mrwillson2u/propmesh/docs/console-show-sync.md

# Saving and playing sequences when boards come and go (2026-10-24)

Colin, trying to build the first sequences on the yard boards: "a lot
of things are broken" — boards in the picker reported as unavailable on
save though their pin editor works; Save and Play inconsistent; after
a partial save, Play dead and Save dead; boards marked yellow never
clearing when they came back. "Think through every possible scenario."

This is that audit: how a sequence moves between the console and the
boards, every state a board can be in while it does, what the console
did in each, and what it does now. One doc, so the logic has one place.

## 1. The moving parts

- A sequence is stored **on each board that has steps in it**, as that
  board's part. Save = one `set_sequence` per board (parallel), each
  stamped with the same `at` (UTC second from the console's clock).
- The console talks to boards **through the bridge** over WiFi. A
  request to a board that doesn't answer times out on the bridge after
  6 s (`REMOTE_TIMEOUT_MS`); the bridge holds at most 6 forwarded
  requests at once (`MAX_PENDING`, `pm_link.cpp`).
- The bridge **mirrors** every `set_sequence` / `delete_sequence` /
  `set_rules` it forwards (`pm_show_mirror`), whether or not the board
  answered, and bumps `show_at` on its time beacon. A board whose
  `show_synced` is behind pulls its own part (`pull_index`, `pull_seq`)
  when it next hears the beacon — a battery board on its check-in, or
  a mains board within seconds (generic-boards §6k).
- A board holding a **newer** `at` than a request's answers `ok` with
  `stale: true` and keeps its own copy.
- **Play** is one `cue` to the connected board, which broadcasts it;
  every board that holds a part and is not `off` plays. The connected
  board refuses the cue only when *it* is off.
- A battery board in the show tier listens in windows; a request to it
  is preceded by a wake burst (`pm_link.cpp` "waking"). Any
  non-background request holds it fully awake for 10 min; `hello`,
  `mesh`, `state`, `ota_status`, `ble` don't.
- The Sequences view **loads** from every board that has introduced
  itself this session: `get_config` (pins, for the pickers), `get_show`
  and one `get_sequence` per part. A board that doesn't answer is
  *unreachable*; through a bridge its part is shown from the bridge's
  copy (`fromBridge`) and its pins from the previous load.
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
