mrwillson2u/propmesh/hardware/pro/layout-placement.png

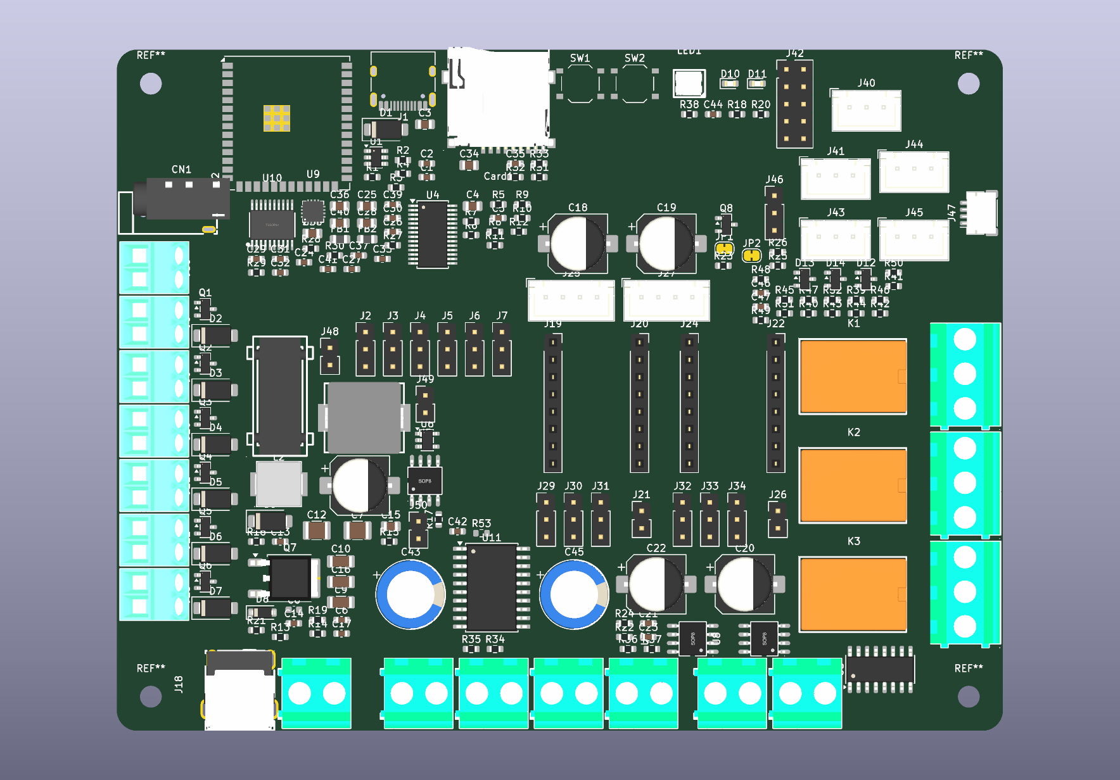
hardware/pro/layout-placement.png
