mrwillson2u/propmesh/hardware/pro/sheets/01-power.diagram.png

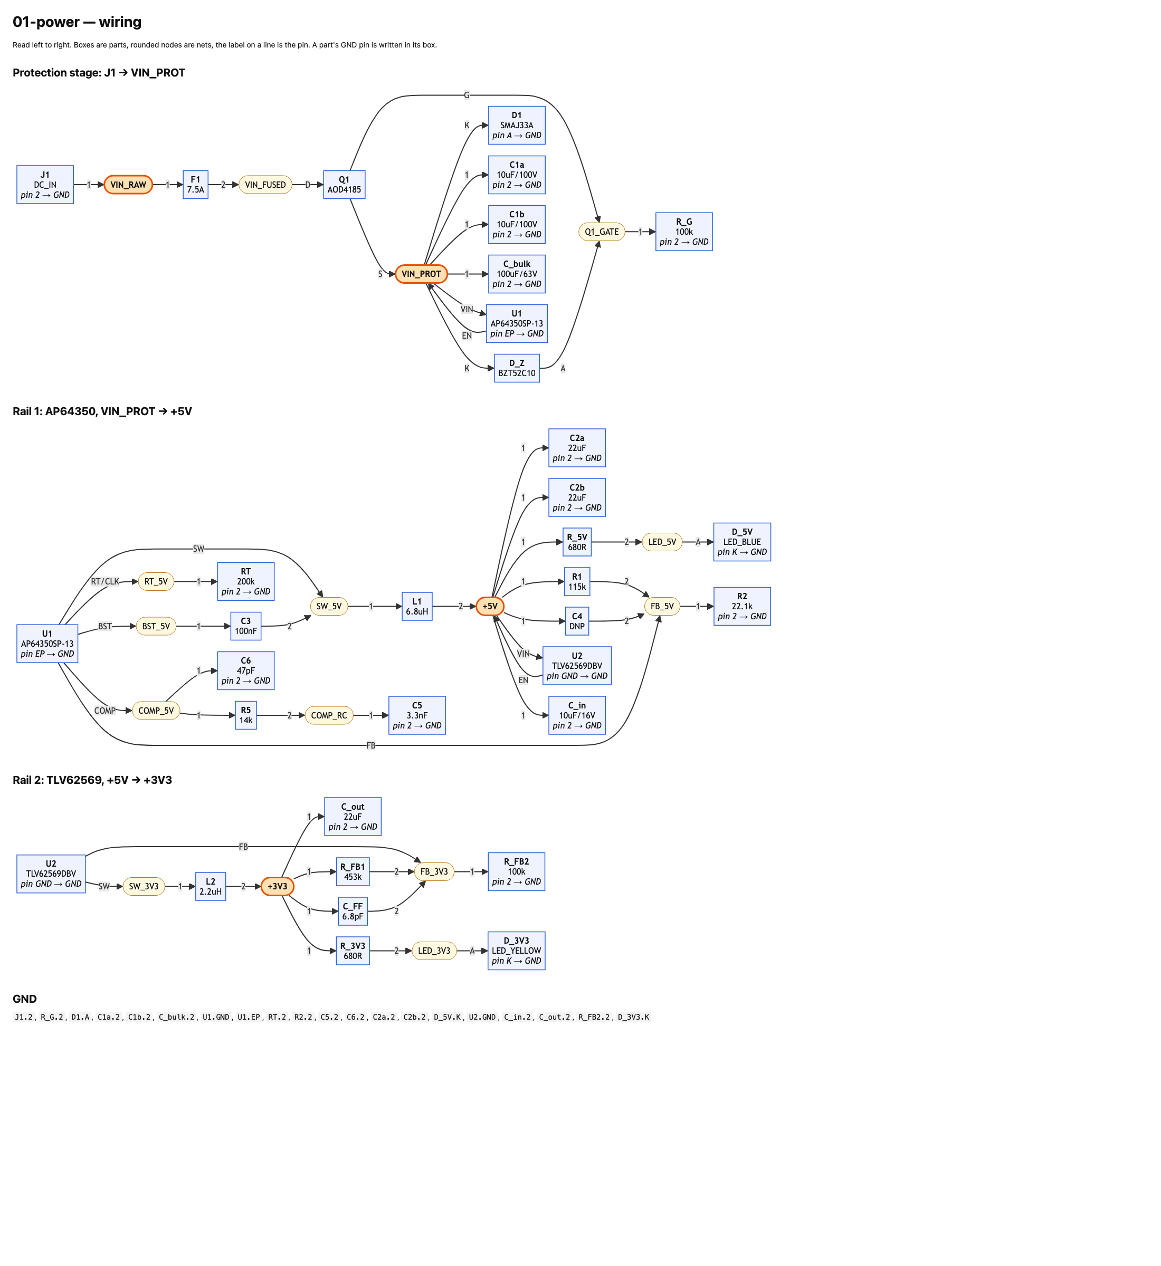
hardware/pro/sheets/01-power.diagram.png
