mrwillson2u/propmesh/reference/design_handoff_propmesh_console/screenshots/1a-survey-desktop.png

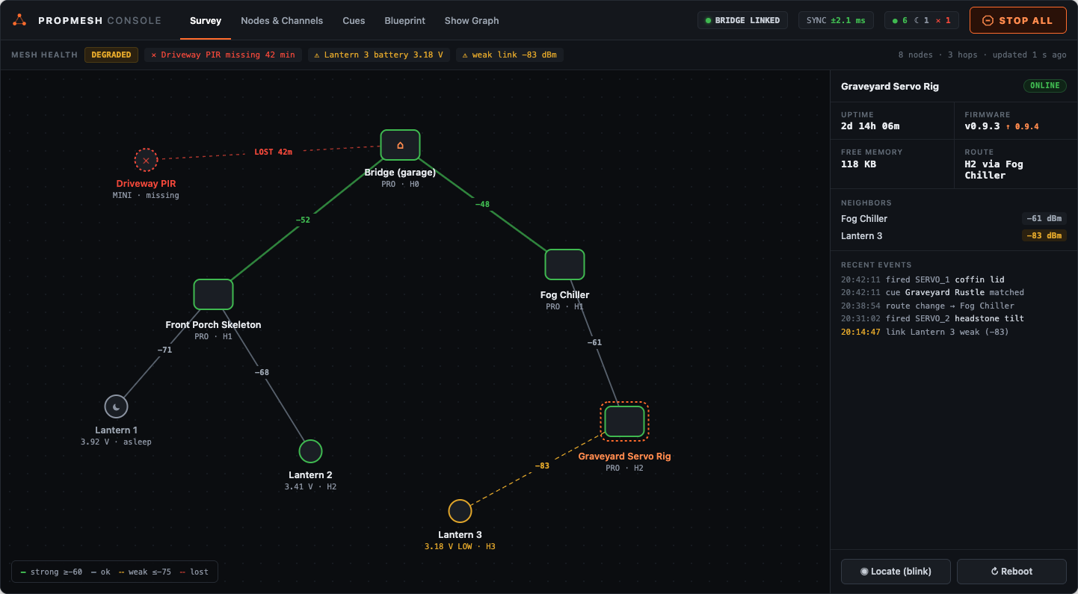
reference/design_handoff_propmesh_console/screenshots/1a-survey-desktop.png
