mrwillson2u/propmesh/reference/design_handoff_propmesh_console/screenshots/1d-cues.png

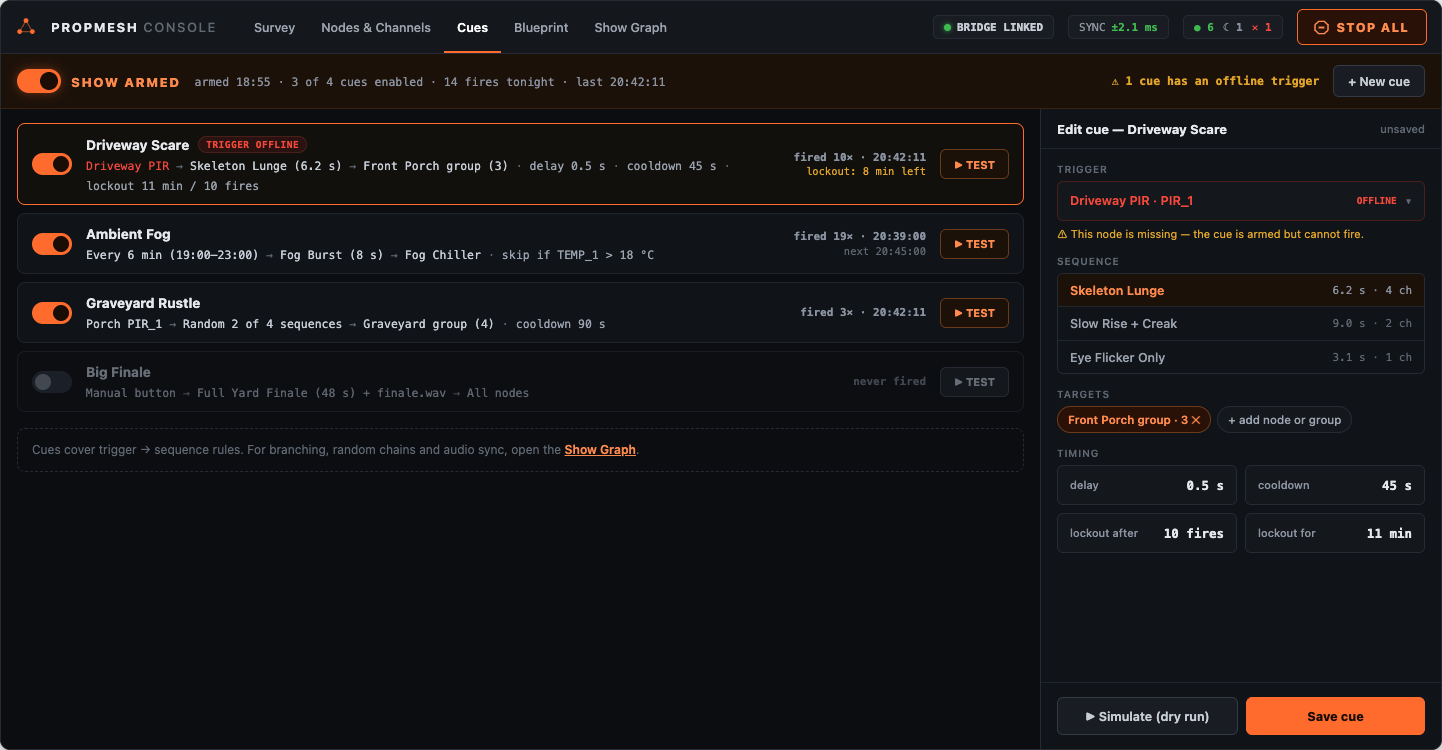
reference/design_handoff_propmesh_console/screenshots/1d-cues.png
