mrwillson2u/propmesh/reference/design_handoff_propmesh_console/screenshots/1f-blueprint-phone.png

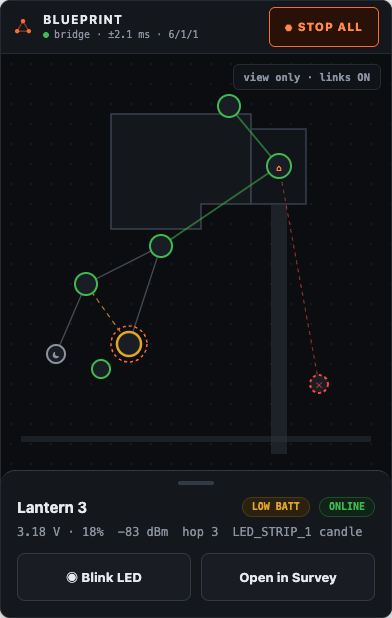
reference/design_handoff_propmesh_console/screenshots/1f-blueprint-phone.png
