mrwillson2u/propmesh/reference/design_handoff_propmesh_console/screenshots/1g-show-graph.png

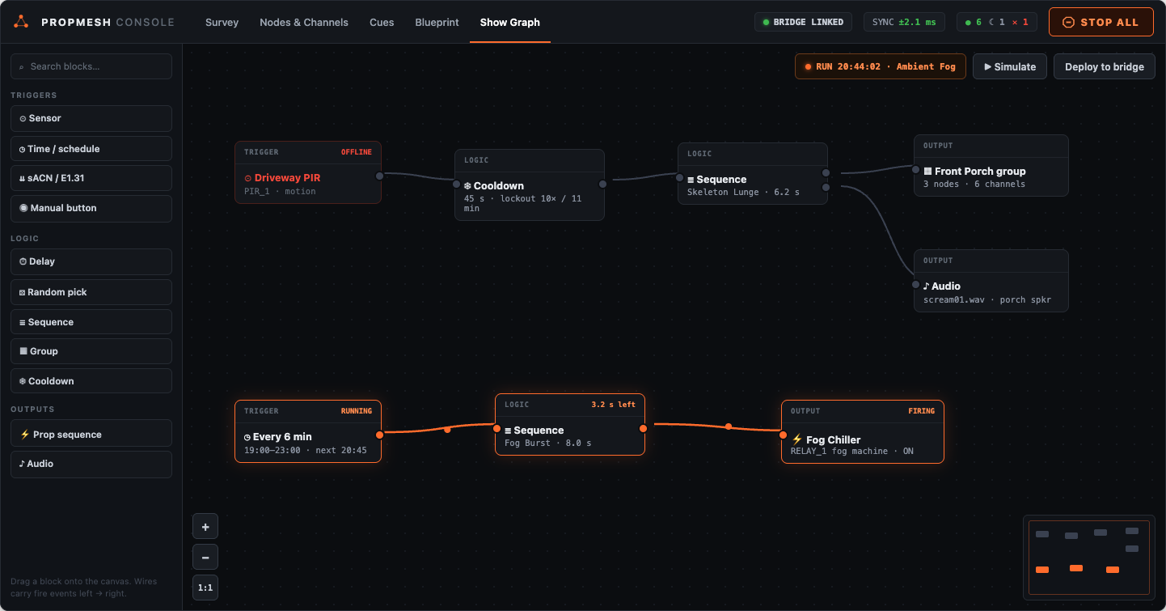
reference/design_handoff_propmesh_console/screenshots/1g-show-graph.png
