mrwillson2u/propmesh/website/src/assets/console/nodes-firmware.png

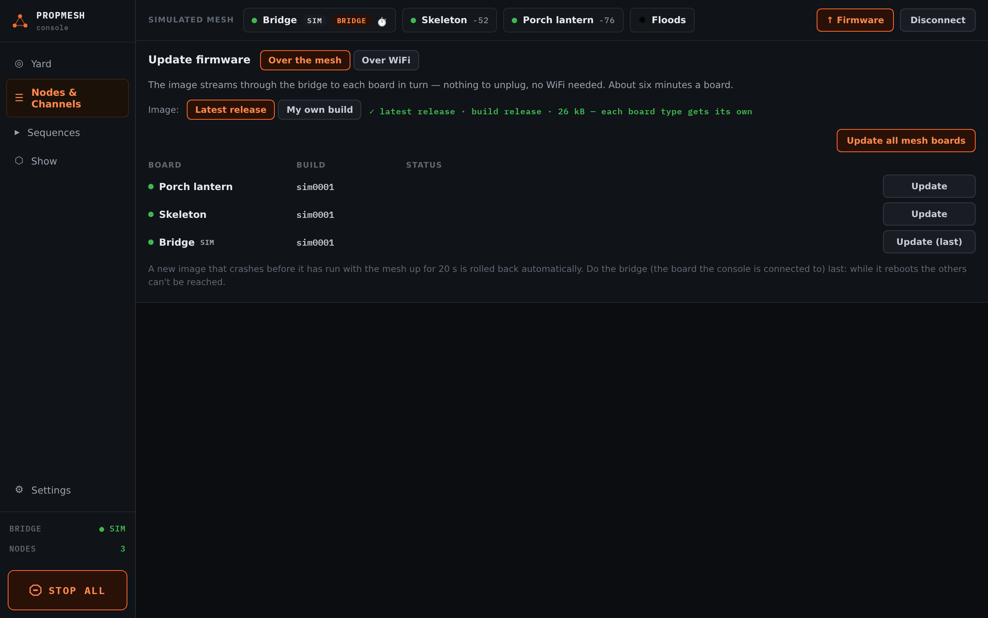
website/src/assets/console/nodes-firmware.png
