mrwillson2u/propmesh/website/src/assets/console/nodes-roster.png

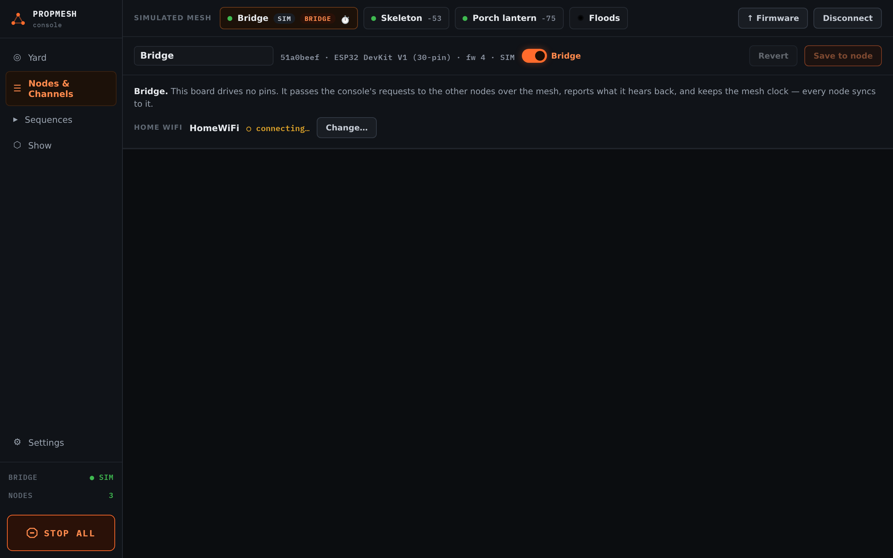
website/src/assets/console/nodes-roster.png
