mrwillson2u/propmesh/website/src/assets/console/yard-topology-detail.png

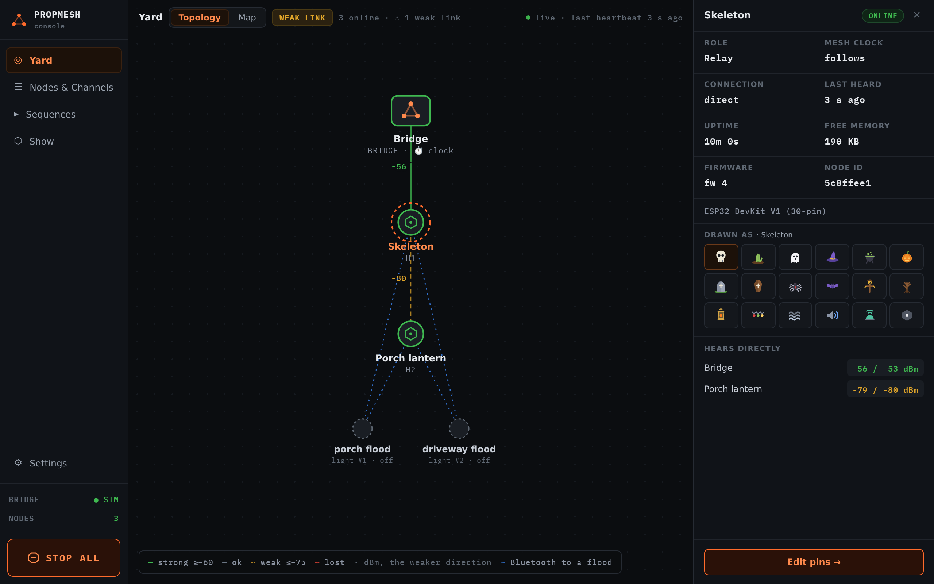
website/src/assets/console/yard-topology-detail.png
