mrwillson2u/propmesh/reference/design_handoff_propmesh_console/screenshots/1h-component-sheet.png

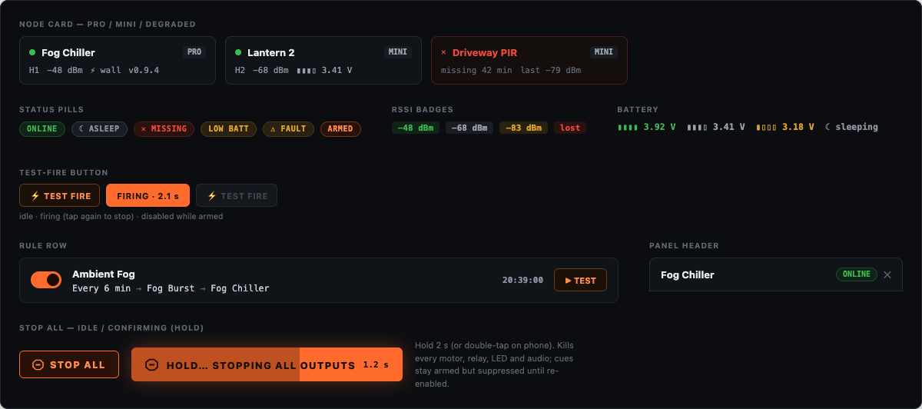
reference/design_handoff_propmesh_console/screenshots/1h-component-sheet.png
