mrwillson2u/propmesh/hardware/pro/propmesh/propmesh.kicad_pcb

## KiCad design hardware/pro/propmesh/propmesh.kicad_pcb (2026-10-11)

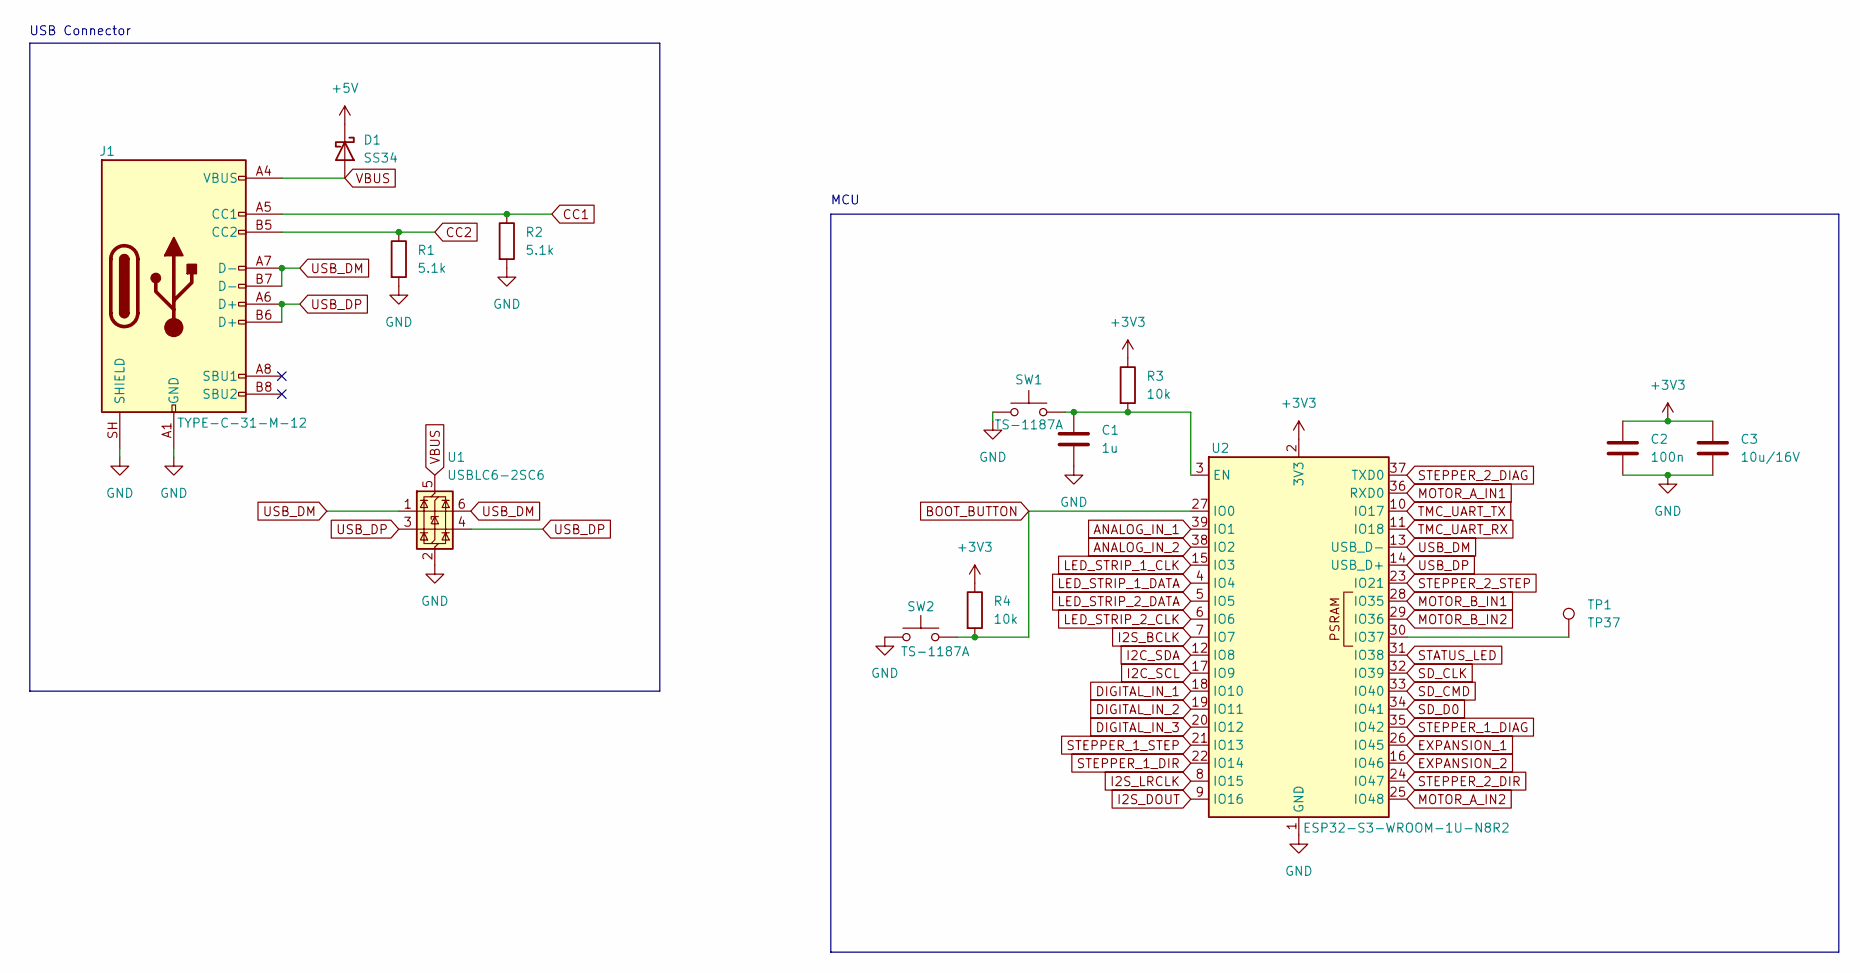
[picture p11: schematic mcu+usb.kicad_sch]

Parts:
C1: 1u; C_0603_1608Metric
C2: 100n; C_0603_1608Metric
C3: 10u/16V; C_0805_2012Metric
D1: SS34; D_SMA
J1: TYPE-C-31-M-12; USB_C_Receptacle_HRO_TYPE-C-31-M-12
R1, R2: 5.1k; R_0603_1608Metric
R3, R4: 10k; R_0603_1608Metric
SW1, SW2: TS-1187A; SW_Push_1P1T_XKB_TS-1187A
TP1: TP37; TestPoint_Pad_1.5x1.5mm
U1: USBLC6-2SC6; SOT-23-6
U2: ESP32-S3-WROOM-1U-N8R2; ESP32-S3-WROOM-1U

Connections:
+3V3: C2.1, C3.1, R3.1, R4.1, U2.2 (3V3); also elsewhere on the board
ANALOG_IN_1: U2.39 (IO1); also elsewhere on the board
ANALOG_IN_2: U2.38 (IO2); also elsewhere on the board
BOOT_BUTTON: R4.2, SW2.2, U2.27 (IO0); also elsewhere on the board
CC1: J1.A5 (CC1), R2.1
CC2: J1.B5 (CC2), R1.1
DIGITAL_IN_1: U2.18 (IO10); also elsewhere on the board
DIGITAL_IN_2: U2.19 (IO11); also elsewhere on the board
DIGITAL_IN_3: U2.20 (IO12); also elsewhere on the board
EXPANSION_1: U2.26 (IO45); also elsewhere on the board
EXPANSION_2: U2.16 (IO46); also elsewhere on the board
GND: C1.2, C2.2, C3.2, J1.A1 (GND), J1.A12 (GND), J1.B1 (GND), J1.B12 (GND), J1.SH (SHIELD), R1.2, R2.2, SW1.1, SW2.1, U1.2 (GND), U2.1 (GND), U2.40 (GND), U2.41 (GND); also elsewhere on the board
I2C_SCL: U2.17 (IO9); also elsewhere on the board
I2C_SDA: U2.12 (IO8); also elsewhere on the board
I2S_BCLK: U2.7 (IO7); also elsewhere on the board
I2S_DOUT: U2.9 (IO16); also elsewhere on the board
I2S_LRCLK: U2.8 (IO15); also elsewhere on the board
LED_STRIP_1_CLK: U2.15 (IO3); also elsewhere on the board
LED_STRIP_1_DATA: U2.4 (IO4); also elsewhere on the board
LED_STRIP_2_CLK: U2.6 (IO6); also elsewhere on the board
LED_STRIP_2_DATA: U2.5 (IO5); also elsewhere on the board
MOTOR_A_IN1: U2.36 (RXD0); also elsewhere on the board
MOTOR_A_IN2: U2.25 (IO48); also elsewhere on the board
MOTOR_B_IN1: U2.28 (IO35); also elsewhere on the board
MOTOR_B_IN2: U2.29 (IO36); also elsewhere on the board
unnamed 116: D1.1 (K); also elsewhere on the board
unnamed: C1.1, R3.2, SW1.2, U2.3 (EN)
SD_CLK: U2.32 (IO39); also elsewhere on the board
SD_CMD: U2.33 (IO40); also elsewhere on the board
SD_D0: U2.34 (IO41); also elsewhere on the board
STATUS_LED: U2.31 (IO38); also elsewhere on the board
STEPPER_1_DIAG: U2.35 (IO42); also elsewhere on the board
STEPPER_1_DIR: U2.22 (IO14); also elsewhere on the board
STEPPER_1_STEP: U2.21 (IO13); also elsewhere on the board
STEPPER_2_DIAG: U2.37 (TXD0); also elsewhere on the board
STEPPER_2_DIR: U2.24 (IO47); also elsewhere on the board
STEPPER_2_STEP: U2.23 (IO21); also elsewhere on the board
TMC_UART_RX: U2.11 (IO18); also elsewhere on the board
TMC_UART_TX: U2.10 (IO17); also elsewhere on the board
VBUS: D1.2 (A), J1.A4 (VBUS), J1.A9 (VBUS), J1.B4 (VBUS), J1.B9 (VBUS), U1.5 (VBUS); also elsewhere on the board

Notes on the sheet:
MCU
USB Connector

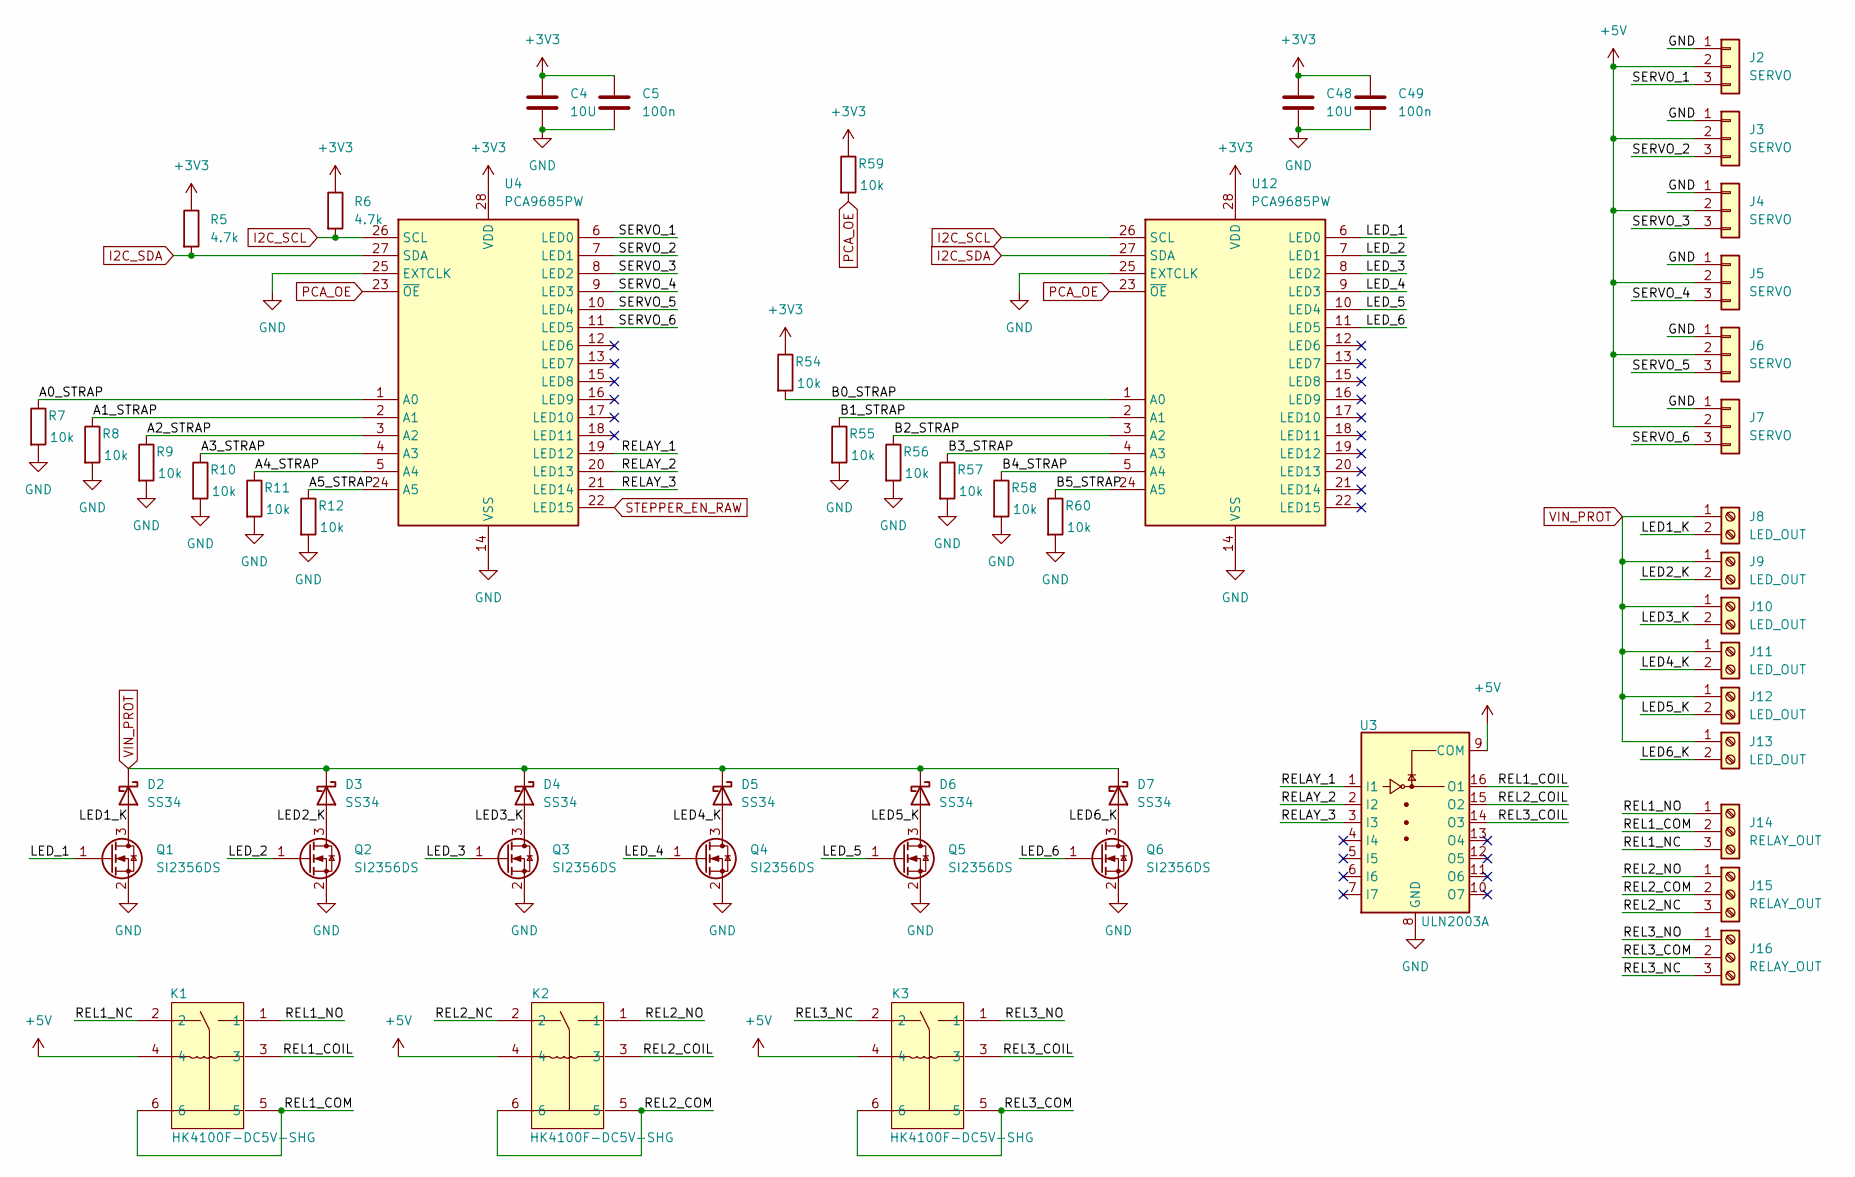
[picture p12: schematic outputs.kicad_sch]

Parts:
C4, C48: 10U; C_0805_2012Metric
C5, C49: 100n; C_0603_1608Metric
D2, D3, D4, D5, D6, D7: SS34; D_SMA
J2, J3, J4, J5, J6, J7: SERVO; PinHeader_1x03_P2.54mm_Vertical
J8, J9, J10, J11, J12, J13: LED_OUT; CONN-TH_DG381S-3.5-02P-14-00A-H
J14, J15, J16: RELAY_OUT; CONN-TH_DG128-5.0-03P-14-00A-H
K1, K2, K3: HK4100F-DC5V-SHG; RELAY-TH_HK4100F-DC5V-SHG; MPN HK4100F-DC5V-SHG; LCSC Part C12072
Q1, Q2, Q3, Q4, Q5, Q6: SI2356DS; SOT-23
R5, R6: 4.7k; R_0603_1608Metric
R7, R8, R9, R10, R11, R12, R54, R55, R56, R57, R58, R59, R60: 10k; R_0603_1608Metric
U3: ULN2003A; SOIC-16_3.9x9.9mm_P1.27mm
U4, U12: PCA9685PW; TSSOP-28_4.4x9.7mm_P0.65mm

Connections:
+3V3: C4.1, C5.1, C48.1, C49.1, R5.1, R6.1, R54.1, R59.1, U4.28 (VDD), U12.28 (VDD); also elsewhere on the board
+5V: J2.2, J3.2, J4.2, J5.2, J6.2, J7.2, K1.4, K2.4, K3.4, U3.9 (COM); also elsewhere on the board
/Outputs/A0_STRAP: R7.1, U4.1 (A0)
/Outputs/A1_STRAP: R8.1, U4.2 (A1)
/Outputs/A2_STRAP: R9.1, U4.3 (A2)
/Outputs/A3_STRAP: R10.1, U4.4 (A3)
/Outputs/A4_STRAP: R11.1, U4.5 (A4)
/Outputs/A5_STRAP: R12.1, U4.24 (A5)
/Outputs/B0_STRAP: R54.2, U12.1 (A0)
/Outputs/B1_STRAP: R55.1, U12.2 (A1)
/Outputs/B2_STRAP: R56.1, U12.3 (A2)
/Outputs/B3_STRAP: R57.1, U12.4 (A3)
/Outputs/B4_STRAP: R58.1, U12.5 (A4)
/Outputs/B5_STRAP: R60.1, U12.24 (A5)
/Outputs/LED1_K: D2.2 (A), J8.2, Q1.3 (D)
/Outputs/LED2_K: D3.2 (A), J9.2, Q2.3 (D)
/Outputs/LED3_K: D4.2 (A), J10.2, Q3.3 (D)
/Outputs/LED4_K: D5.2 (A), J11.2, Q4.3 (D)
/Outputs/LED5_K: D6.2 (A), J12.2, Q5.3 (D)
/Outputs/LED6_K: D7.2 (A), J13.2, Q6.3 (D)
/Outputs/LED_1: Q1.1 (G), U12.6 (LED0)
/Outputs/LED_2: Q2.1 (G), U12.7 (LED1)
/Outputs/LED_3: Q3.1 (G), U12.8 (LED2)
/Outputs/LED_4: Q4.1 (G), U12.9 (LED3)
/Outputs/LED_5: Q5.1 (G), U12.10 (LED4)
/Outputs/LED_6: Q6.1 (G), U12.11 (LED5)
/Outputs/REL1_COIL: K1.3, U3.16 (O1)
/Outputs/REL1_COM: J14.2, K1.5, K1.6
/Outputs/REL1_NC: J14.3, K1.2
/Outputs/REL1_NO: J14.1, K1.1
/Outputs/REL2_COIL: K2.3, U3.15 (O2)
/Outputs/REL2_COM: J15.2, K2.5, K2.6
/Outputs/REL2_NC: J15.3, K2.2
/Outputs/REL2_NO: J15.1, K2.1
/Outputs/REL3_COIL: K3.3, U3.14 (O3)
/Outputs/REL3_COM: J16.2, K3.5, K3.6
/Outputs/REL3_NC: J16.3, K3.2
/Outputs/REL3_NO: J16.1, K3.1
/Outputs/RELAY_1: U3.1 (I1), U4.19 (LED12)
/Outputs/RELAY_2: U3.2 (I2), U4.20 (LED13)
/Outputs/RELAY_3: U3.3 (I3), U4.21 (LED14)
/Outputs/SERVO_1: J2.3, U4.6 (LED0)
/Outputs/SERVO_2: J3.3, U4.7 (LED1)
/Outputs/SERVO_3: J4.3, U4.8 (LED2)
/Outputs/SERVO_4: J5.3, U4.9 (LED3)
/Outputs/SERVO_5: J6.3, U4.10 (LED4)
/Outputs/SERVO_6: J7.3, U4.11 (LED5)
GND: C4.2, C5.2, C48.2, C49.2, J2.1, J3.1, J4.1, J5.1, J6.1, J7.1, Q1.2 (S), Q2.2 (S), Q3.2 (S), Q4.2 (S), Q5.2 (S), Q6.2 (S), R7.2, R8.2, R9.2, R10.2, R11.2, R12.2, R55.2, R56.2, R57.2, R58.2, R60.2, U3.8 (GND), U4.14 (VSS), U4.25 (EXTCLK), U12.14 (VSS), U12.25 (EXTCLK); also elsewhere on the board
I2C_SCL: R6.2, U4.26 (SCL), U12.26 (SCL); also elsewhere on the board
I2C_SDA: R5.2, U4.27 (SDA), U12.27 (SDA); also elsewhere on the board
STEPPER_EN_RAW: U4.22 (LED15); also elsewhere on the board
VIN_PROT: D2.1 (K), D3.1 (K), D4.1 (K), D5.1 (K), D6.1 (K), D7.1 (K), J8.1, J9.1, J10.1, J11.1, J12.1, J13.1; also elsewhere on the board

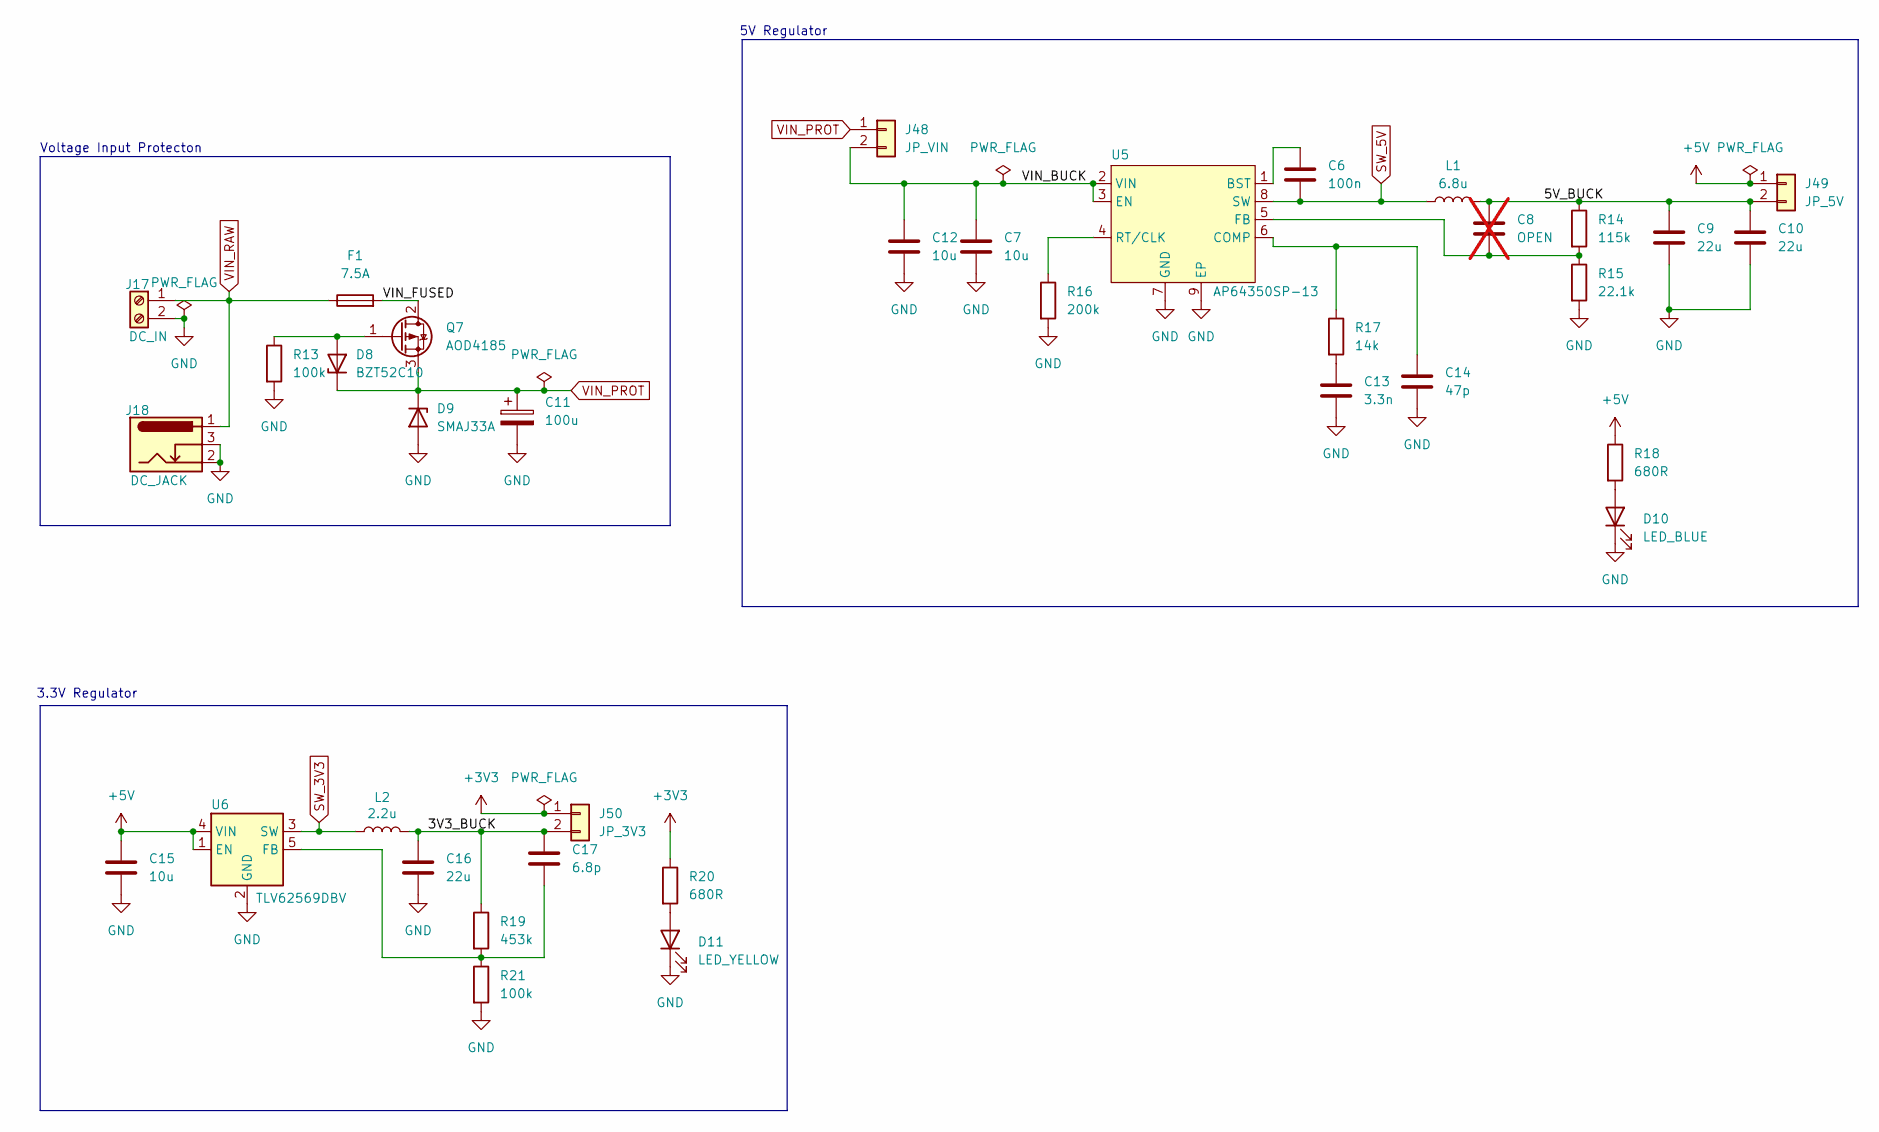
[picture p13: schematic power.kicad_sch]

Parts:
C6: 100n; C_0603_1608Metric
C7, C12: 10u; C_1210_3225Metric
C8: OPEN; C_0603_1608Metric; not fitted
C9, C10, C16: 22u; C_1206_3216Metric
C11: 100u; CP_Elec_8x10.5
C13: 3.3n; C_0603_1608Metric
C14: 47p; C_0603_1608Metric
C15: 10u; C_0805_2012Metric
C17: 6.8p; C_0603_1608Metric
D8: BZT52C10; D_SOD-123
D9: SMAJ33A; D_SMA
D10: LED_BLUE; LED_0603_1608Metric
D11: LED_YELLOW; LED_0603_1608Metric
F1: 7.5A; 01530008Z
J17: DC_IN; CONN-TH_DG128-5.0-02P-14-00A-H
J18: DC_JACK; DC-IN-TH_DC-044A-20A
J48: JP_VIN; PinHeader_1x02_P2.54mm_Vertical
J49: JP_5V; PinHeader_1x02_P2.54mm_Vertical
J50: JP_3V3; PinHeader_1x02_P2.54mm_Vertical
L1: 6.8u; IND-SMD_L11.5-W10.0
L2: 2.2u; IND-SMD_L7.1-W6.6
Q7: AOD4185; TO-252-2
R13, R21: 100k; R_0603_1608Metric
R14: 115k; R_0603_1608Metric
R15: 22.1k; R_0603_1608Metric
R16: 200k; R_0603_1608Metric
R17: 14k; R_0603_1608Metric
R18, R20: 680R; R_0603_1608Metric
R19: 453k; R_0603_1608Metric
U5: AP64350SP-13; SO-8_L4.9-W3.9-P1.27-LS6.0-BL-EP; MPN AP64350SP-13; LCSC Part C2071691
U6: TLV62569DBV; SOT-23-5

Connections:
+3V3: J50.1, R20.1; also elsewhere on the board
+5V: C15.1, J49.1, R18.1, U6.1 (EN), U6.4 (VIN); also elsewhere on the board
/Power/3V3_BUCK: C16.1, C17.1, J50.2, L2.2, R19.1
/Power/5V_BUCK: C8.1, C9.1, C10.1, J49.2, L1.2, R14.1
/Power/VIN_BUCK: C7.1, C12.1, J48.2, U5.2 (VIN), U5.3 (EN)
/Power/VIN_FUSED: F1.2, Q7.2 (D)
GND: C7.2, C9.2, C10.2, C11.2, C12.2, C13.2, C14.2, C15.2, C16.2, D9.2 (A), D10.1 (K), D11.1 (K), J17.2, J18.2, J18.3, R13.2, R15.2, R16.2, R21.2, U5.7 (GND), U5.9 (EP), U6.2 (GND); also elsewhere on the board
unnamed: C13.1, R17.2
unnamed: D8.2 (A), Q7.1 (G), R13.1
unnamed: D10.2 (A), R18.2
unnamed: D11.2 (A), R20.2
unnamed: C6.1, U5.1 (BST)
unnamed: C14.1, R17.1, U5.6 (COMP)
unnamed: C8.2, R14.2, R15.1, U5.5 (FB)
unnamed: R16.1, U5.4 (RT/CLK)
unnamed: C17.2, R19.2, R21.1, U6.5 (FB)
SW_3V3: L2.1, U6.3 (SW)
SW_5V: C6.2, L1.1, U5.8 (SW)
VIN_PROT: C11.1, D8.1 (K), D9.1 (K), J48.1, Q7.3 (S); also elsewhere on the board
VIN_RAW: F1.1, J17.1, J18.1; also elsewhere on the board

Notes on the sheet:
Voltage Input Protecton
3.3V Regulator
5V Regulator

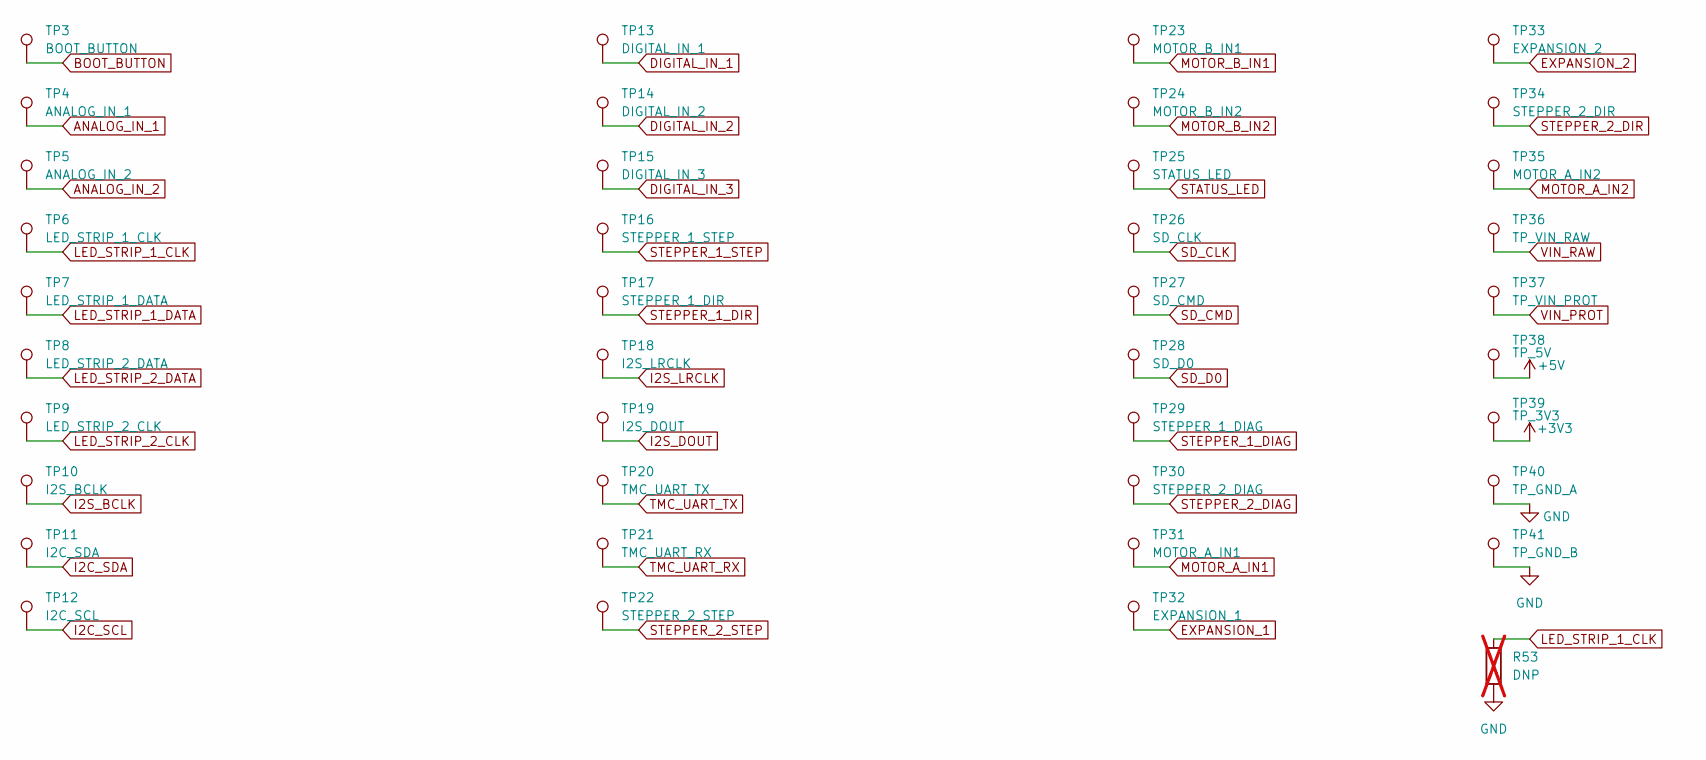
[picture p14: schematic testpoints.kicad_sch]

Parts:
R53: DNP; R_0603_1608Metric; not fitted
TP3: BOOT_BUTTON; TestPoint_Pad_1.5x1.5mm
TP4: ANALOG_IN_1; TestPoint_Pad_1.5x1.5mm
TP5: ANALOG_IN_2; TestPoint_Pad_1.5x1.5mm
TP6: LED_STRIP_1_CLK; TestPoint_Pad_1.5x1.5mm
TP7: LED_STRIP_1_DATA; TestPoint_Pad_1.5x1.5mm
TP8: LED_STRIP_2_DATA; TestPoint_Pad_1.5x1.5mm
TP9: LED_STRIP_2_CLK; TestPoint_Pad_1.5x1.5mm
TP10: I2S_BCLK; TestPoint_Pad_1.5x1.5mm
TP11: I2C_SDA; TestPoint_Pad_1.5x1.5mm
TP12: I2C_SCL; TestPoint_Pad_1.5x1.5mm
TP13: DIGITAL_IN_1; TestPoint_Pad_1.5x1.5mm
TP14: DIGITAL_IN_2; TestPoint_Pad_1.5x1.5mm
TP15: DIGITAL_IN_3; TestPoint_Pad_1.5x1.5mm
TP16: STEPPER_1_STEP; TestPoint_Pad_1.5x1.5mm
TP17: STEPPER_1_DIR; TestPoint_Pad_1.5x1.5mm
TP18: I2S_LRCLK; TestPoint_Pad_1.5x1.5mm
TP19: I2S_DOUT; TestPoint_Pad_1.5x1.5mm
TP20: TMC_UART_TX; TestPoint_Pad_1.5x1.5mm
TP21: TMC_UART_RX; TestPoint_Pad_1.5x1.5mm
TP22: STEPPER_2_STEP; TestPoint_Pad_1.5x1.5mm
TP23: MOTOR_B_IN1; TestPoint_Pad_1.5x1.5mm
TP24: MOTOR_B_IN2; TestPoint_Pad_1.5x1.5mm
TP25: STATUS_LED; TestPoint_Pad_1.5x1.5mm
TP26: SD_CLK; TestPoint_Pad_1.5x1.5mm
TP27: SD_CMD; TestPoint_Pad_1.5x1.5mm
TP28: SD_D0; TestPoint_Pad_1.5x1.5mm
TP29: STEPPER_1_DIAG; TestPoint_Pad_1.5x1.5mm
TP30: STEPPER_2_DIAG; TestPoint_Pad_1.5x1.5mm
TP31: MOTOR_A_IN1; TestPoint_Pad_1.5x1.5mm
TP32: EXPANSION_1; TestPoint_Pad_1.5x1.5mm
TP33: EXPANSION_2; TestPoint_Pad_1.5x1.5mm
TP34: STEPPER_2_DIR; TestPoint_Pad_1.5x1.5mm
TP35: MOTOR_A_IN2; TestPoint_Pad_1.5x1.5mm
TP36: TP_VIN_RAW; TestPoint_Pad_1.5x1.5mm
TP37: TP_VIN_PROT; TestPoint_Pad_1.5x1.5mm
TP38: TP_5V; TestPoint_Pad_1.5x1.5mm
TP39: TP_3V3; TestPoint_Pad_1.5x1.5mm
TP40: TP_GND_A; TestPoint_Pad_1.5x1.5mm
TP41: TP_GND_B; TestPoint_Pad_1.5x1.5mm

Connections:
+3V3: TP39.1 (1_1); also elsewhere on the board
+5V: TP38.1 (1_1); also elsewhere on the board
ANALOG_IN_1: TP4.1 (1_1); also elsewhere on the board
ANALOG_IN_2: TP5.1 (1_1); also elsewhere on the board
BOOT_BUTTON: TP3.1 (1_1); also elsewhere on the board
DIGITAL_IN_1: TP13.1 (1_1); also elsewhere on the board
DIGITAL_IN_2: TP14.1 (1_1); also elsewhere on the board
DIGITAL_IN_3: TP15.1 (1_1); also elsewhere on the board
EXPANSION_1: TP32.1 (1_1); also elsewhere on the board
EXPANSION_2: TP33.1 (1_1); also elsewhere on the board
GND: R53.2, TP40.1 (1_1), TP41.1 (1_1); also elsewhere on the board
I2C_SCL: TP12.1 (1_1); also elsewhere on the board
I2C_SDA: TP11.1 (1_1); also elsewhere on the board
I2S_BCLK: TP10.1 (1_1); also elsewhere on the board
I2S_DOUT: TP19.1 (1_1); also elsewhere on the board
I2S_LRCLK: TP18.1 (1_1); also elsewhere on the board
LED_STRIP_1_CLK: R53.1, TP6.1 (1_1); also elsewhere on the board
LED_STRIP_1_DATA: TP7.1 (1_1); also elsewhere on the board
LED_STRIP_2_CLK: TP9.1 (1_1); also elsewhere on the board
LED_STRIP_2_DATA: TP8.1 (1_1); also elsewhere on the board
MOTOR_A_IN1: TP31.1 (1_1); also elsewhere on the board
MOTOR_A_IN2: TP35.1 (1_1); also elsewhere on the board
MOTOR_B_IN1: TP23.1 (1_1); also elsewhere on the board
MOTOR_B_IN2: TP24.1 (1_1); also elsewhere on the board
SD_CLK: TP26.1 (1_1); also elsewhere on the board
SD_CMD: TP27.1 (1_1); also elsewhere on the board
SD_D0: TP28.1 (1_1); also elsewhere on the board
STATUS_LED: TP25.1 (1_1); also elsewhere on the board
STEPPER_1_DIAG: TP29.1 (1_1); also elsewhere on the board
STEPPER_1_DIR: TP17.1 (1_1); also elsewhere on the board
STEPPER_1_STEP: TP16.1 (1_1); also elsewhere on the board
STEPPER_2_DIAG: TP30.1 (1_1); also elsewhere on the board
STEPPER_2_DIR: TP34.1 (1_1); also elsewhere on the board
STEPPER_2_STEP: TP22.1 (1_1); also elsewhere on the board
TMC_UART_RX: TP21.1 (1_1); also elsewhere on the board
TMC_UART_TX: TP20.1 (1_1); also elsewhere on the board
VIN_PROT: TP37.1 (1_1); also elsewhere on the board
VIN_RAW: TP36.1 (1_1); also elsewhere on the board

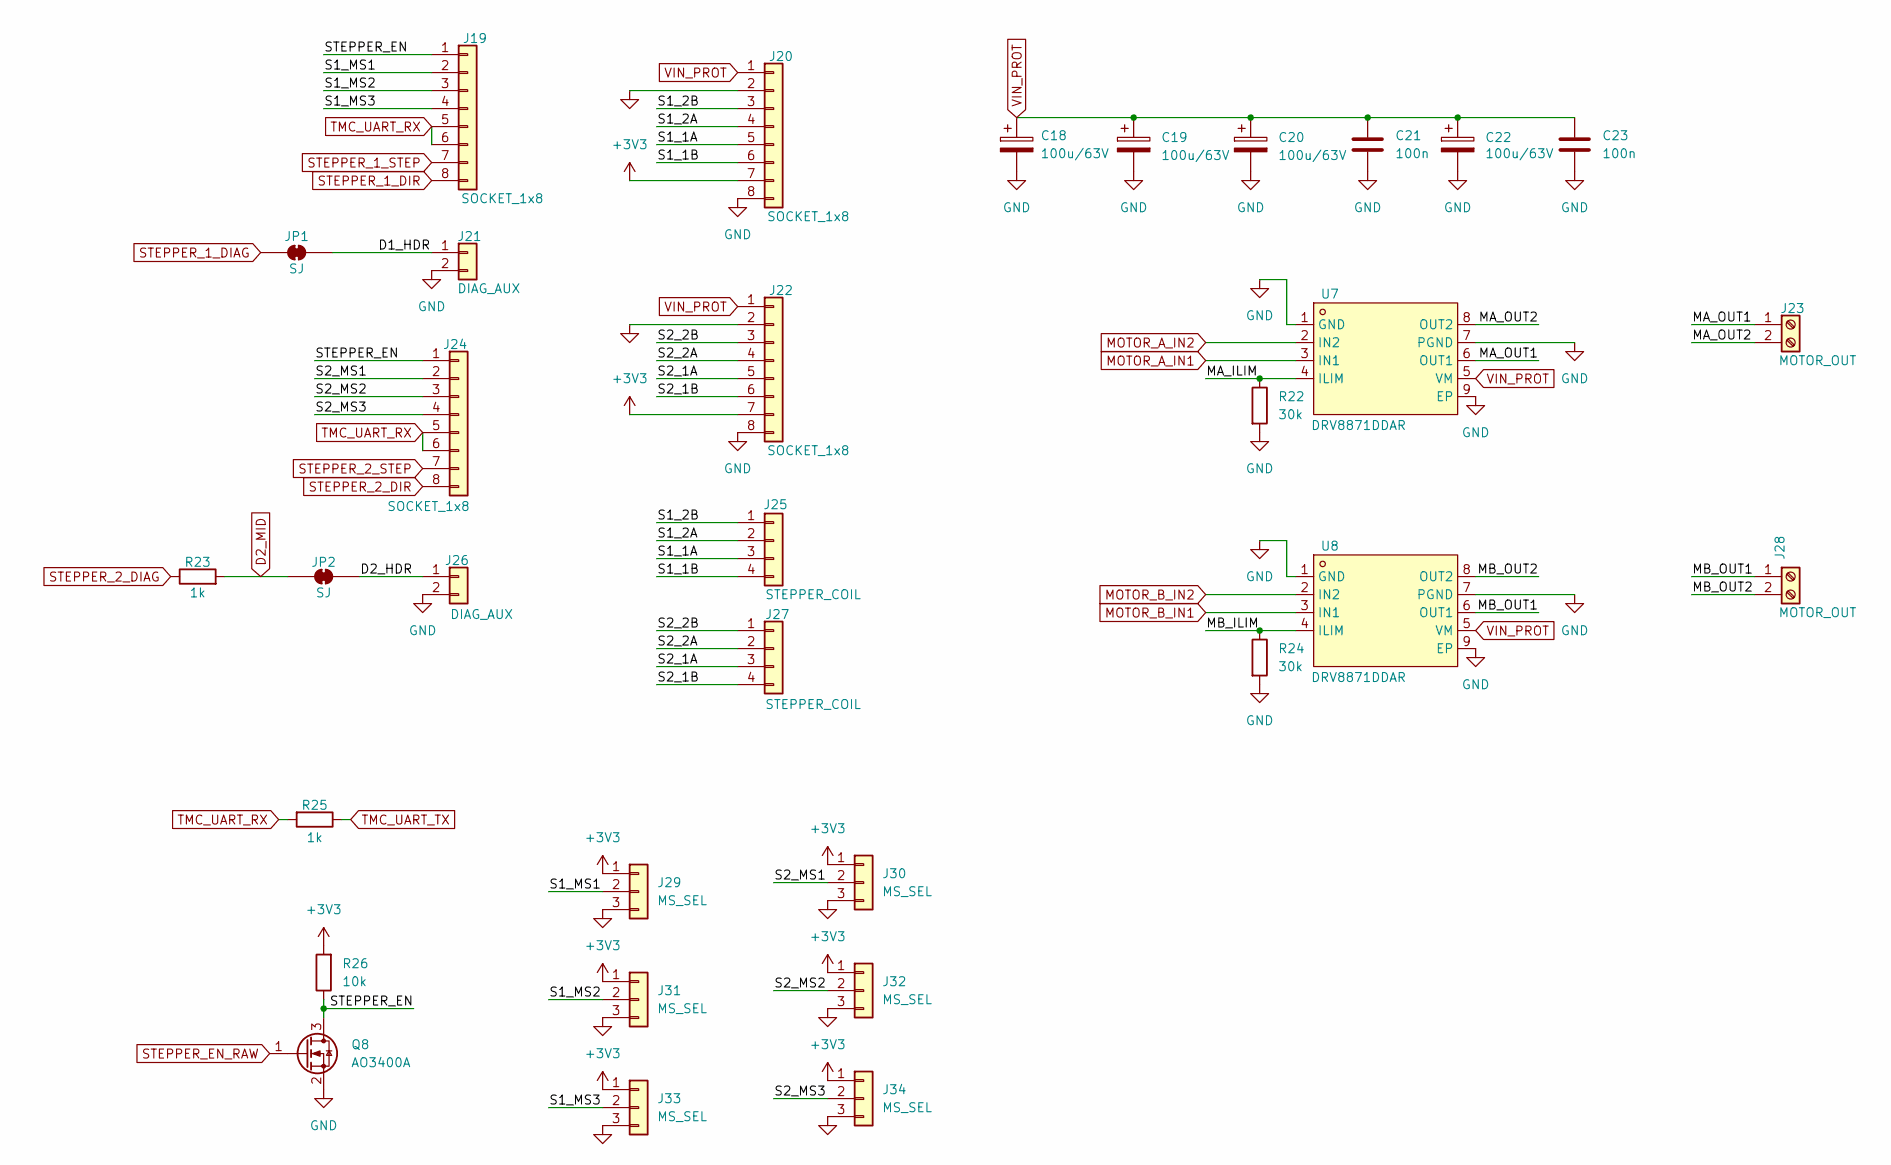
[picture p15: schematic motors.kicad_sch]

Parts:
C18, C19, C20, C22: 100u/63V; CP_Elec_8x10.5
C21, C23: 100n; C_0603_1608Metric
J19, J20, J22, J24: SOCKET_1x8; PinSocket_1x08_P2.54mm_Vertical
J21, J26: DIAG_AUX; PinHeader_1x02_P2.54mm_Vertical
J23, J28: MOTOR_OUT; CONN-TH_DG128-5.0-02P-14-00A-H
J25, J27: STEPPER_COIL; JST_XH_B4B-XH-A_1x04_P2.50mm_Vertical
J29, J30, J31, J32, J33, J34: MS_SEL; PinHeader_1x03_P2.54mm_Vertical
JP1, JP2: SJ; SolderJumper-2_P1.3mm_Bridged_RoundedPad1.0x1.5mm
Q8: AO3400A; SOT-23
R22, R24: 30k; R_0603_1608Metric
R23, R25: 1k; R_0603_1608Metric
R26: 10k; R_0603_1608Metric
U7, U8: DRV8871DDAR; SO-8EP_DRV8871DDAR; MPN DRV8871DDAR; LCSC Part C75864

Connections:
+3V3: J20.7, J22.7, J29.1, J30.1, J31.1, J32.1, J33.1, J34.1, R26.2; also elsewhere on the board
/Motors/D1_HDR: J21.1, JP1.2 (B)
/Motors/D2_HDR: J26.1, JP2.2 (B)
/Motors/MA_ILIM: R22.1, U7.4 (ILIM)
/Motors/MA_OUT1: J23.1, U7.6 (OUT1)
/Motors/MA_OUT2: J23.2, U7.8 (OUT2)
/Motors/MB_ILIM: R24.1, U8.4 (ILIM)
/Motors/MB_OUT1: J28.1, U8.6 (OUT1)
/Motors/MB_OUT2: J28.2, U8.8 (OUT2)
/Motors/S1_1A: J20.5, J25.3
/Motors/S1_1B: J20.6, J25.4
/Motors/S1_2A: J20.4, J25.2
/Motors/S1_2B: J20.3, J25.1
/Motors/S1_MS1: J19.2, J29.2
/Motors/S1_MS2: J19.3, J31.2
/Motors/S1_MS3: J19.4, J33.2
/Motors/S2_1A: J22.5, J27.3
/Motors/S2_1B: J22.6, J27.4
/Motors/S2_2A: J22.4, J27.2
/Motors/S2_2B: J22.3, J27.1
/Motors/S2_MS1: J24.2, J30.2
/Motors/S2_MS2: J24.3, J32.2
/Motors/S2_MS3: J24.4, J34.2
/Motors/STEPPER_EN: J19.1, J24.1, Q8.3 (D), R26.1
D2_MID: JP2.1 (A), R23.2; also elsewhere on the board
GND: C18.2, C19.2, C20.2, C21.2, C22.2, C23.2, J20.2, J20.8, J21.2, J22.2, J22.8, J26.2, J29.3, J30.3, J31.3, J32.3, J33.3, J34.3, Q8.2 (S), R22.2, R24.2, U7.1 (GND), U7.7 (PGND), U7.9 (EP), U8.1 (GND), U8.7 (PGND), U8.9 (EP); also elsewhere on the board
MOTOR_A_IN1: U7.3 (IN1); also elsewhere on the board
MOTOR_A_IN2: U7.2 (IN2); also elsewhere on the board
MOTOR_B_IN1: U8.3 (IN1); also elsewhere on the board
MOTOR_B_IN2: U8.2 (IN2); also elsewhere on the board
STEPPER_1_DIAG: JP1.1 (A); also elsewhere on the board
STEPPER_1_DIR: J19.8; also elsewhere on the board
STEPPER_1_STEP: J19.7; also elsewhere on the board
STEPPER_2_DIAG: R23.1; also elsewhere on the board
STEPPER_2_DIR: J24.8; also elsewhere on the board
STEPPER_2_STEP: J24.7; also elsewhere on the board
STEPPER_EN_RAW: Q8.1 (G); also elsewhere on the board
TMC_UART_RX: J19.5, J19.6, J24.5, J24.6, R25.2; also elsewhere on the board
TMC_UART_TX: R25.1; also elsewhere on the board
VIN_PROT: C18.1, C19.1, C20.1, C21.1, C22.1, C23.1, J20.1, J22.1, U7.5 (VM), U8.5 (VM); also elsewhere on the board

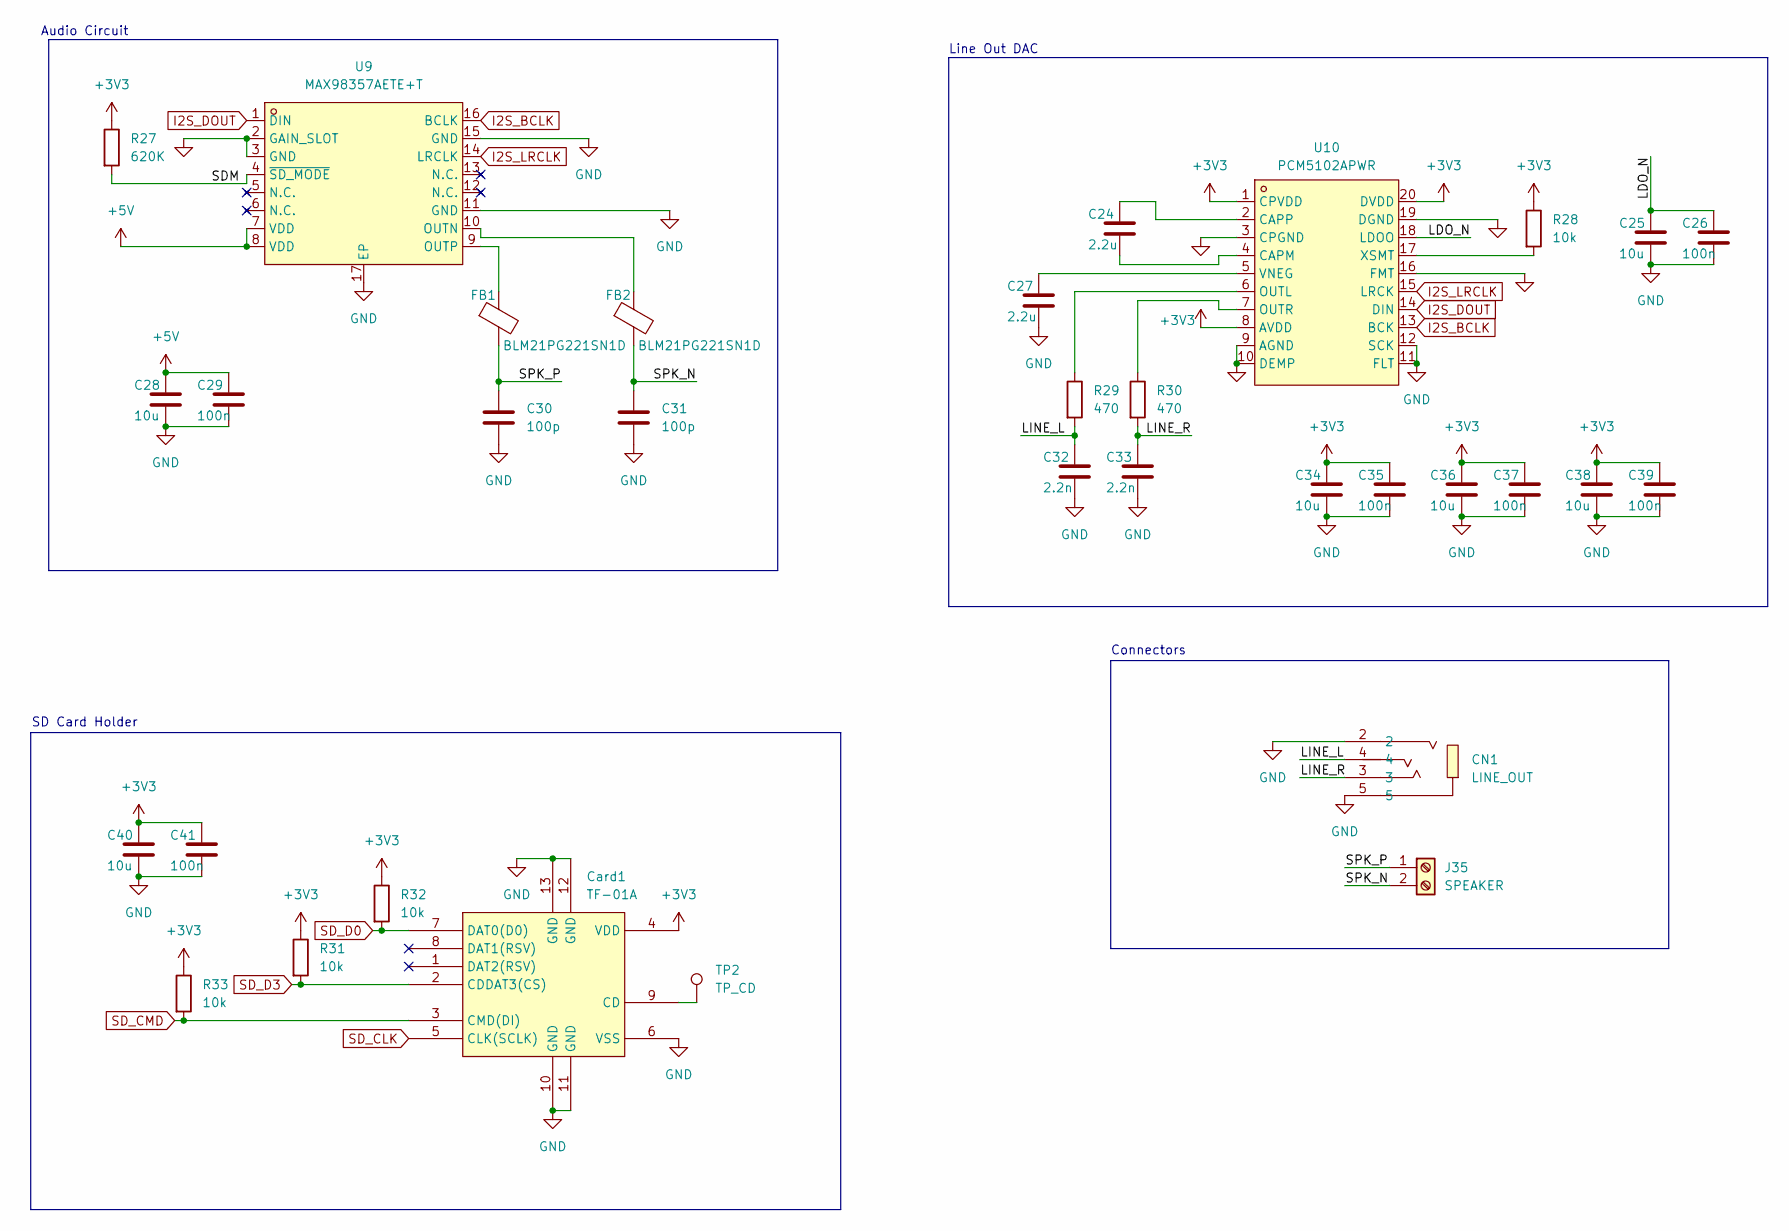
[picture p16: schematic audio.kicad_sch]

Parts:
C24, C27: 2.2u; C_0603_1608Metric
C25, C28, C34, C36, C38, C40: 10u; C_0805_2012Metric
C26, C29, C35, C37, C39, C41: 100n; C_0603_1608Metric
C30, C31: 100p; C_0603_1608Metric
C32, C33: 2.2n; C_0603_1608Metric
CN1: LINE_OUT; AUDIO-TH_XKB_PJ-320A; MPN PJ-320A; LCSC Part C2884926
Card1: TF-01A; TF-SMD_TF-01A; MPN TF-01A; LCSC Part C91145
FB1, FB2: BLM21PG221SN1D; L_0805_2012Metric
J35: SPEAKER; CONN-TH_DG381S-3.5-02P-14-00A-H
R27: 620K; R_0603_1608Metric
R28, R31, R32, R33: 10k; R_0603_1608Metric
R29, R30: 470; R_0603_1608Metric
TP2: TP_CD; TestPoint_Pad_1.5x1.5mm
U9: MAX98357AETE+T; TQFN-16_L3.0-W3.0-P0.50-BL-EP1.5; MPN MAX98357AETE+T; LCSC Part C910544
U10: PCM5102APWR; TSSOP-20_L6.5-W4.4-P0.65-LS6.4-BL; MPN PCM5102APWR; LCSC Part C107671

Connections:
+3V3: C34.1, C35.1, C36.1, C37.1, C38.1, C39.1, C40.1, C41.1, Card1.4 (VDD), R27.1, R28.1, R31.1, R32.1, R33.1, U10.1 (CPVDD), U10.8 (AVDD), U10.20 (DVDD); also elsewhere on the board
+5V: C28.1, C29.1, U9.7 (VDD), U9.8 (VDD); also elsewhere on the board
/Audio/LDO_N: C25.1, C26.1, U10.18 (LDOO)
/Audio/LINE_L: C32.1, CN1.4, R29.2
/Audio/LINE_R: C33.1, CN1.3, R30.2
/Audio/SDM: R27.2, U9.4 (~SD_MODE)
/Audio/SPK_N: C31.1, FB2.2, J35.2
/Audio/SPK_P: C30.1, FB1.2, J35.1
GND: C25.2, C26.2, C27.2, C28.2, C29.2, C30.2, C31.2, C32.2, C33.2, C34.2, C35.2, C36.2, C37.2, C38.2, C39.2, C40.2, C41.2, CN1.2, CN1.5, Card1.6 (VSS), Card1.10 (GND), Card1.11 (GND), Card1.12 (GND), Card1.13 (GND), U9.2 (GAIN_SLOT), U9.3 (GND), U9.11 (GND), U9.15 (GND), U9.17 (EP), U10.3 (CPGND), U10.9 (AGND), U10.10 (DEMP), U10.11 (FLT), U10.12 (SCK), U10.16 (FMT), U10.19 (DGND); also elsewhere on the board
I2S_BCLK: U9.16 (BCLK), U10.13 (BCK); also elsewhere on the board
I2S_DOUT: U9.1 (DIN), U10.14 (DIN); also elsewhere on the board
I2S_LRCLK: U9.14 (LRCLK), U10.15 (LRCK); also elsewhere on the board
unnamed: Card1.9 (CD), TP2.1 (1_1)
unnamed 114: Card1.8 (DAT1(RSV)); also elsewhere on the board
unnamed 115: Card1.1 (DAT2(RSV)); also elsewhere on the board
unnamed: FB2.1, U9.10 (OUTN)
unnamed: FB1.1, U9.9 (OUTP)
unnamed: C24.2, U10.4 (CAPM)
unnamed: C24.1, U10.2 (CAPP)
unnamed: R29.1, U10.6 (OUTL)
unnamed: R30.1, U10.7 (OUTR)
unnamed: C27.1, U10.5 (VNEG)
unnamed: R28.2, U10.17 (XSMT)
SD_CLK: Card1.5 (CLK(SCLK)); also elsewhere on the board
SD_CMD: Card1.3 (CMD(DI)), R33.2; also elsewhere on the board
SD_D0: Card1.7 (DAT0(D0)), R32.2; also elsewhere on the board
SD_D3: Card1.2 (CDDAT3(CS)), R31.2

Notes on the sheet:
Connectors
SD Card Holder
Line Out DAC
Audio Circuit
