mrwillson2u/propmesh/hardware/pro/propmesh/propmesh.kicad_pcb

## KiCad design hardware/pro/propmesh/propmesh.kicad_pcb (continued)

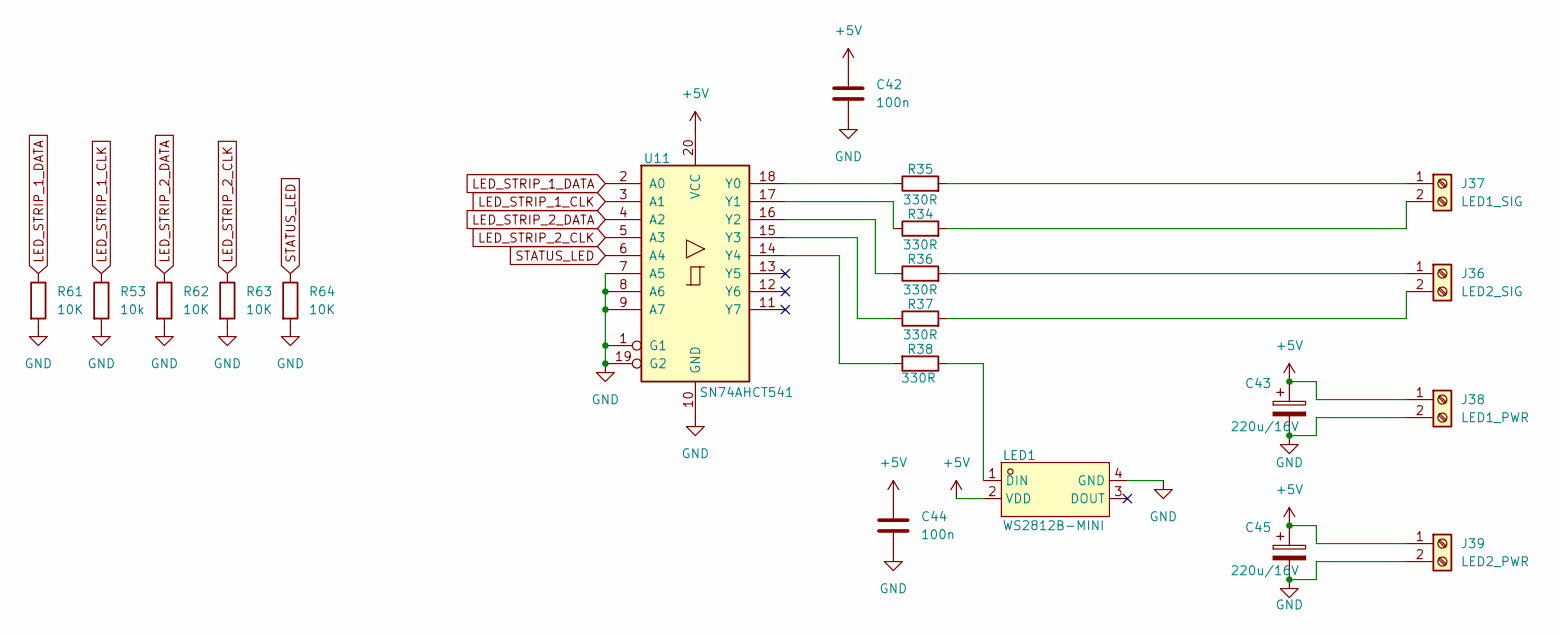
[picture p17: schematic leds.kicad_sch]

Parts:
C42, C44: 100n; C_0603_1608Metric
C43, C45: 220u/16V; CP_Radial_D6.3mm_P2.50mm
J36: LED2_SIG; CONN-TH_DG128-5.0-02P-14-00A-H
J37: LED1_SIG; CONN-TH_DG128-5.0-02P-14-00A-H
J38: LED1_PWR; CONN-TH_DG128-5.0-02P-14-00A-H
J39: LED2_PWR; CONN-TH_DG128-5.0-02P-14-00A-H
LED1: WS2812B-MINI; LED-SMD_4P-L3.5-W3.5-TL_WS2812B-1; MPN WS2812B-MINI-X2; LCSC Part C4154873
R34, R35, R36, R37, R38: 330R; R_0603_1608Metric
R53: 10k; R_0603_1608Metric
R61, R62, R63, R64: 10K; R_0603_1608Metric
U11: SN74AHCT541; SOIC-20W_7.5x12.8mm_P1.27mm

Connections:
+5V: C42.1, C43.1, C44.1, C45.1, J38.1, J39.1, LED1.2 (VDD), U11.20 (VCC); also elsewhere on the board
GND: C42.2, C43.2, C44.2, C45.2, J38.2, J39.2, LED1.4 (GND), R53.2, R61.2, R62.2, R63.2, R64.2, U11.1 (G1), U11.7 (A5), U11.8 (A6), U11.9 (A7), U11.10 (GND), U11.19 (G2); also elsewhere on the board
LED_STRIP_1_CLK: R53.1, U11.3 (A1); also elsewhere on the board
LED_STRIP_1_DATA: R61.1, U11.2 (A0); also elsewhere on the board
LED_STRIP_2_CLK: R63.1, U11.5 (A3); also elsewhere on the board
LED_STRIP_2_DATA: R62.1, U11.4 (A2); also elsewhere on the board
unnamed: J36.1, R36.2
unnamed: J36.2, R37.2
unnamed: J37.1, R35.2
unnamed: J37.2, R34.2
unnamed: LED1.1 (DIN), R38.1
unnamed: R35.1, U11.18 (Y0)
unnamed: R34.1, U11.17 (Y1)
unnamed: R36.1, U11.16 (Y2)
unnamed: R37.1, U11.15 (Y3)
unnamed: R38.2, U11.14 (Y4)
STATUS_LED: R64.1, U11.6 (A4); also elsewhere on the board

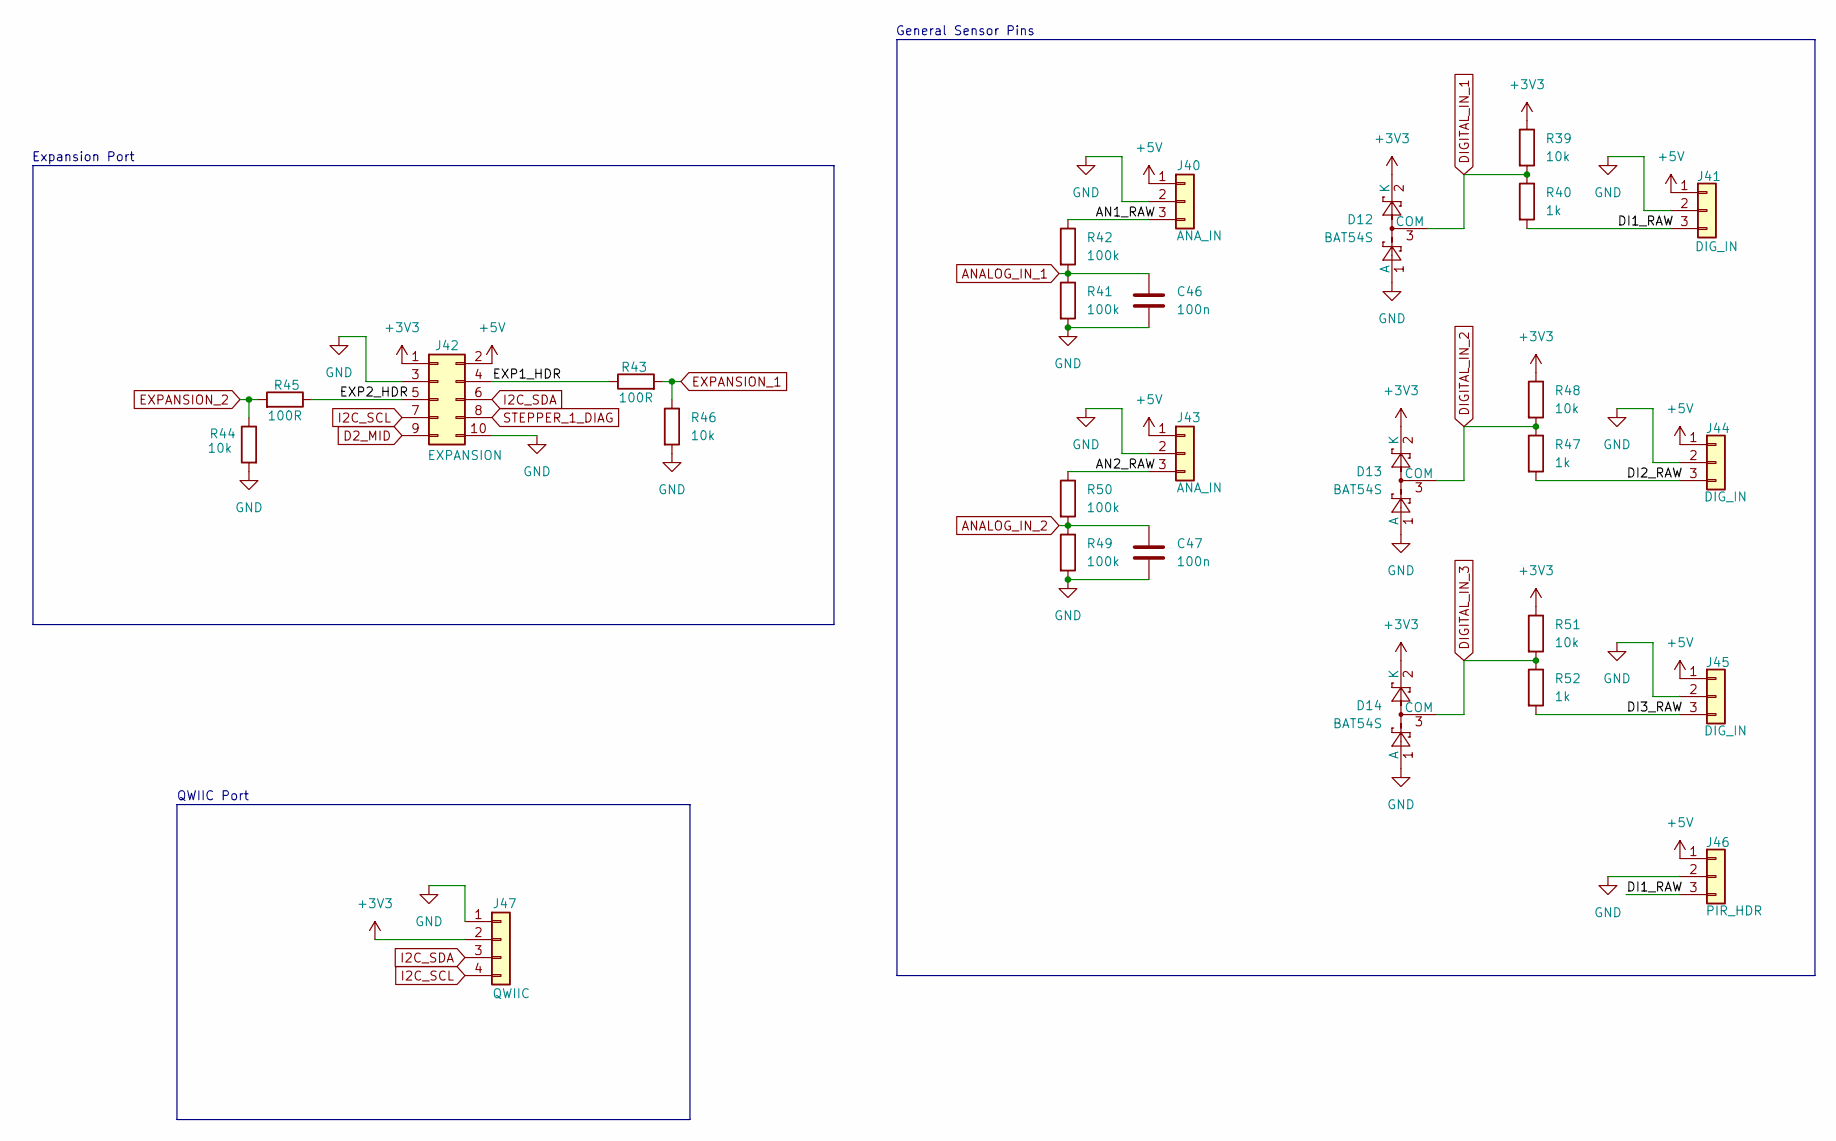
[picture p18: schematic sensor_expansion.kicad_sch]

Parts:
C46, C47: 100n; C_0603_1608Metric
D12, D13, D14: BAT54S; SOT-23
J40, J43: ANA_IN; JST_XH_B3B-XH-A_1x03_P2.50mm_Vertical
J41, J44, J45: DIG_IN; JST_XH_B3B-XH-A_1x03_P2.50mm_Vertical
J42: EXPANSION; PinHeader_2x05_P2.54mm_Vertical
J46: PIR_HDR; PinHeader_1x03_P2.54mm_Vertical
J47: QWIIC; JST_SH_SM04B-SRSS-TB_1x04-1MP_P1.00mm_Horizontal
R39, R44, R46, R48, R51: 10k; R_0603_1608Metric
R40, R47, R52: 1k; R_0603_1608Metric
R41, R42, R49, R50: 100k; R_0603_1608Metric
R43, R45: 100R; R_0603_1608Metric

Connections:
+3V3: D12.2 (K), D13.2 (K), D14.2 (K), J42.1, J47.2, R39.1, R48.1, R51.1; also elsewhere on the board
+5V: J40.1, J41.1, J42.2, J43.1, J44.1, J45.1, J46.1; also elsewhere on the board
/Sensor Expansion/AN1_RAW: J40.3, R42.1
/Sensor Expansion/AN2_RAW: J43.3, R50.1
/Sensor Expansion/DI1_RAW: J41.3, J46.3, R40.2
/Sensor Expansion/DI2_RAW: J44.3, R47.2
/Sensor Expansion/DI3_RAW: J45.3, R52.2
/Sensor Expansion/EXP1_HDR: J42.4, R43.1
/Sensor Expansion/EXP2_HDR: J42.5, R45.1
ANALOG_IN_1: C46.1, R41.1, R42.2; also elsewhere on the board
ANALOG_IN_2: C47.1, R49.1, R50.2; also elsewhere on the board
D2_MID: J42.9; also elsewhere on the board
DIGITAL_IN_1: D12.3 (COM), R39.2, R40.1; also elsewhere on the board
DIGITAL_IN_2: D13.3 (COM), R47.1, R48.2; also elsewhere on the board
DIGITAL_IN_3: D14.3 (COM), R51.2, R52.1; also elsewhere on the board
EXPANSION_1: R43.2, R46.1; also elsewhere on the board
EXPANSION_2: R44.1, R45.2; also elsewhere on the board
GND: C46.2, C47.2, D12.1 (A), D13.1 (A), D14.1 (A), J40.2, J41.2, J42.3, J42.10, J43.2, J44.2, J45.2, J46.2, J47.1, R41.2, R44.2, R46.2, R49.2; also elsewhere on the board
I2C_SCL: J42.7, J47.4; also elsewhere on the board
I2C_SDA: J42.6, J47.3; also elsewhere on the board
STEPPER_1_DIAG: J42.8; also elsewhere on the board

Notes on the sheet:
General Sensor Pins
QWIIC Port
Expansion Port

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
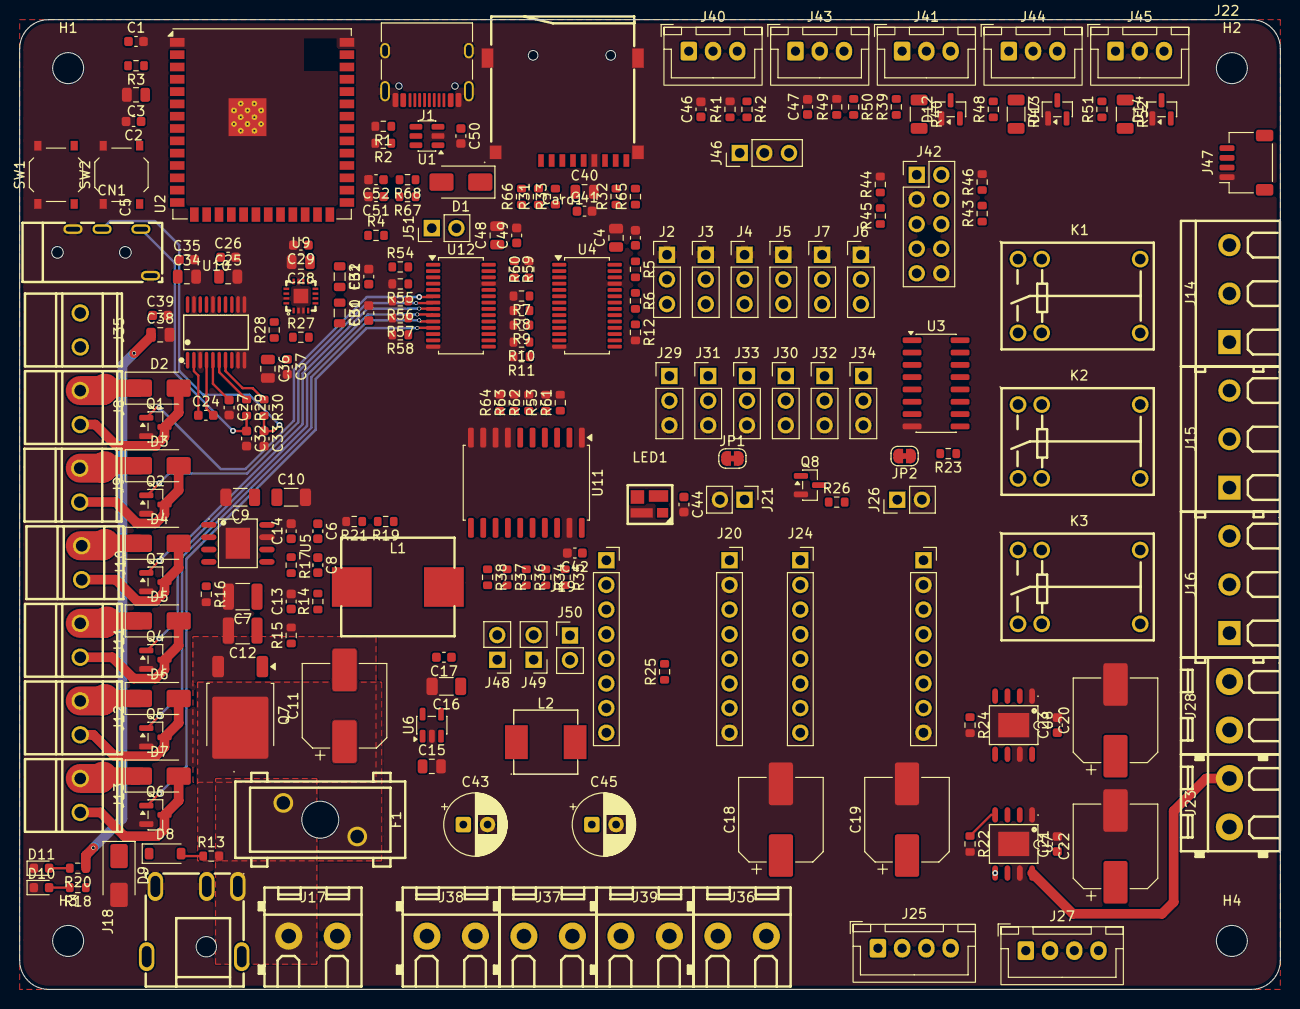
[picture p19: board propmesh.kicad_pcb from above]

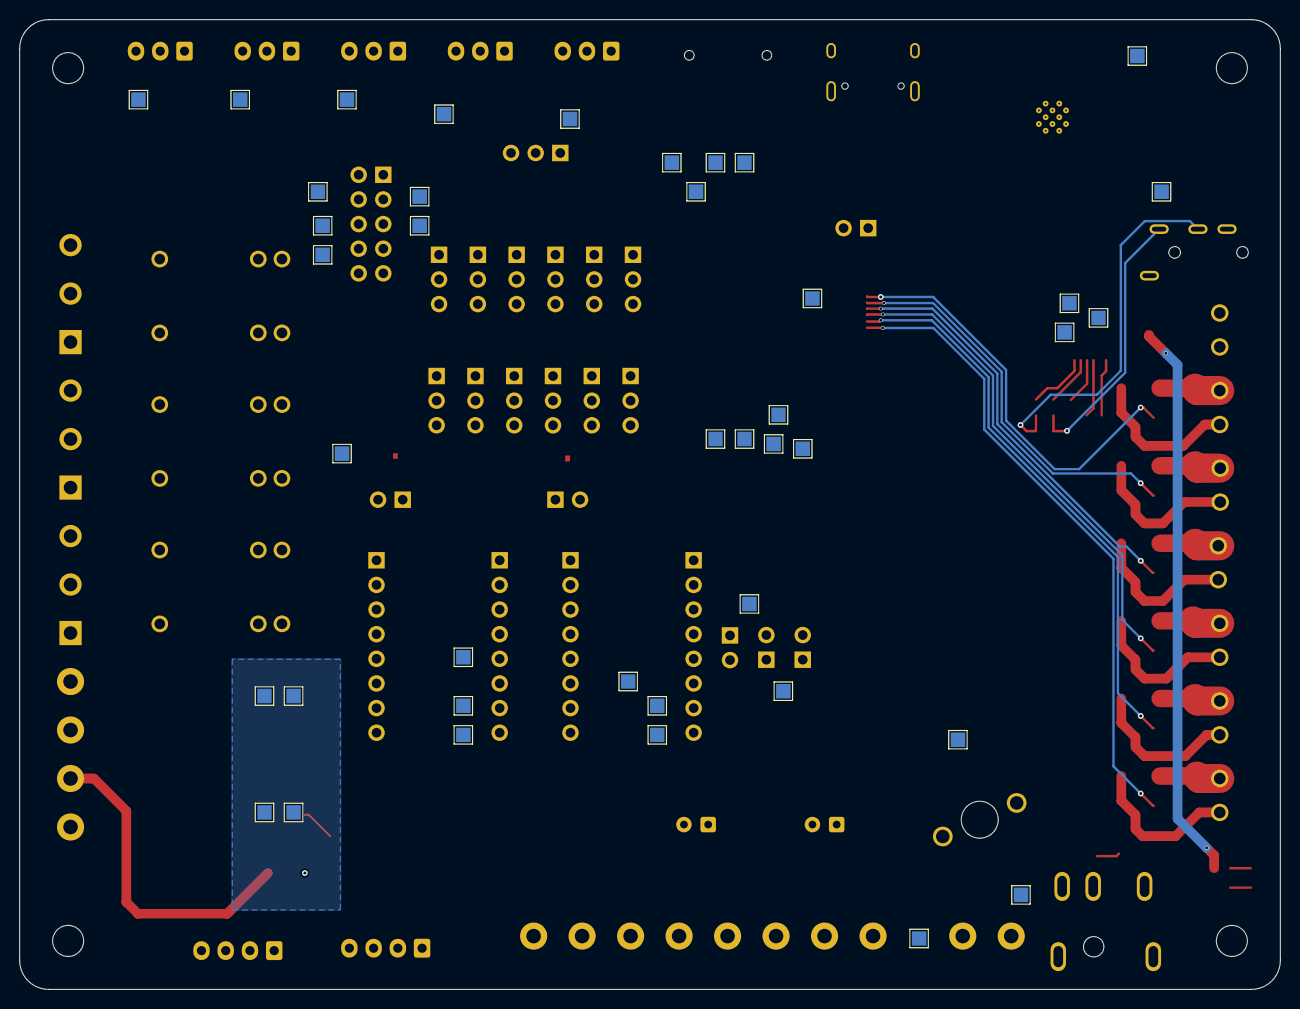
[picture p20: board propmesh.kicad_pcb from below]

Board: 4 copper layers, 130.0 x 100.0 mm, 265 parts (41 on the bottom side), 168 nets.

Other parts of the board:
C50: 100n; C_0603_1608Metric
C51, C52: DNP; C_0603_1608Metric
H1, H2, H3, H4: MountingHole_3.2mm_M3
J51: JP_USB; PinHeader_1x02_P2.54mm_Vertical
R65, R66: 10K; R_0603_1608Metric
R67, R68: 22R; R_0603_1608Metric

Their connections:
+3V3: R65.1, R66.1; also elsewhere on the board
+5V: J51.1; also elsewhere on the board
GND: C50.2, C51.2, C52.2; also elsewhere on the board
unnamed 114: R65.2; also elsewhere on the board
unnamed 115: R66.2; also elsewhere on the board
unnamed 116: J51.2; also elsewhere on the board
VBUS: C50.1; also elsewhere on the board
