mrwillson2u/propmesh/hardware/mini/propmesh-mini/01-mcu.kicad_sch

## KiCad design hardware/mini/propmesh-mini/01-mcu.kicad_sch (2026-10-03)

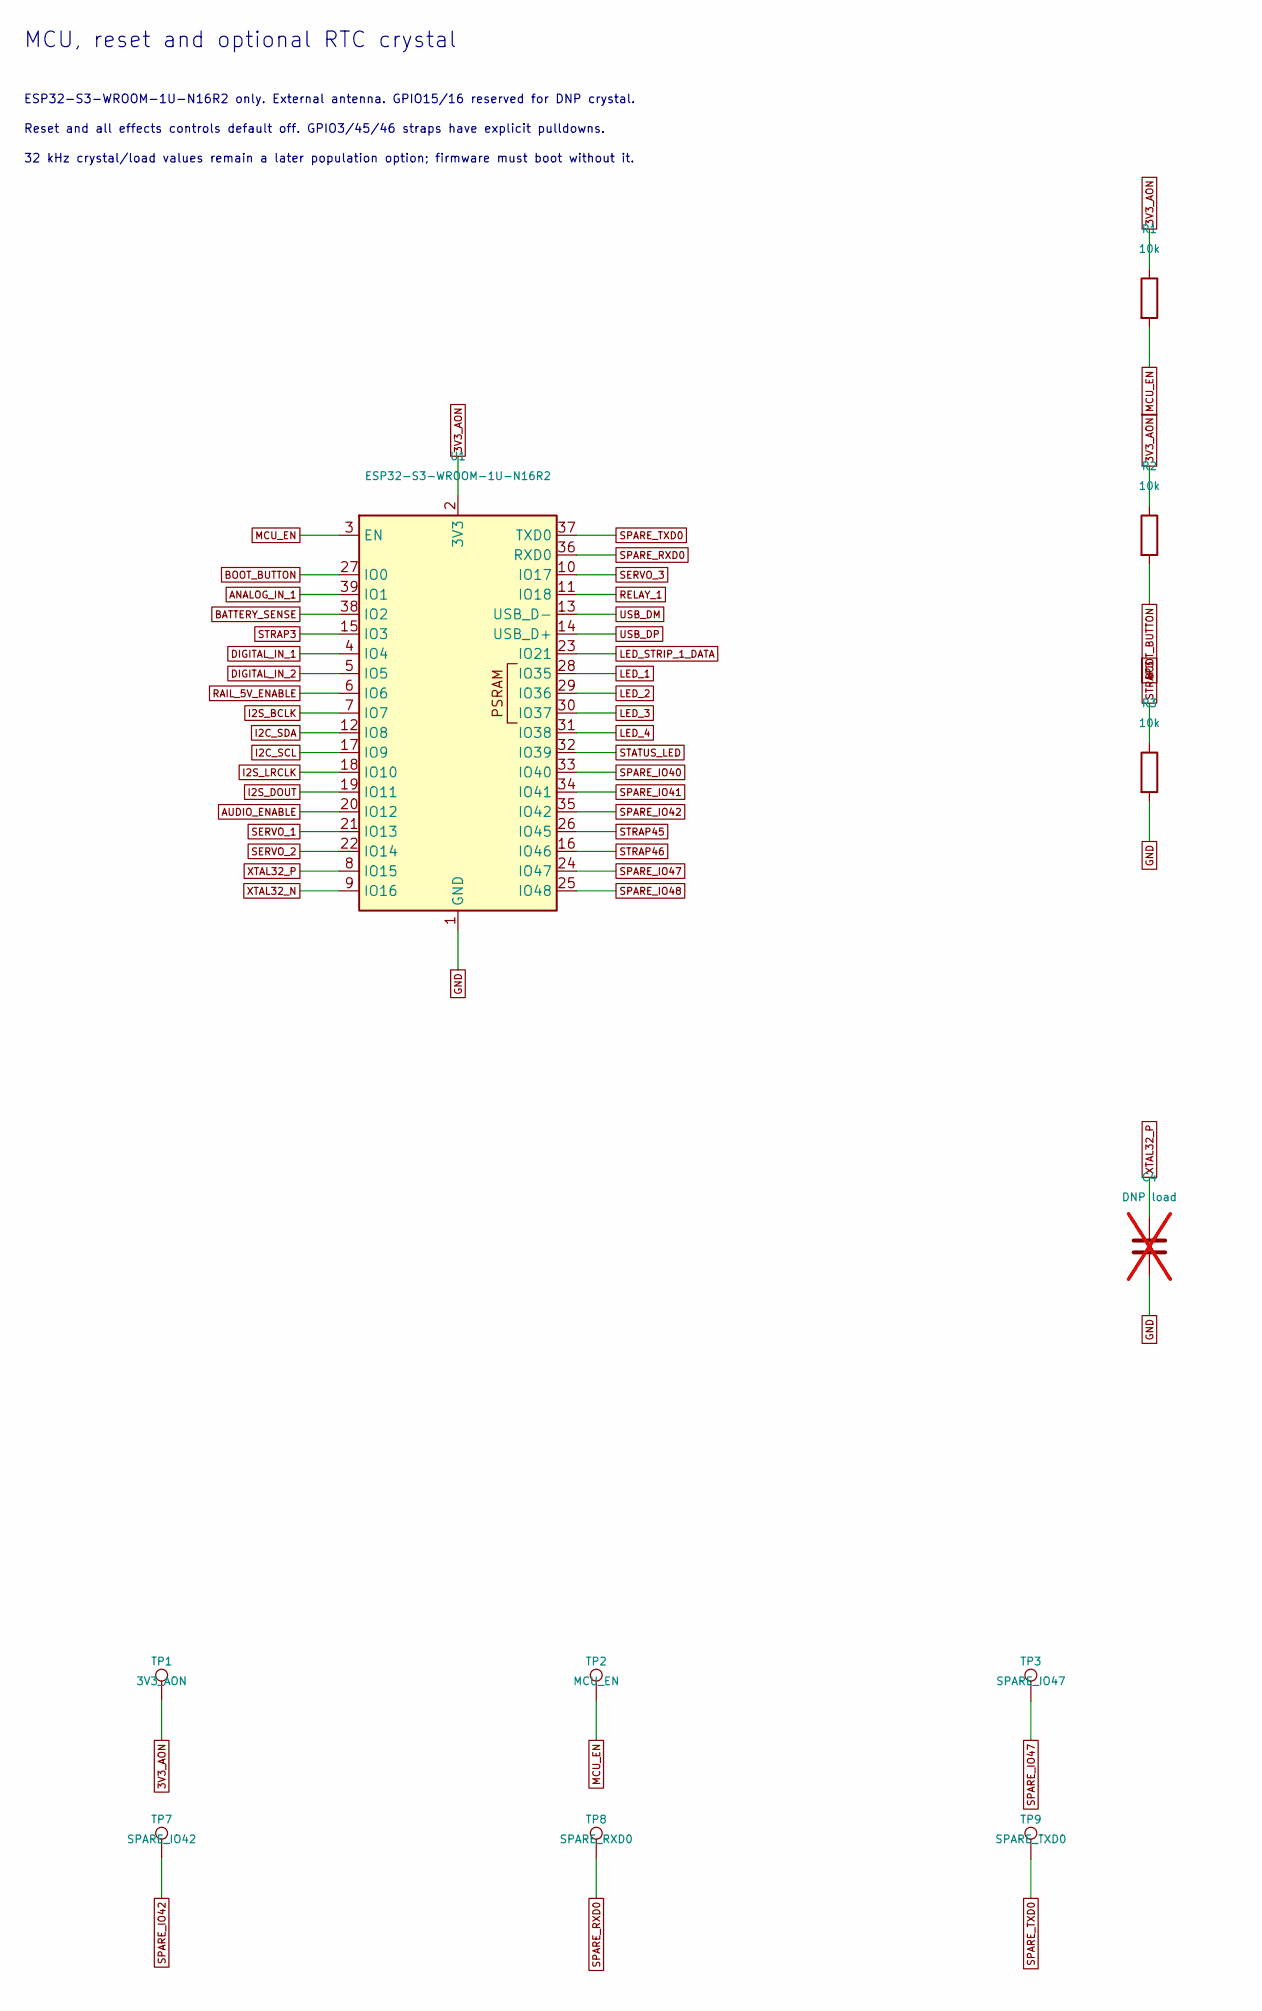
[picture p21: schematic 01-mcu.kicad_sch, part in row 1, column 1]

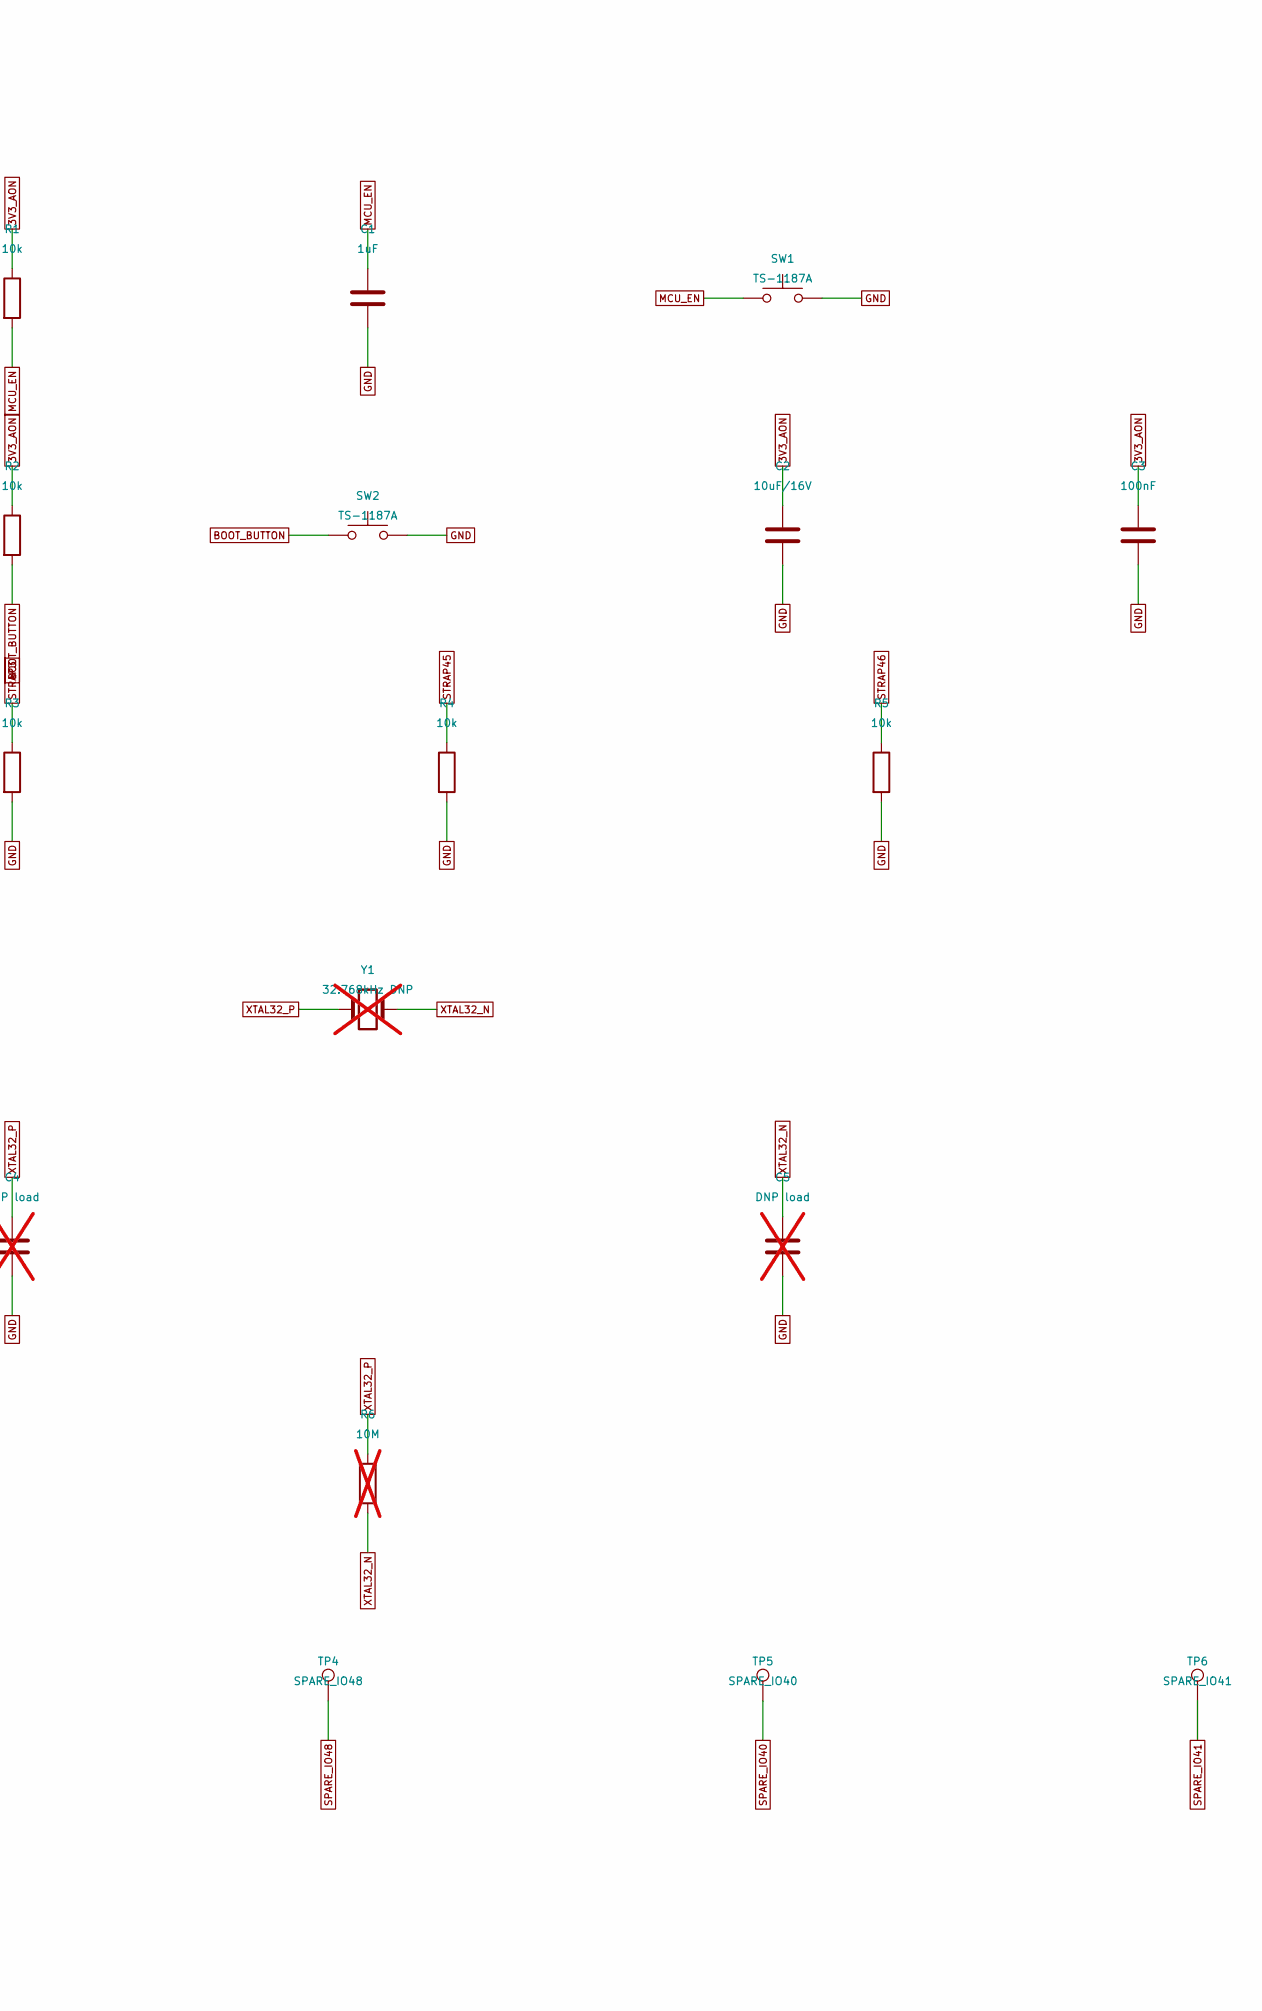
[picture p22: schematic 01-mcu.kicad_sch, part in row 1, column 2]

Parts:
C1: 1uF; C_0603_1608Metric; LCSC C15849
C2: 10uF/16V; C_0805_2012Metric; LCSC C95841
C3: 100nF; C_0603_1608Metric; LCSC C14663
C4, C5: DNP load; C_0603_1608Metric; not fitted
R1, R2, R3, R4, R5: 10k; R_0603_1608Metric; LCSC C25804
R6: 10M; R_0603_1608Metric; not fitted
SW1, SW2: TS-1187A; SW_Push_1P1T_XKB_TS-1187A; LCSC C318884
TP1: 3V3_AON; TestPoint_Pad_1.5x1.5mm
TP2: MCU_EN; TestPoint_Pad_1.5x1.5mm
TP3: SPARE_IO47; TestPoint_Pad_1.5x1.5mm
TP4: SPARE_IO48; TestPoint_Pad_1.5x1.5mm
TP5: SPARE_IO40; TestPoint_Pad_1.5x1.5mm
TP6: SPARE_IO41; TestPoint_Pad_1.5x1.5mm
TP7: SPARE_IO42; TestPoint_Pad_1.5x1.5mm
TP8: SPARE_RXD0; TestPoint_Pad_1.5x1.5mm
TP9: SPARE_TXD0; TestPoint_Pad_1.5x1.5mm
U1: ESP32-S3-WROOM-1U-N16R2; ESP32-S3-WROOM-1U
Y1: 32.768kHz DNP; Crystal_SMD_3215-2Pin_3.2x1.5mm; not fitted

Connections:
3V3_AON: C2.1, C3.1, R1.1, R2.1, TP1.1, U1.2 (3V3)
ANALOG_IN_1: U1.39 (IO1)
AUDIO_ENABLE: U1.20 (IO12)
BATTERY_SENSE: U1.38 (IO2)
BOOT_BUTTON: R2.2, SW2.1, U1.27 (IO0)
DIGITAL_IN_1: U1.4 (IO4)
DIGITAL_IN_2: U1.5 (IO5)
GND: C1.2, C2.2, C3.2, C4.2, C5.2, R3.2, R4.2, R5.2, SW1.2, SW2.2, U1.1 (GND), U1.40 (GND), U1.41 (GND)
I2C_SCL: U1.17 (IO9)
I2C_SDA: U1.12 (IO8)
I2S_BCLK: U1.7 (IO7)
I2S_DOUT: U1.19 (IO11)
I2S_LRCLK: U1.18 (IO10)
LED_1: U1.28 (IO35)
LED_2: U1.29 (IO36)
LED_3: U1.30 (IO37)
LED_4: U1.31 (IO38)
LED_STRIP_1_DATA: U1.23 (IO21)
MCU_EN: C1.1, R1.2, SW1.1, TP2.1, U1.3 (EN)
RAIL_5V_ENABLE: U1.6 (IO6)
RELAY_1: U1.11 (IO18)
SERVO_1: U1.21 (IO13)
SERVO_2: U1.22 (IO14)
SERVO_3: U1.10 (IO17)
SPARE_IO40: TP5.1, U1.33 (IO40)
SPARE_IO41: TP6.1, U1.34 (IO41)
SPARE_IO42: TP7.1, U1.35 (IO42)
SPARE_IO47: TP3.1, U1.24 (IO47)
SPARE_IO48: TP4.1, U1.25 (IO48)
SPARE_RXD0: TP8.1, U1.36 (RXD0)
SPARE_TXD0: TP9.1, U1.37 (TXD0)
STATUS_LED: U1.32 (IO39)
STRAP3: R3.1, U1.15 (IO3)
STRAP45: R4.1, U1.26 (IO45)
STRAP46: R5.1, U1.16 (IO46)
USB_DM: U1.13 (USB_D-)
USB_DP: U1.14 (USB_D+)
XTAL32_N: C5.1, R6.2, U1.9 (IO16), Y1.2
XTAL32_P: C4.1, R6.1, U1.8 (IO15), Y1.1

Notes on the sheet:
MCU, reset and optional RTC crystal
ESP32-S3-WROOM-1U-N16R2 only. External antenna. GPIO15/16 reserved for DNP crystal.
Reset and all effects controls default off. GPIO3/45/46 straps have explicit pulldowns.
32 kHz crystal/load values remain a later population option; firmware must boot without it.
