mrwillson2u/propmesh/hardware/mini/propmesh-mini/05-audio.kicad_sch

## KiCad design hardware/mini/propmesh-mini/05-audio.kicad_sch (2026-10-03)

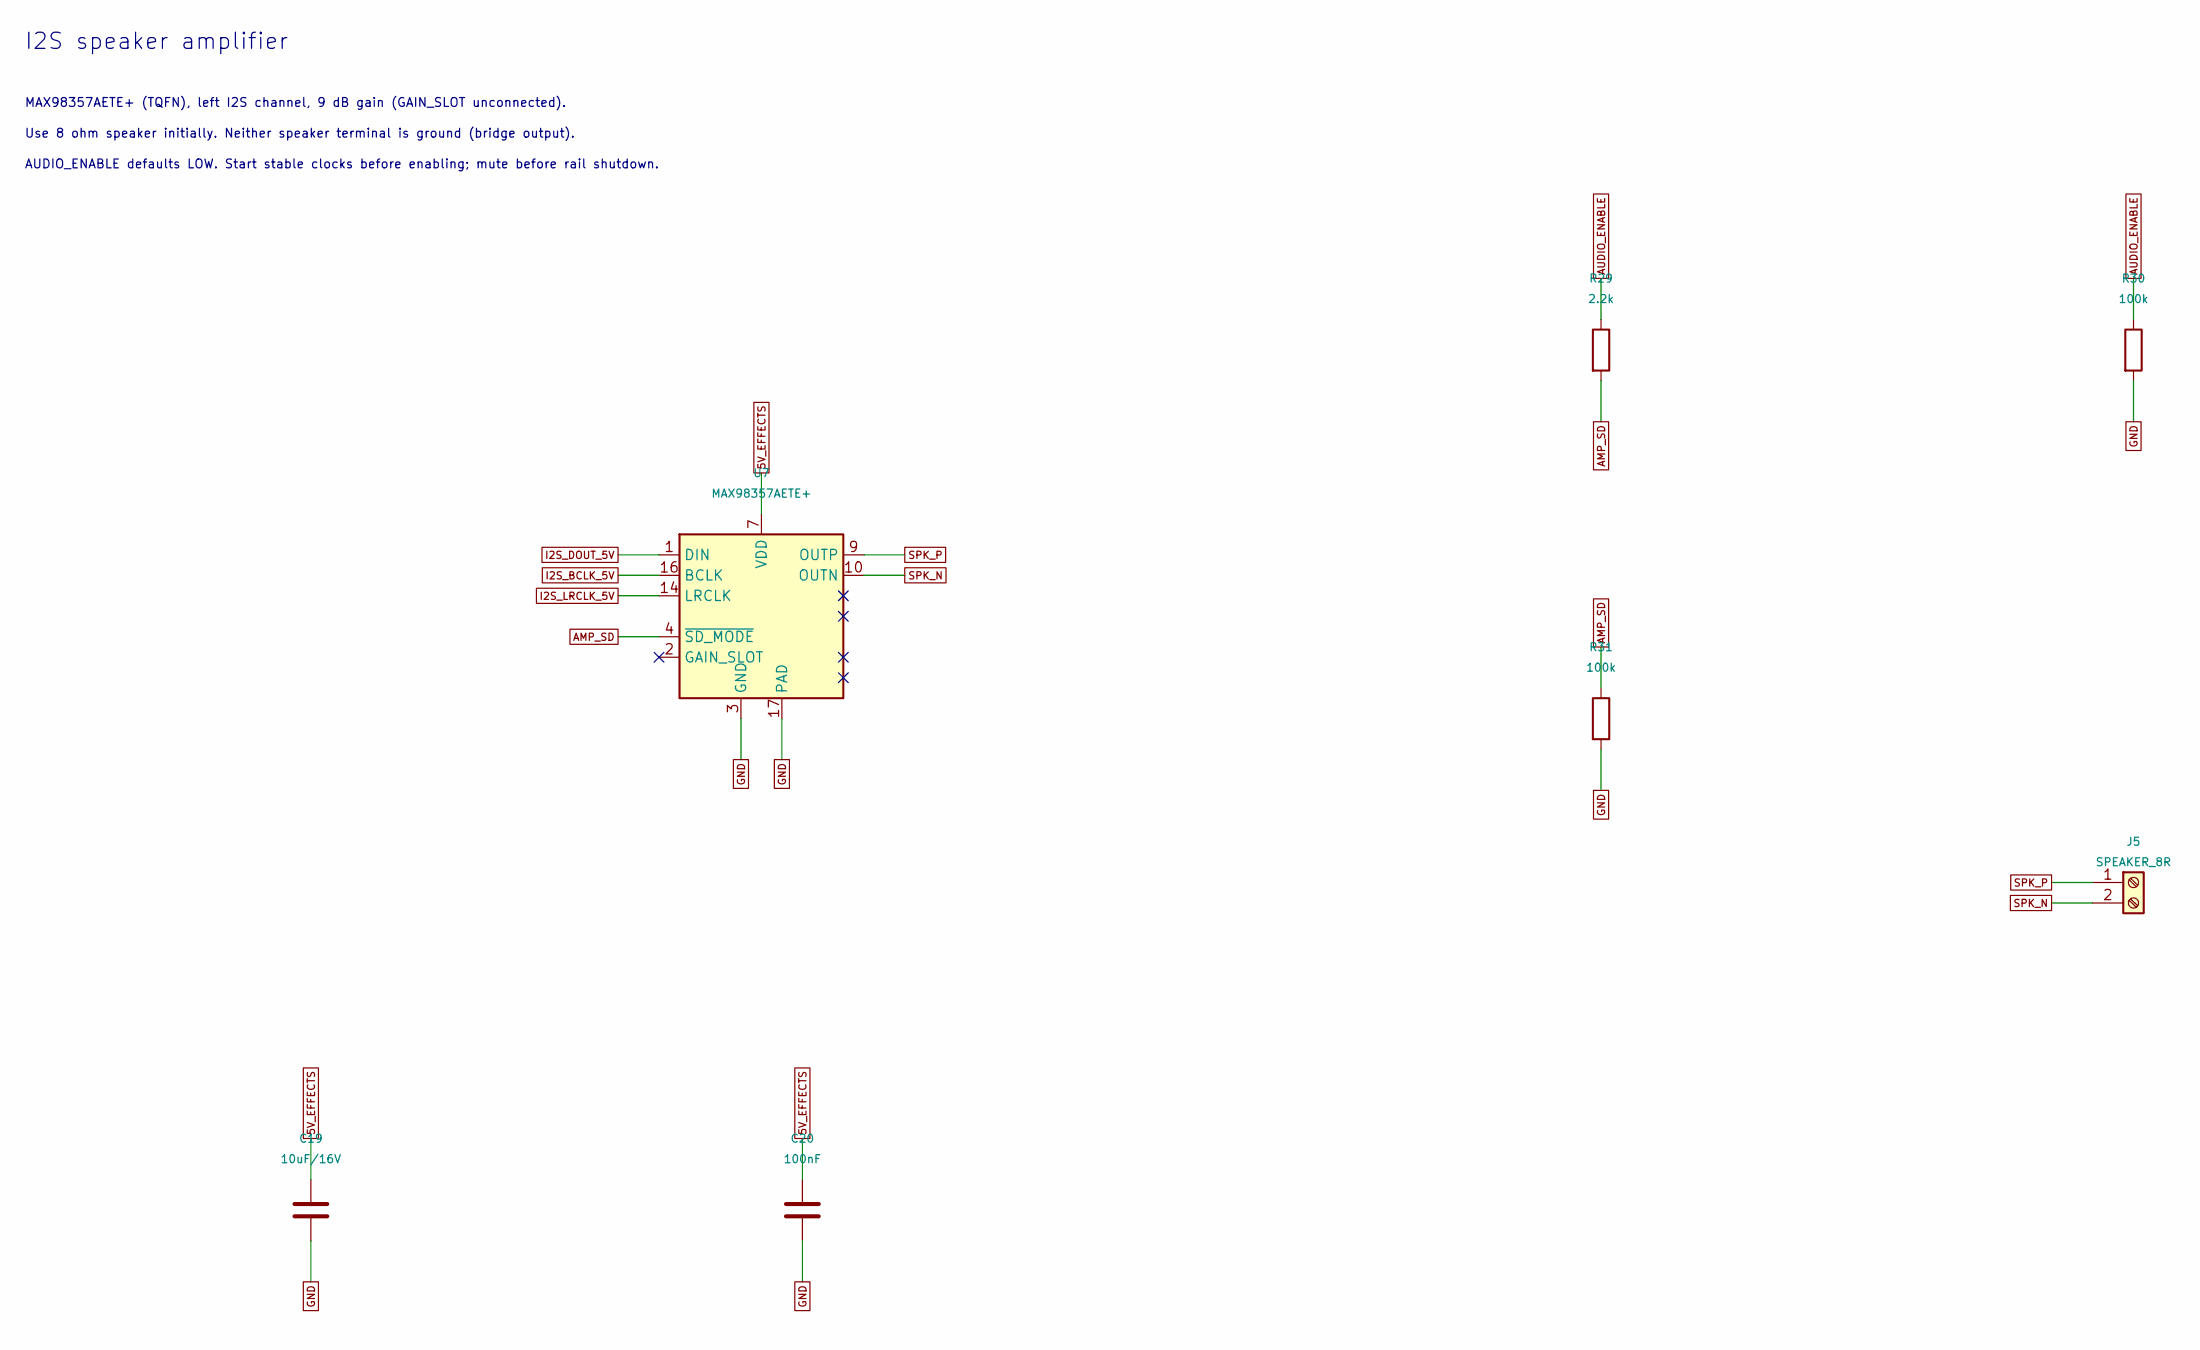
[picture p23: schematic 05-audio.kicad_sch]

Parts:
C19: 10uF/16V; C_0805_2012Metric; LCSC C95841
C20: 100nF; C_0603_1608Metric; LCSC C14663
J5: SPEAKER_8R; CONN-TH_DG381S-3.5-02P-14-00A-H; LCSC C723982
R29: 2.2k; R_0603_1608Metric; LCSC C4190
R30, R31: 100k; R_0603_1608Metric; LCSC C25803
U7: MAX98357AETE+; TQFN-16-1EP_3x3mm_P0.5mm_EP1.23x1.23mm

Connections:
5V_EFFECTS: C19.1, C20.1, U7.7 (VDD), U7.8 (VDD)
AMP_SD: R29.2, R31.1, U7.4 (~SD_MODE)
AUDIO_ENABLE: R29.1, R30.1
GND: C19.2, C20.2, R30.2, R31.2, U7.3 (GND), U7.11 (GND), U7.15 (GND), U7.17 (PAD)
I2S_BCLK_5V: U7.16 (BCLK)
I2S_DOUT_5V: U7.1 (DIN)
I2S_LRCLK_5V: U7.14 (LRCLK)
SPK_N: J5.2, U7.10 (OUTN)
SPK_P: J5.1, U7.9 (OUTP)

Notes on the sheet:
I2S speaker amplifier
MAX98357AETE+ (TQFN), left I2S channel, 9 dB gain (GAIN_SLOT unconnected).
Use 8 ohm speaker initially. Neither speaker terminal is ground (bridge output).
AUDIO_ENABLE defaults LOW. Start stable clocks before enabling; mute before rail shutdown.
