mrwillson2u/propmesh/hardware/mini/propmesh-mini/08-sensors.kicad_sch

## KiCad design hardware/mini/propmesh-mini/08-sensors.kicad_sch (2026-10-03)

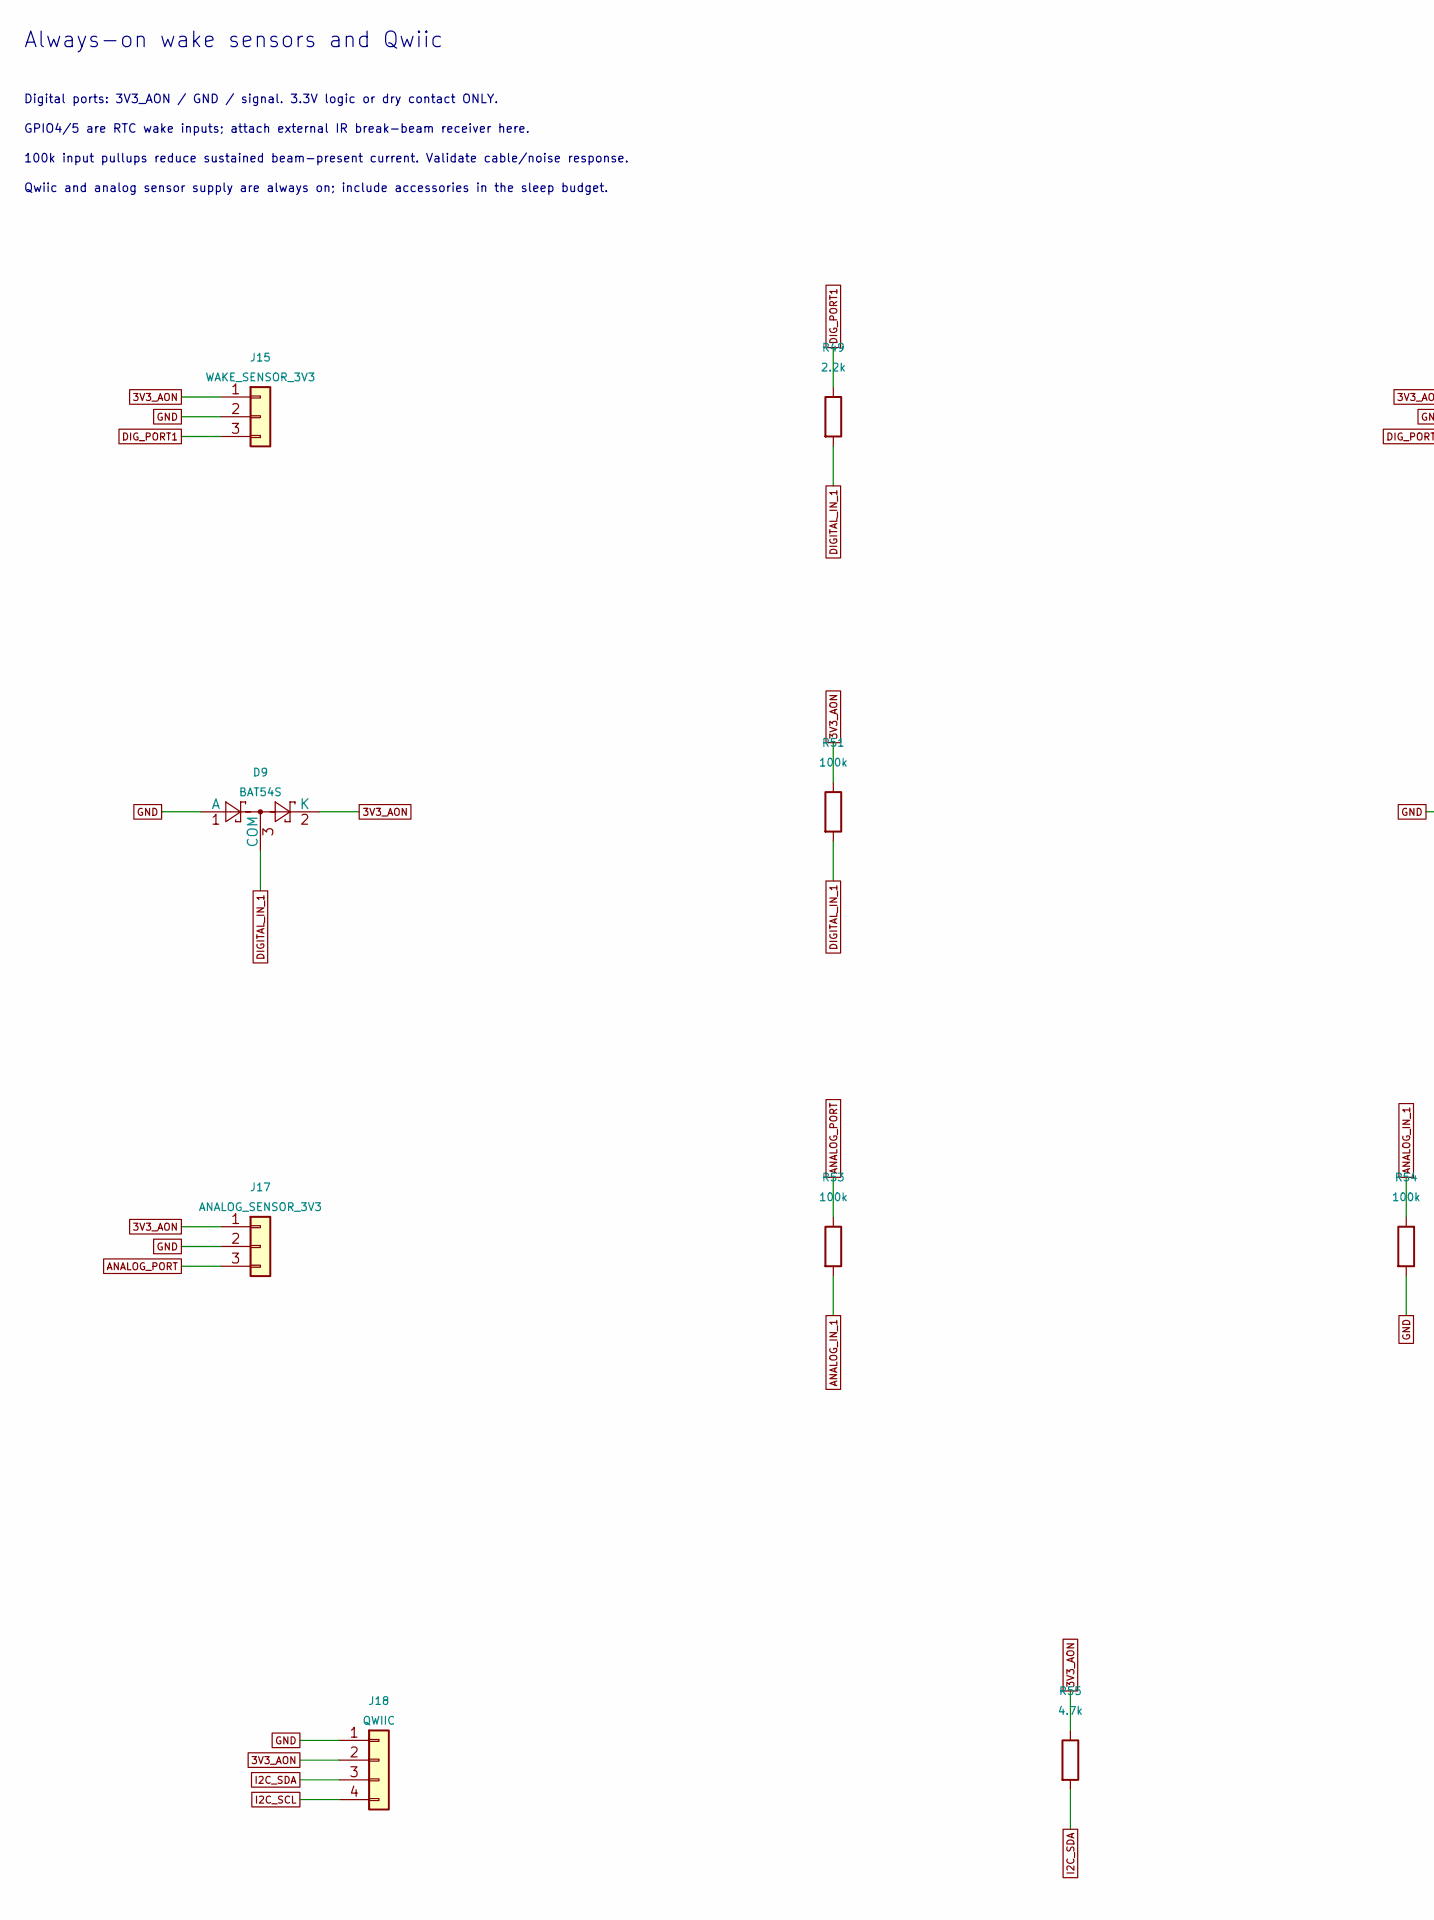
[picture p24: schematic 08-sensors.kicad_sch, part in row 1, column 1]

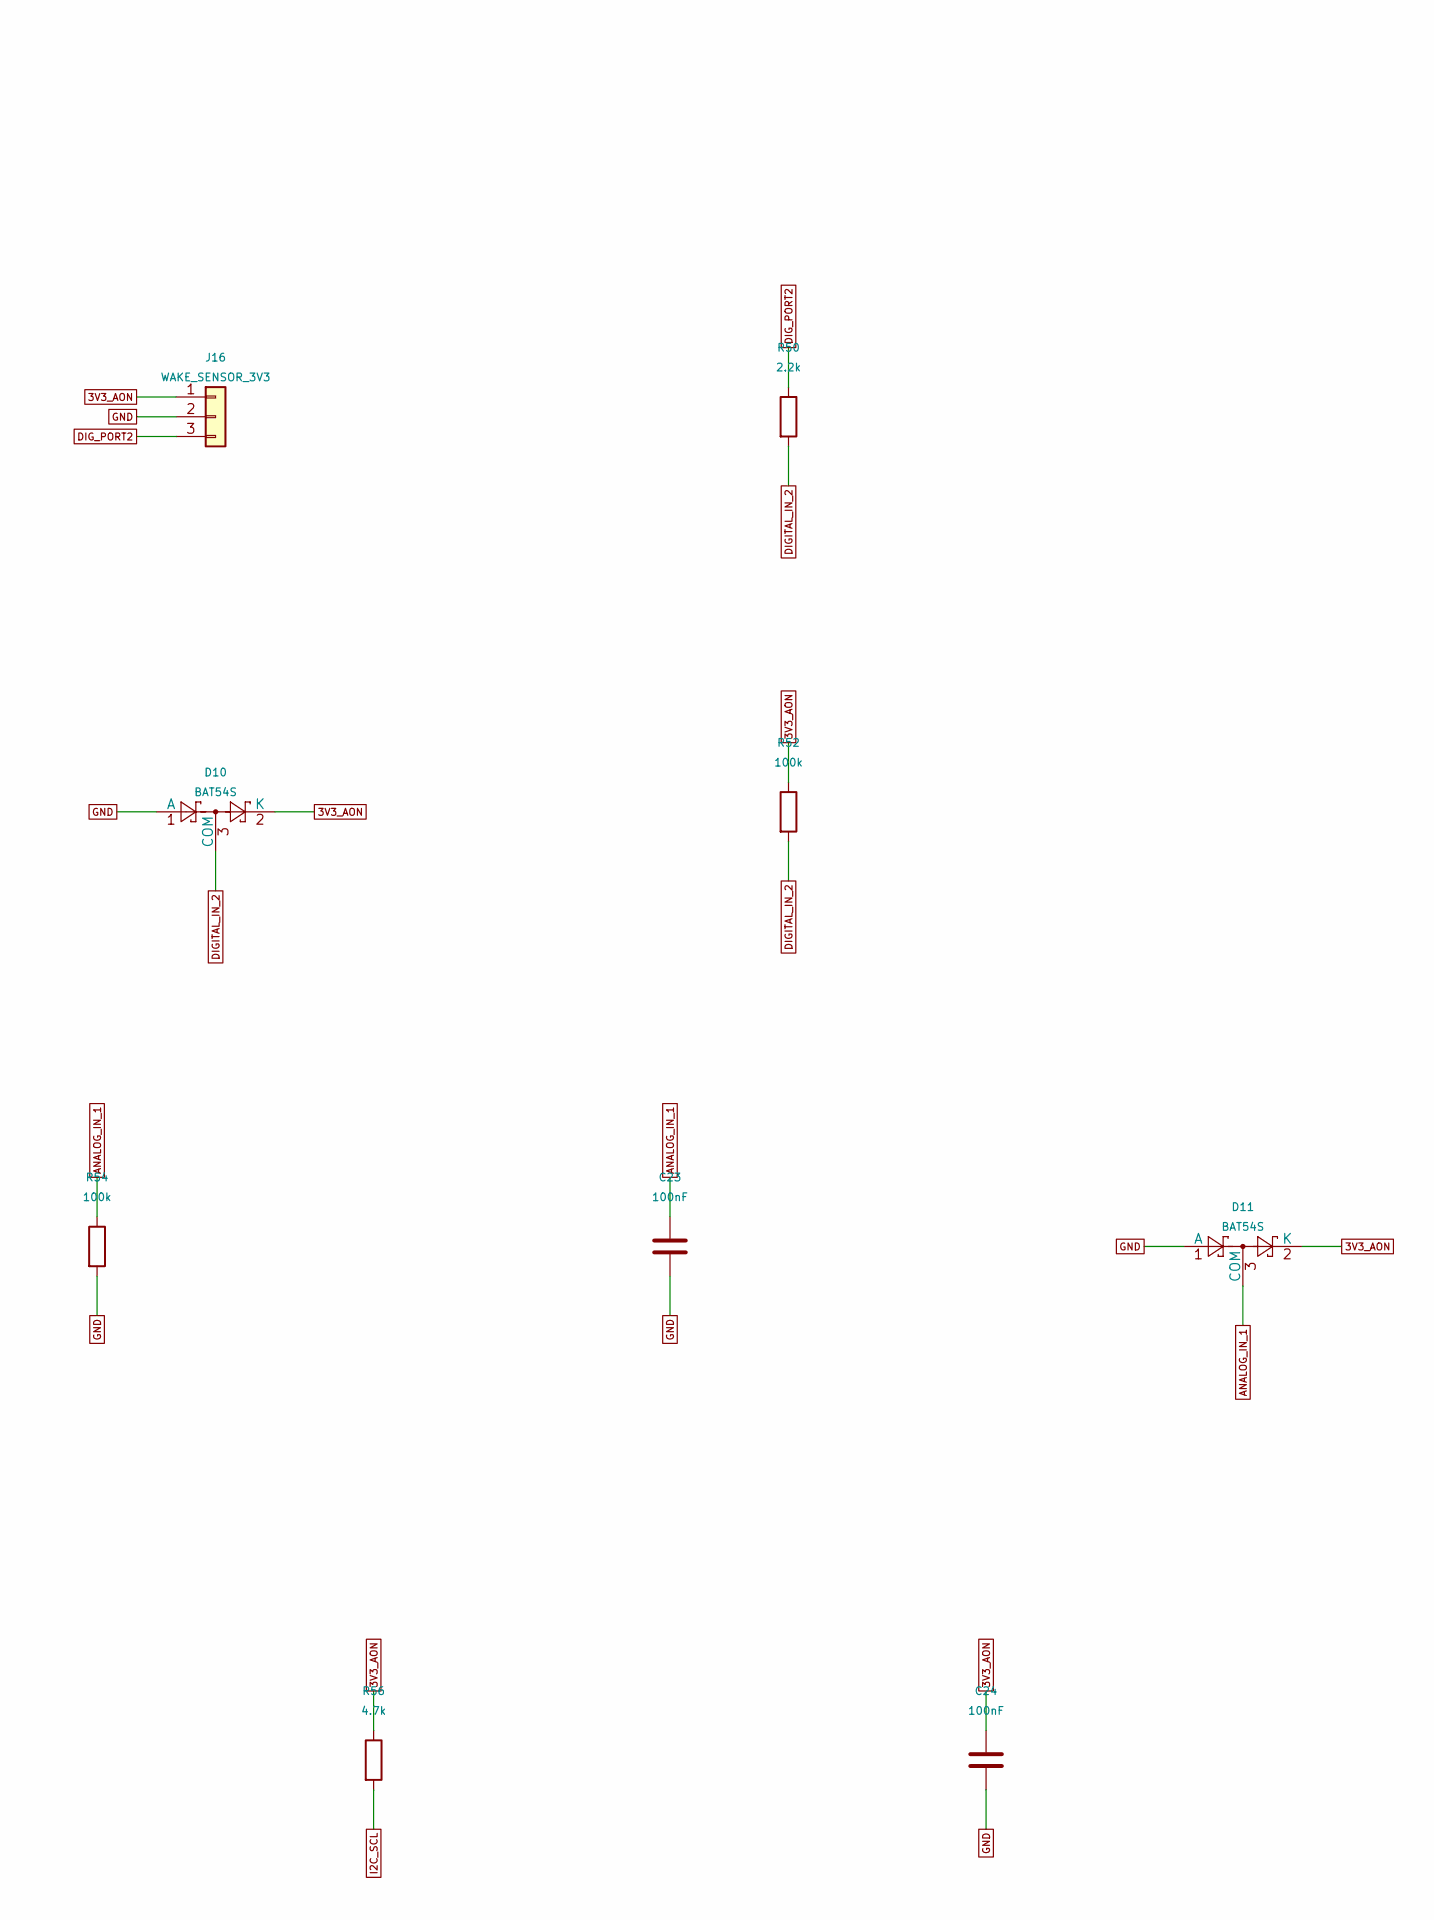
[picture p25: schematic 08-sensors.kicad_sch, part in row 1, column 2]

Parts:
C23, C24: 100nF; C_0603_1608Metric; LCSC C14663
D9, D10, D11: BAT54S; SOT-23; LCSC C8592
J15, J16: WAKE_SENSOR_3V3; JST_XH_B3B-XH-A_1x03_P2.50mm_Vertical; LCSC C2316
J17: ANALOG_SENSOR_3V3; JST_XH_B3B-XH-A_1x03_P2.50mm_Vertical; LCSC C2316
J18: QWIIC; JST_SH_SM04B-SRSS-TB_1x04-1MP_P1.00mm_Horizontal; LCSC C7430446
R49, R50: 2.2k; R_1206_3216Metric; LCSC C17948
R51, R52, R53, R54: 100k; R_0603_1608Metric; LCSC C25803
R55, R56: 4.7k; R_0603_1608Metric; LCSC C23162

Connections:
3V3_AON: C24.1, D9.2 (K), D10.2 (K), D11.2 (K), J15.1, J16.1, J17.1, J18.2, R51.1, R52.1, R55.1, R56.1
ANALOG_IN_1: C23.1, D11.3 (COM), R53.2, R54.1
ANALOG_PORT: J17.3, R53.1
DIGITAL_IN_1: D9.3 (COM), R49.2, R51.2
DIGITAL_IN_2: D10.3 (COM), R50.2, R52.2
DIG_PORT1: J15.3, R49.1
DIG_PORT2: J16.3, R50.1
GND: C23.2, C24.2, D9.1 (A), D10.1 (A), D11.1 (A), J15.2, J16.2, J17.2, J18.1, R54.2
I2C_SCL: J18.4, R56.2
I2C_SDA: J18.3, R55.2

Notes on the sheet:
Always-on wake sensors and Qwiic
Digital ports: 3V3_AON / GND / signal. 3.3V logic or dry contact ONLY.
GPIO4/5 are RTC wake inputs; attach external IR break-beam receiver here.
100k input pullups reduce sustained beam-present current. Validate cable/noise response.
Qwiic and analog sensor supply are always on; include accessories in the sleep budget.
