mrwillson2u/propmesh/pinmap.yaml

# PropMesh pin assignments — SINGLE SOURCE OF TRUTH
#
# Edit this file, then run:  python3 tools/genpins.py
# Never hand-edit firmware/common/pins_*.h
#
# Keep in sync with docs/hardware-spec.md in the same commit.

boards:

  pro:
    mcu: ESP32-S3-WROOM-1U-N8R2
    notes: >
      36 of 36 module GPIO allocated — no spare. GPIO 37 (the last
      spare, a test point until 2026-09-16) is now PCA_OE, gating both
      PCA9685s. GPIO 45/46 broken out on the expansion header.
      GPIO 33/34 DO NOT EXIST on WROOM-1 modules (any variant) —
      verified against Espressif DS v1.8, 2026-09-03. GPIO 35-37 are
      free on N8R2 (quad PSRAM) but go to the octal PSRAM on R8/R16V:
      the module variant is load-bearing.

    valid_pins: ["0-21", "35-48"]   # exposed on the WROOM-1 module (33/34 are not bonded out)
    adc_pins: ["1-10"]              # ADC1 — ADC2 unusable with WiFi

    gpio:
      BOOT_BUTTON:        {pin: 0,  dir: in,  note: "strapping"}
      ANALOG_IN_1:        {pin: 1,  dir: adc, note: "ADC1 — ADC2 unusable with WiFi"}
      ANALOG_IN_2:        {pin: 2,  dir: adc, note: "ADC1"}
      LED_STRIP_1_CLK:    {pin: 3,  dir: out, note: "APA102 CLK via the 74AHCT541 octal shifter; 3-/4-wire is a firmware setting (mode jumper dropped 2026-09-06). Was IR_RX until 2026-09-05 — onboard IR is useless on a hidden board; a plug-in receiver goes on any DIGITAL_IN. Strapping (JTAG select): drives only a shifter input. NOTE 2026-09-08: GPIO3 has NO internal pull — ESP32-S3 DS Table 3-1 lists it as Floating. It is safe only because the JTAG-select strap applies solely once the JTAG_SEL_ENABLE eFuse is burned. Populate R53 (the DNP pad on this net) to make it deterministic. See hardware/pro/review-2026-09-08.md"}
      LED_STRIP_1_DATA:   {pin: 4,  dir: out, note: "RMT TX, via the 74AHCT541; APA102 DATA in 4-wire mode"}
      LED_STRIP_2_DATA:   {pin: 5,  dir: out, note: "RMT TX, via the 74AHCT541; APA102 DATA in 4-wire mode"}
      LED_STRIP_2_CLK:    {pin: 6,  dir: out, note: "APA102 CLK via the 74AHCT541; 3-/4-wire is a firmware setting (mode jumper dropped 2026-09-06)"}
      I2S_BCLK:           {pin: 7,  dir: out}
      I2C_SDA:            {pin: 8,  dir: bidir, note: "PCA9685 + Qwiic"}
      I2C_SCL:            {pin: 9,  dir: out}
      DIGITAL_IN_1:       {pin: 10, dir: in,  note: "pull-up, clamp diodes, 1k series"}
      DIGITAL_IN_2:       {pin: 11, dir: in}
      DIGITAL_IN_3:       {pin: 12, dir: in}
      STEPPER_1_STEP:     {pin: 13, dir: out, note: "LEDC-capable — required for DC socket mode"}
      STEPPER_1_DIR:      {pin: 14, dir: out, note: "LEDC-capable"}
      I2S_LRCLK:          {pin: 15, dir: out}
      I2S_DOUT:           {pin: 16, dir: out}
      TMC_UART_TX:        {pin: 17, dir: out, note: "shared bus, MS1/MS2 address strapping"}
      TMC_UART_RX:        {pin: 18, dir: in}
      USB_DM:             {pin: 19, dir: bidir, note: "native USB — console lives here"}
      USB_DP:             {pin: 20, dir: bidir}
      STEPPER_2_STEP:     {pin: 21, dir: out, note: "LEDC-capable"}
      MOTOR_B_IN1:        {pin: 35, dir: out, note: "LEDC 25 kHz. Moved from GPIO33 2026-09-03: 33/34 are NOT BONDED on any WROOM-1 (Espressif DS v1.8 pin table). 35 is free on N8R2, octal-PSRAM on R8/R16V"}
      MOTOR_B_IN2:        {pin: 36, dir: out, note: "LEDC 25 kHz. Moved from GPIO34 — same finding as MOTOR_B_IN1"}
      PCA_OE:             {pin: 37, dir: out, note: "both PCA9685 ~OE, 10k pull-up to 3V3: all PCA outputs held LOW (FETs, relays off; steppers disabled) while the MCU is in reset. Init the PCAs, THEN drive LOW. N8R2 only (octal PSRAM on R8/R16V)"}
      STATUS_LED:         {pin: 38, dir: out, note: "WS2812B-mini @ 5V — data via buffer 4 of the 74AHCT541"}
      SD_CLK:             {pin: 39, dir: out, note: "SDMMC 1-bit"}
      SD_CMD:             {pin: 40, dir: bidir, note: "10k pull-up"}
      SD_D0:              {pin: 41, dir: bidir, note: "10k pull-up"}
      STEPPER_1_DIAG:     {pin: 42, dir: in,  note: "StallGuard; JP1 frees it for expansion"}
      STEPPER_2_DIAG:     {pin: 43, dir: in,  note: "StallGuard; JP2 frees it for expansion. U0TXD — ROM boot log drives it at reset; 1k series R"}
      MOTOR_A_IN1:        {pin: 44, dir: out, note: "LEDC 25 kHz"}
      EXPANSION_1:        {pin: 45, dir: out, note: "STRAPPING — must be LOW at reset. 10k pulldown + 100R series."}
      EXPANSION_2:        {pin: 46, dir: out, note: "STRAPPING — must be LOW at reset. 10k pulldown + 100R series."}
      STEPPER_2_DIR:      {pin: 47, dir: out, note: "LEDC-capable"}
      MOTOR_A_IN2:        {pin: 48, dir: out, note: "LEDC 25 kHz"}

    # Two PCA9685s since 2026-09-16 (datasheet review decision 3B): all 16
    # channels of one chip share ONE prescaler, so servos at 50 Hz forced the
    # DC dimming channels to 50 Hz flicker. Relays and stepper enable are
    # full-on/full-off and don't care which chip they're on.
    pca9685:
      - id: SERVO           # U_PCA, sheet 03
        addr: 0x40
        pwm_hz: 50
        channels:
          SERVO_1: 0
          SERVO_2: 1
          SERVO_3: 2
          SERVO_4: 3
          SERVO_5: 4
          SERVO_6: 5
          RELAY_1: 12
          RELAY_2: 13
          RELAY_3: 14
          # EN is active-low on all socketed drivers and PCA9685 powers up
          # outputs-LOW, so the EN net goes through an AO3400A inverter with
          # pull-up: drivers default DISABLED, firmware drives ch 15 HIGH
          # to enable. See hardware-spec §2.5.
          STEPPER_ENABLE: 15
      - id: DIM             # U_PCA2, sheet 03
        addr: 0x41
        pwm_hz: 1000
        channels:
          LED_1: 0
          LED_2: 1
          LED_3: 2
          LED_4: 3
          LED_5: 4
          LED_6: 5

  mini:
    # LEGACY C3 BASELINE: user selected ESP32-S3-WROOM-1U-N16R2 on 2026-09-19.
    # Replace this allocation before S3 schematic capture; changing only mcu
    # would mislabel incompatible ADC, USB and boot assignments as valid.
    # Decision: hardware/mini/module-selection-2026-09-19.md
    # Future S3: reserve GPIO15/16 for optional DNP 32.768 kHz crystal.
    # BLE standby experiments are deferred; this is not a C3 pin assignment.
    mcu: ESP32-C3-MINI-1U-N4
    notes: >
      All 15 exposed GPIO allocated — no expansion header. Qwiic is the
      entire expansion path. Audio lives in flash, not on SD: the C3 has
      no SDMMC and SPI SD would cost 4 GPIO the board cannot spare.
      Deep-sleep wake only works on GPIO 0-5, which is why DIGITAL_IN_1
      sits on GPIO 4 — put the PIR there. IR_RX (GPIO 3) can also wake.

    valid_pins: ["0-10", "18-21"]   # exposed on the C3-MINI-1 module
    adc_pins: ["0-4"]               # ADC1

    gpio:
      ANALOG_IN_1:        {pin: 0,  dir: adc, note: "ADC1"}
      BATTERY_SENSE:      {pin: 1,  dir: adc, note: "1M divider + FET disconnect for sleep"}
      RAIL_5V_ENABLE:     {pin: 2,  dir: out, note: "STRAPPING — ACTIVE-LOW. Pull-up = strap-safe boot AND rail off in deep sleep with the pin released (no GPIO hold). Drive LOW to enable. MANDATORY for sleep current."}
      IR_RX:              {pin: 3,  dir: in,  note: "RMT RX; RTC-capable — can wake from deep sleep. ⚠ REVISIT at Mini spec time: the Pro dropped onboard IR 2026-09-05 (a receiver inside a hidden enclosure can't see a remote; plug-in receiver on a DIGITAL_IN instead) — the same logic applies here, and GPIO3 is a wake-capable pin worth reclaiming"}
      DIGITAL_IN_1:       {pin: 4,  dir: in,  note: "RTC-capable — the deep-sleep wake input (PIR)"}
      I2S_LRCLK:          {pin: 5,  dir: out}
      I2S_DOUT:           {pin: 6,  dir: out}
      LED_STRIP_1_DATA:   {pin: 7,  dir: out, note: "RMT TX, via 74AHCT1G125"}
      I2C_SDA:            {pin: 8,  dir: bidir, note: "STRAPPING — I2C pull-up holds it high at boot"}
      BOOT_BUTTON:        {pin: 9,  dir: in,  note: "strapping"}
      I2C_SCL:            {pin: 10, dir: out}
      USB_DM:             {pin: 18, dir: bidir, note: "console over native USB Serial/JTAG"}
      USB_DP:             {pin: 19, dir: bidir}
      I2S_BCLK:           {pin: 20, dir: out, note: "U0RXD repurposed"}
      DIGITAL_IN_2:       {pin: 21, dir: in,  note: "U0TXD repurposed — ROM boot log drives it at reset; 1k series R"}

    pca9685:
      addr: 0x40
      channels:
        SERVO_1: 0
        SERVO_2: 1
        SERVO_3: 2
        LED_1:   3
        LED_2:   4
        LED_3:   5
        LED_4:   6
        RELAY_1: 7

constants:
  MOTOR_PWM_HZ: 25000     # never below 20 kHz — audible
  SERVO_PWM_HZ: 50
  LED_PWM_HZ: 1000
