mrwillson2u/propmesh/firmware/common/propmesh/src/pm_candle_core.h

// The electric candle's flicker and flame swing, as a pure model: no pins,
// no clock, no Arduino. pm_candle.cpp drives the LED and coil from it;
// the host tests run it for simulated hours. docs/generic-boards.md §6n.
//
// Ported from reference/candle_esp32.ino (the candle prop's own sketch):
//  - LED: a slow wander, a fast shimmer, random gusts (fast dips at
//    8-12 Hz under an envelope) and rare sputters (a near-blowout with
//    stutters, then an overshoot) — gaps between events are exponential,
//    so it never feels periodic.
//  - Coil: kicks near the flame's own swing frequency, and the wobble
//    follows the flicker: at rest, continuous kicks whose strength drifts
//    (the swing never dies); from just before a gust to just after it,
//    in-phase kicks at full strength so the swing peaks with the flicker.
// Dropped from the sketch: its auto-off timer and mode switch (the show
// schedule does that), battery compensation (a board-wide battery sense
// will do it for every output), the IR input and the serial tuning keys
// (console settings instead).
#pragma once
#include <math.h>
#include <stdint.h>
#include "pm_config.h"

#define PM_CANDLE_TICK_MS 5  // the sketch's 200 Hz flicker update
#define PUMP_LEAD_MS 400     // the coil starts pumping this long before a gust's dip
#define PUMP_TAIL_MS 1200    // and keeps pumping this long after it ends

class PmCandleCore {
 public:
  void begin(const PmCandleCfg &cfg, uint32_t now_ms, uint32_t seed) {
    c = cfg;
    rng = seed ? seed : 0x9E3779B9u;
    wander = wander_to = 0.85f;
    shimmer = shimmer_to = 0;
    next_wander = next_shimmer = now_ms;
    gust_on = sputter_on = false;
    next_gust = now_ms + (uint32_t)(exp_rand((float)c.gust_s) * 1000);
    next_sputter = c.sputter_s ? now_ms + (uint32_t)(exp_rand((float)c.sputter_s) * 1000) : 0;
    next_kick = now_ms;
    kicks_left = 0;
  }

  // A draft (c.draft 1-8): every candle in it gusts and sputters at the
  // same moment with the same shape, worked out from the shared mesh clock
  // and the draft's number — no messages, and it works out of radio range.
  // Each mesh second is a lottery: hash(draft, second) decides whether a
  // gust (or sputter) starts in that second, with the same odds as the
  // candle's own timers (1 / gust_s per second), and the hash also picks
  // the gust's depth, length and speed so they match. Call once per tick
  // before led(); `synced` false (no conductor) = back to the local timers.
  void draft_tick(uint32_t now, bool synced, int64_t mesh_us) {
    if (!c.draft || !synced) { draft_live = false; return; }
    draft_live = true;
    int64_t sec = mesh_us / 1000000;
    if (sec == draft_sec) return;
    draft_sec = sec;
    uint32_t h = mix((uint32_t)sec * 0x9E3779B1u ^ (c.draft * 0x85EBCA6Bu));
    // The draft shares the moment and the strength of the wind; each candle
    // answers in its own way — its own delay (a breath crosses the row, up to
    // a third of a second), its own length, depth and dip rhythm from its
    // own randomness. The first version copied the whole gust shape from
    // the hash, and the lights dipped on exactly the same beat (Colin,
    // 2026-10-22).
    if (!gust_on && !sputter_on && !draft_gust_at && c.gust_s && (h % c.gust_s) == 0) {
      draft_gust_at = now + (uint32_t)irange(0, 350);
      draft_gust_strength = 0.8f + ((h >> 16) % 400) / 1000.0f;  // 0.8-1.2, the same for the whole draft
    }
    uint32_t h2 = mix(h ^ 0x5bd1e995u);
    if (!sputter_on && !draft_sputter_at && c.sputter_s && (h2 % c.sputter_s) == 0)
      draft_sputter_at = now + (uint32_t)irange(0, 400);
  }

  // Brightness 0..1 for the LED at `now`, before gamma. Call every tick
  // (dt_ms since the last call).
  float led(uint32_t now, uint32_t dt_ms) {
    float d = c.drama10 / 10.0f;
    if (draft_gust_at && due(now, draft_gust_at)) {  // the draft's gust reaches this candle
      draft_gust_at = 0;
      if (!gust_on && !sputter_on) {
        gust(now);  // its own length, depth and rhythm...
        gust_depth = clampf(gust_depth * draft_gust_strength, 0, 0.92f);  // ...at the wind's strength
      }
    }
    if (draft_sputter_at && due(now, draft_sputter_at)) {
      draft_sputter_at = 0;
      if (!sputter_on) sputter(now);
    }
    if (due(now, next_wander)) {
      wander_to = range(0.76f, 0.92f);
      next_wander = now + (uint32_t)range(300, 1500);
    }
    wander += (wander_to - wander) * clampf(dt_ms / 600.0f, 0, 1);
    if (due(now, next_shimmer)) {
      shimmer_to = range(-0.05f, 0.05f) * d;
      next_shimmer = now + (uint32_t)range(40, 120);
    }
    shimmer += (shimmer_to - shimmer) * 0.25f;

    // The candle's own timers — unless a draft decides for it.
    if (!draft_live && !gust_on && !sputter_on && due(now, next_gust)) {
      gust(now);
      next_gust = now + (uint32_t)(exp_rand((float)c.gust_s) * 1000);
    }
    if (!draft_live && c.sputter_s && !sputter_on && due(now, next_sputter)) {
      sputter(now);
      next_sputter = now + (uint32_t)(exp_rand((float)c.sputter_s) * 1000);
    }

    float env = envelope(now), g = 1.0f;
    env_now = env;
    if (env > 0) {
      gust_phase += (dt_ms / 1000.0f) * gust_hz * range(0.85f, 1.15f);
      g = 1.0f - gust_depth * env * dip(gust_phase);
    }
    float b = (wander + shimmer) * g * sputter_mult(now);
    return clampf(b, c.floor / 100.0f, 1.0f);
  }

  // Width of a coil kick that starts at `now` (ms), or 0 for none.
  // Tuning (the sketch's "steady kicking, resonance hunt"): kick every
  // cycle at `chz` with no rests and no gust pumping, so the eye judges
  // one thing — how far the flame swings at this rate. 0 = back to normal.
  // `kick_ms` 0 = the configured width. `burst`: kick in the normal sets of
  // 3-5 with rests between, instead of steadily — a rest lets the next set
  // catch the flame at a different phase, which can start a swing that
  // steady kicking at a slightly wrong rate never does (Colin, 2026-10-16).
  void tune(uint16_t chz, uint8_t kick_ms = 0, bool burst = false) { tune_chz = chz; tune_kick = kick_ms; tune_burst = burst; }
  uint16_t tuning() const { return tune_chz; }

  uint16_t kick(uint32_t now) {
    if (!due(now, next_kick)) return 0;
    if (tune_chz && !tune_burst) {
      next_kick = now + (uint32_t)(100000.0f / tune_chz);
      return tune_kick ? tune_kick : c.kick_ms;
    }
    float period = 100000.0f / (tune_chz ? tune_chz : c.swing_chz ? c.swing_chz : 1);
    uint16_t width = tune_chz && tune_kick ? tune_kick : c.kick_ms;
    float drama = c.drama10 / 10.0f;
    // A gust, from PUMP_LEAD_MS before the light dips (the firmware knows it
    // is coming) to PUMP_TAIL_MS after: pump in phase at full strength, so
    // the swing peaks with the flicker instead of after it. A pendulum takes
    // several swings to build, and the first version let it die between sets
    // and then couldn't catch up with a violent flicker (Colin, 2026-10-17).
    bool pre = !draft_live && !gust_on && !sputter_on && next_gust && (int32_t)(now - (next_gust - PUMP_LEAD_MS)) >= 0;
    if (gust_on || sputter_on) pump_until = now + PUMP_TAIL_MS;
    pumping_now = pre || gust_on || sputter_on || (int32_t)(now - pump_until) < 0;
    if (!tune_chz && pumping_now) {
      next_kick = now + (uint32_t)(period * (1.0f + 0.02f * range(-1, 1)));
      kicks_left = 0;
      float w = c.kick_ms * (1.0f + 0.7f * clampf(drama, 0, 1));
      if (sputter_on) w *= 1.15f;
      return c.coil ? (uint16_t)clampf(w, 4, 100) : 0;
    }
    if (kicks_left <= 0) {
      // At rest the swing is never allowed to die: kicks keep coming at the
      // rate, in runs of 4-10 whose strength drifts between 0.75× and 1.0×
      // the kick, with a short pause (0.15-0.45 s, about one swing) between
      // runs and one kick in fourteen skipped — variety without losing
      // momentum. (Was 0.6×, 0.2-0.6 s, one in ten: on the candle the resting
      // flame read as a little too still, 2026-10-18.)
      kicks_left = irange(4, 10);
      burst_scale = clampf(burst_scale + range(-0.15f, 0.15f), 0.75f, 1.0f);
      next_kick = now + (uint32_t)range(150, 450);
      return 0;
    }
    kicks_left--;
    next_kick = now + (uint32_t)(period * (1.0f + 0.04f * range(-1, 1)));
    if (tune_chz) return width;
    if (rand01() < 0.07f) return 0;  // the skipped kick
    return c.coil ? (uint16_t)clampf(width * burst_scale, 4, 100) : 0;
  }

  void gust(uint32_t now) {
    gust_on = true;
    gust_start = now;
    gust_dur = (uint32_t)range(600, 2200);
    gust_depth = clampf(range(0.5f, 0.8f) * c.drama10 / 10.0f, 0, 0.92f);
    gust_hz = range(8.0f, 12.0f);
  }
  void sputter(uint32_t now) {
    sputter_on = true;
    sputter_start = now;
    next_stutter = now;
    gust(now);
    gust_dur = 1600;
  }
  bool gusting() const { return gust_on || sputter_on; }
  bool pumping() const { return pumping_now; }  // the coil is in its gust pattern (lead, gust, tail)

 private:
  static float clampf(float v, float lo, float hi) { return v < lo ? lo : v > hi ? hi : v; }
  static float lerpf(float a, float b, float t) { return a + (b - a) * clampf(t, 0, 1); }
  static bool due(uint32_t now, uint32_t at) { return (int32_t)(now - at) >= 0; }
  static uint32_t mix(uint32_t x) {  // a small integer hash (murmur3 finalizer)
    x ^= x >> 16; x *= 0x85EBCA6Bu; x ^= x >> 13; x *= 0xC2B2AE35u; x ^= x >> 16;
    return x;
  }
  float rand01() {  // xorshift32
    rng ^= rng << 13; rng ^= rng >> 17; rng ^= rng << 5;
    return (rng >> 8) * (1.0f / 16777216.0f);
  }
  float range(float a, float b) { return a + (b - a) * rand01(); }
  int irange(int a, int b) { return a + (int)(rand01() * (b - a + 1)); }
  float exp_rand(float mean) { return -logf(1.0f - rand01() * 0.9999f) * mean; }

  float envelope(uint32_t now) {
    if (!gust_on) return 0;
    float t = (float)(now - gust_start), d = (float)gust_dur;
    if (t >= d) { gust_on = false; return 0; }
    if (t < 150) return t / 150.0f;
    if (t < 0.6f * d) return 1.0f;
    float x = 1.0f - (t - 0.6f * d) / (0.4f * d);
    return x * x;
  }
  static float dip(float phase) {  // falls fast, recovers slow
    float p = phase - floorf(phase);
    return p < 0.3f ? p / 0.3f : 1.0f - (p - 0.3f) / 0.7f;
  }
  float sputter_mult(uint32_t now) {
    if (!sputter_on) return 1.0f;
    uint32_t t = now - sputter_start;
    if (t < 80) return lerpf(1.0f, 0.05f, t / 80.0f);
    if (t < 700) {
      if (due(now, next_stutter)) {
        stutter = range(0.03f, 0.45f);
        next_stutter = now + (uint32_t)range(30, 70);
      }
      return stutter;
    }
    if (t < 1100) return lerpf(0.45f, 1.18f, (t - 700) / 400.0f);  // overshoot
    if (t < 1500) return lerpf(1.18f, 1.0f, (t - 1100) / 400.0f);
    sputter_on = false;
    return 1.0f;
  }

  PmCandleCfg c;
  uint32_t rng = 1;
  float wander = 0.85f, wander_to = 0.85f, shimmer = 0, shimmer_to = 0;
  uint32_t next_wander = 0, next_shimmer = 0;
  bool gust_on = false, sputter_on = false;
  uint32_t gust_start = 0, gust_dur = 0, next_gust = 0;
  float gust_depth = 0, gust_hz = 10, gust_phase = 0;
  uint32_t sputter_start = 0, next_sputter = 0, next_stutter = 0;
  float stutter = 0.05f;
  uint32_t next_kick = 0;
  int kicks_left = 0;
  uint16_t tune_chz = 0;
  uint8_t tune_kick = 0;
  bool tune_burst = false;
  float env_now = 0;        // the gust envelope this tick
  float burst_scale = 0.9f; // the resting run's strength, drifting 0.75-1.0
  uint32_t pump_until = 0;  // pumping continues until this after a gust
  bool pumping_now = false;
  bool draft_live = false;   // a draft is deciding the gusts this tick
  int64_t draft_sec = -1;    // the last mesh second judged
  uint32_t draft_gust_at = 0, draft_sputter_at = 0;  // when the draft's gust/sputter reaches this candle (0 = none pending)
  float draft_gust_strength = 1.0f;                  // the draft's shared strength for the next gust
};
