mrwillson2u/propmesh/firmware/common/propmesh/src/pm_mesh.h

// PropMesh flood mesh core — ESP-NOW broadcast flooding.
// Design: docs/software-plan.md §3. Connectionless: no peers, no topology
// state. Frames carry (src, seq, ttl); relay-role nodes rebroadcast once
// after jitter; everyone dedups on a (src, seq) sliding window.
#pragma once
#include <stdint.h>
#include "proto_gen.h"
#include "pm_neighbors.h"
#include "pm_time.h"

// Handler receives every valid, non-duplicate frame addressed to the mesh.
// `rssi` is the received signal strength of the last hop (dBm).
typedef void (*pm_rx_handler_t)(const pm_frame_header_t *hdr,
                                const uint8_t *payload, uint8_t len,
                                int8_t rssi);

typedef struct {
  uint32_t rx;            // valid frames delivered to the app
  uint32_t tx;            // frames originated by this node
  uint32_t relayed;       // frames rebroadcast for others
  uint32_t dropped_dupe;  // dedup window hits
  uint32_t dropped_bad;   // wrong magic / net / version / size
  uint32_t relay_overrun; // relay queue full — frame not forwarded
  uint32_t tx_err;        // esp_now_send refused a frame (ours or a relay)
  int32_t last_tx_err;    // its esp_err_t, 0 = none yet
  // Frames the radio accepted vs. frames it reported done (the send
  // callback). The difference is what the driver still holds: a count
  // that only ever grows is the WiFi TX buffer leak of esp-idf #18682
  // (docs §6j) — when it reaches the pool, every send fails NO_MEM.
  volatile uint32_t tx_sent;      // esp_now_send returned ESP_OK
  volatile uint32_t tx_done;      // send callbacks, any status
  volatile uint32_t tx_failed;    // of those, status != success (no air time)
  volatile uint32_t tx_done_ms;   // millis() of the last callback
  // The send queue (docs §6j): one frame in flight at a time.
  uint32_t tx_lost;        // dispatched, no completion within the timeout — the driver dropped it
  uint32_t tx_queue_full;  // frames refused because the queue was full
  uint8_t tx_queue_max;    // deepest the queue has been since boot
} pm_stats_t;

// Frames handed to the radio whose completion has not come back.
uint32_t pm_mesh_tx_inflight();
// Non-zero when the radio looks wedged: eight dispatches in a row with no
// completion — the time since the last completion (ms).
uint32_t pm_mesh_tx_stuck_ms();

// Bring up WiFi STA + ESP-NOW on `channel` and join network `net_id`.
// `role` is pm_node_role_t flags; PM_NODE_ROLE_RELAY enables rebroadcast,
// PM_NODE_ROLE_CONDUCTOR makes this node the mesh time authority.
bool pm_mesh_init(uint8_t channel, uint16_t net_id, uint8_t role);
// Cap the radio at 13 dBm (true) or give it the driver's full power; set
// before pm_mesh_init to apply from the first frame (pm_mesh.cpp).
void pm_mesh_low_power(bool low);
bool pm_mesh_is_low_power();

// This node's id (last 4 bytes of the efuse MAC).
uint32_t pm_node_id();

// Roles are runtime state, not a build flag: a node is promoted to
// conductor (or bridge) by config or election, and a conductor steps
// down on its own when it hears a higher-id conductor.
uint8_t pm_role();
void pm_set_role(uint8_t role);

// Broadcast a message into the flood. `len` <= PM_MAX_PAYLOAD.
bool pm_send(pm_msg_type_t type, const void *payload, uint8_t len,
             uint8_t ttl = PM_DEFAULT_TTL);

void pm_on_receive(pm_rx_handler_t handler);

// --- channel -------------------------------------------------------------
// The mesh lives on whatever channel the bridge is on (a bridge on home
// WiFi follows its router). Heartbeats carry it; a node that hasn't heard
// a bridge for a while scans 1-13 for one and moves (docs §6d).
uint8_t pm_mesh_channel();
// Force a channel now (bridge without WiFi, or a bench test).
void pm_mesh_set_channel(uint8_t ch);
// Bring ESP-NOW back after anything that stopped the WiFi driver
// (WiFi.mode(WIFI_OFF), disconnect(true)): the driver drops the ESP-NOW
// registration and every send fails with "esp now not init" until this
// runs. Also sets the channel back to `ch`.
bool pm_mesh_recover(uint8_t ch);

// The show's stamps (schema Time, docs §6k): the conductor beacons its
// own; followers get the conductor's in the callback and pull what is
// newer than theirs (pm_show.cpp).
typedef struct {
  uint8_t mode_manual;  // PmMode or 0xFF = no hold
  uint32_t mode_at, mode_until, sched_at, show_at, floods_at;
} pm_show_stamps_t;
void pm_mesh_set_stamps(const pm_show_stamps_t &s);
// Called (from the mesh receive path — keep it quick) with the stamps of
// each beacon from the conductor this node follows.
void pm_mesh_on_stamps(void (*cb)(uint32_t conductor, const pm_show_stamps_t &s));

// "Nobody hears me": how long this node has been hearing neighbors'
// heartbeats while none of them lists it as a neighbor — i.e. its own
// frames aren't getting out. 0 = fine, or nothing to judge by (no
// mains-powered neighbor with room in its list heard in the last 20 s).
// Found 2026-10-12: Prop heard the bridge and the Feather at -35 dBm for
// hours while neither heard it, with nothing on any log.
uint32_t pm_mesh_unheard_ms();
void pm_mesh_unheard_reset();  // start judging afresh (after a radio restart)
// Called when this node moves to a new channel (persist it for next boot).
void pm_mesh_on_channel(void (*cb)(uint8_t));
// True when this board has never followed a bridge (no stored channel):
// it searches for one properly (6 s per channel, repeating) until it does.
void pm_mesh_set_fresh(bool fresh);
// Seconds since a bridge was last heard; 0xFFFF = never.
uint16_t pm_mesh_bridge_age_s();

// --- sleepy leaves (docs §6f) --------------------------------------------
// The longest listen interval any battery board on the mesh advertised in
// the last minute (0 = everyone listens all the time). Senders repeat a
// cue or a wake-up across it so one copy lands in the board's window.
uint16_t pm_mesh_leaf_listen_ms();
bool pm_mesh_is_leaf(uint32_t id);  // advertised a listen interval recently
// This node's own sync may age this long before counting as stale (a
// leaf that hears one beacon in ten raises it).
void pm_mesh_set_stale_ms(uint32_t ms);
bool pm_mesh_scanning();

// Call every loop(): flushes the jittered relay queue, ages the neighbor
// table, and emits the time beacon when this node is conductor.
void pm_mesh_loop();

// --- Mesh time -------------------------------------------------------
// Shared timebase for cue scheduling. Valid only while pm_time_synced().
int64_t pm_mesh_time_us();
// Local microseconds at which a given mesh time arrives — turns a cue's
// scheduled time into a local deadline.
int64_t pm_local_time_us(int64_t mesh_time_us);
bool pm_time_synced();
uint32_t pm_conductor_id();
uint8_t pm_sync_hop();  // hops from the conductor; 0 = we are it

// Wall clock (show schedule). Set by the console or SNTP; followers take
// the conductor's from its TIME beacon. pm_wall().ok() before trusting it.
PmWallClock &pm_wall();
int64_t pm_wall_utc_ms();
// The jump (local − conductor, ms) the wall clock took at the first
// conductor beacon after boot; false until there was one, or if the clock
// wasn't set before it. A board waking from deep sleep reads its drift here.
bool pm_wall_first_step(int64_t *ms);
// millis() of the latest bridge beacon or heartbeat heard; 0 = none yet.
uint32_t pm_mesh_bridge_heard_at_ms();

// --- Topology --------------------------------------------------------
// Nodes heard directly, strongest first. Fills the heartbeat's neighbor
// list, which the console renders as the mesh graph.
uint8_t pm_neighbor_snapshot(pm_neighbor_t *out, uint8_t max);

const pm_stats_t *pm_stats();
