mrwillson2u/propmesh/firmware/node/build_id.py

# PlatformIO extra script: stamp the build with the git commit (plus "+"
# if the tree was dirty) as PM_BUILD, and write version.json next to
# firmware.bin for tools/ota_serve.py and the console's update panel.
import hashlib, json, os, subprocess, time
Import("env")

def git(*args):
    try:
        return subprocess.check_output(["git", *args], stderr=subprocess.DEVNULL).decode().strip()
    except Exception:
        return ""

commit = git("rev-parse", "--short", "HEAD") or "nogit"

# Uncommitted work gets "+" and a hash of exactly what differs from the
# commit (changed AND new files under the source the image is built
# from). Until 2026-10-09 it was just "+", so two different uncommitted
# builds both read "b99d9a4+" and the console's update panel called a
# board running old code "up to date".
SOURCES = ["firmware", "schema", "boards"]
def dirty_hash():
    h = hashlib.sha1()
    root = git("rev-parse", "--show-toplevel")
    diff = subprocess.run(["git", "diff", "HEAD", "--", *SOURCES], cwd=root, capture_output=True).stdout
    h.update(diff)
    new = git("-C", root, "ls-files", "--others", "--exclude-standard", "--", *SOURCES).splitlines()
    for f in sorted(new):
        h.update(f.encode())
        try:
            h.update(open(os.path.join(root, f), "rb").read())
        except OSError:
            pass
    return h.hexdigest()[:6] if (diff or new) else ""

d = dirty_hash() if commit != "nogit" else ""

# The branch, so a build that is not the published one says so in its
# name: "<commit>@<branch>". main is the release and stays plain; dev
# reads "@dev"; anything else is a branch build (Colin's ask, 2026-10-23:
# he is fine with branch builds on boards for testing as long as the
# console says which). PM_BRANCH overrides (the site builds from a detached
# checkout); GitHub Actions names the branch in GITHUB_HEAD_REF (a PR) or
# GITHUB_REF_NAME (a push).
def branch_name():
    for k in ("PM_BRANCH", "GITHUB_HEAD_REF", "GITHUB_REF_NAME"):
        if os.environ.get(k):
            return os.environ[k]
    b = git("rev-parse", "--abbrev-ref", "HEAD")
    if b and b != "HEAD":
        return b
    for name in ("main", "dev"):  # detached: on a published branch's tip?
        if git("rev-parse", "origin/" + name) == git("rev-parse", "HEAD"):
            return name
    return "detached"
branch = branch_name()
short = branch.split("/")[-1][:18]
tag = "" if branch == "main" else "@" + short
build = commit + ("+" + d if d else "") + tag

# When it was built (UTC seconds): the console tells a newer branch build
# from an older release by this, since commit names have no order.
built = int(time.time())
env.Append(CPPDEFINES=[("PM_BUILD", env.StringifyMacro(build)), ("PM_BUILT", str(built))])

def write_version(source, target, env):
    bin_path = str(target[0])
    data = open(bin_path, "rb").read()
    info = {"build": build, "commit": commit, "branch": branch, "built": built,
            "size": len(data), "sha256": hashlib.sha256(data).hexdigest(), "env": env["PIOENV"]}
    with open(os.path.join(os.path.dirname(bin_path), "version.json"), "w") as f:
        json.dump(info, f)
    print(f"build {build}: firmware.bin {len(data)} bytes")

env.AddPostAction("$BUILD_DIR/${PROGNAME}.bin", write_version)
