mrwillson2u/propmesh/(commit log)

2026-09-04 Mesh firmware core, protocol codegen, software plan, CI
    - ESP-NOW flood mesh library (dedup bitmap, TTL relay w/ jitter,
    conductor time-sync with relay re-stamping, highest-id election)
    with 21 host-native unit tests and a devkit testbed target
    - schema/messages.yaml -> genmsg.py -> C/TS bindings, CI-checked
    like the pinmap
    - docs/software-plan.md: architecture, protocol, console views,
    Oct-2026 show track vs real stack
    - reference/: scrubbed imports of the painlessMesh-era prototypes
    (live-credential originals stay gitignored in old_files/)
    - CI consolidated to ci.yml: generated-files check, firmware
    tests/build, console typecheck/build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
2026-09-04 Console SPA: Yard, Nodes, Cues, Show Graph views
    Vite+React scaffold with prop icon set, store, mesh client stub,
    and the design brief handed to the visual design pass.
2026-09-04 Hardware: sheet 01 (power) captured, verified, fully sourced
    - KiCad schematic: protection stage (fuse, reverse-polarity P-FET
    w/ gate clamp, TVS), AP64350 5V rail, TLV62569 3.3V rail, dual
    DC input (DG128 screw terminal + DC-044A barrel jack)
    - tools/checknet.py: per-sheet connection spec (.net.yaml) diffed
    against kicad-cli netlist; renders wiring diagrams and a
    colored check page; verifies footprint assignments
    - state at commit: checknet all green, ERC zero violations, all 5
    imported land patterns datasheet-verified (both inductor imports
    were wrong and are fixed; mechanical holes corrected to NPTH)
    - every part carries a live LCSC number/tier/price; power section
    $6.73 @10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
2026-09-04 Sheet 02 (MCU+USB) captured + GPIO 33/34 pinmap fix + multi-sheet checker
    - FINDING: GPIO 33/34 are not bonded out on ANY ESP32-S3-WROOM-1
    variant (Espressif DS v1.8 pin table) — the old open item's premise
    was wrong. MOTOR_B_IN1/IN2 moved to GPIO 35/36, headers regenerated;
    IO37 is now the only spare pin. N8R2 variant is load-bearing twice
    (octal PSRAM consumes IO35-37). Closes verification item #1.
    - Sheet 02 drawn and verified: checknet all nets+footprints green,
    ERC clean. Module C3013944, USB-C C165948 (KiCad ships the
    vendor-exact HRO footprint), ST USBLC6, SS34, all sourced with
    verified LCSC numbers; MCU block $4.11@100 vs $3.72 estimate.
    - checknet.py grows up for mu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
2026-09-04 Sheet 03 (slow outputs) captured + channel redesign to supply voltage
    - LED-channel decision resolved: all 6 channels kept, discrete AO3400A
    low-side FETs (Basic, replaces sheet 06's 2N7002 too — one MOSFET
    part number board-wide); ULN2003 drives relays only
    - Channels re-pointed +5V -> VIN_PROT with SS34 flyback per channel:
    2 A/ch, 5 A aggregate, 12/24 V lights and pneumatic solenoids are
    first-class loads. Supply-voltage coupling documented in the spec's
    user guidance (match supply to lights; mixed-voltage recipe)
    - HK4100F relay: symbol+footprint imported, land pattern verified,
    EasyEDA inverted-pin defect fixed in library (4th known import lie,
    added to checklist); coil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
2026-09-04 Sheet 04 (audio + SD) captured: mono amp, PCM5102A line-out, microSD
    - MAX98357A config resolved datasheet-exact: GAIN_SLOT->GND = 12 dB
    (zero parts); SD_MODE mono mix via 620k to +3V3 (RLARGE formula,
    window computed vs trip points; rail chosen for noise margin and
    the one-rail strap convention). Genuine ADI $0.88@100 dissolved
    the clone question.
    - Line-out dropped then REVERSED same day (Colin): PCM5102A second
    DAC on the shared I2S bus, TI Fig.33 literal (SCK grounded = BCK
    PLL), 470R+2.2nF outputs, PJ-320A jack. ~$1.65 for the honest
    version; audio block $3.28@100 verified vs $2.65 estimate.
    - PJ-320A mapping settled by geometry after THREE numbering schemes
    collided (da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
2026-09-05 Sheet 06 (motors) captured: stepper sockets + DRV8871, all spec unknowns closed
    - Open item #3 CLOSED from the Pololu md09b drawing: StepStick rows
    12.70 mm apart exactly, 1x8 @ 2.54; RST/SLP positions hardwired
    together = A4988-legal AND the TMC2209 PDN_UART bus (shared, both
    sockets, MS1/MS2 straps = addresses); DIAG via per-socket aux
    headers + bridged solder jumpers (vendor positions differ);
    1k series on GPIO43 (U0TXD boot log)
    - ILIM verified from TI DS: ITRIP = 64000/R; 30k = 2.13 A/channel
    - Import lie #6 caught: DRV8871's generic footprint name collided
    with the AP64350's and --overwrite silently replaced it (geometry
    happened to be identical; only the LCSC property fl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
2026-09-05 Sheet 07 (sensors + expansion) captured; sheet 05 spec ready
    Sheet 07 drawn and verified: 3 clamped digital inputs (+ PIR header),
    2 halved analog inputs, TSOP38238 on filtered 3V3, Qwiic (SH-1.0 clone
    C7430446 — genuine JST stock-dead), 2x5 expansion header with GPIO45/46
    strap protection. checknet all green, ERC clean bar the 4 LED labels
    awaiting sheet 05. D2_MID global on motors + sensors sheets so
    expansion pin 9 rides GPIO43's 1k.
    Sheet 05 spec: AHCT125 moved to SOIC-14 C155176 (TSSOP dead at JLC),
    strip 2 = 2x DG128-02P (04P dead), WS2812B-MINI-X2 status pixel
    imported + datasheet-verified (pins, land pattern, VIH math).
    Cost: all seven blocks now verified; parts subtotal $31.93,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
2026-09-07 Pro schematic complete; enclosure, layout guide, timeline and radio decisions
    Schematic: all seven design sheets drawn and green; project-wide ERC at
    zero. IR receiver dropped (hidden board can't see a remote — plug-in on
    a DIGITAL_IN); GPIO 3 became LED_STRIP_1_CLK; both strip outputs 3- or
    4-wire through one octal SN74AHCT541DWR (three revisions of the shifter
    in one day, no mode jumpers). Input FET symbol replaced: KiCad 10's
    Device:Q_PMOS numbers pins D/G/S and matches no pad — the part would
    have been unconnected with no ERC/DRC complaint. All 196 references
    renumbered to standard sequential designators (yaml keeps spec names;
    the checker prints both). Sheet 08 (test points) and the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
2026-09-07 Sheet 08 (test points) + staged-power link headers; board synced 239/239
    Sheet 08: 33 GPIO test points, 6 rail pads, DNP strap pad on GPIO 3 —
    labels, values, wires and footprints generated from the yaml
    (tools-side, not typed), power symbols cloned with every coordinate
    shifted so texts travel with their parts. Sheet 01: JP_VIN / JP_5V /
    JP_3V3 2-pin headers + shunts between input → 5 V buck → +5V rail →
    +3V3 rail (spec §2.6 staged bring-up; a meter across a pulled shunt
    reads that rail's current); PWR_FLAGs re-homed to the far side of each
    jumper. Values use Colin's JP_* names; jumper pin numbering follows
    the drawing.
    All eight sheets green, ERC 0 violations, board updated with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
2026-09-19 Pro v0.1: board setup + placement, two design reviews applied, datasheet-review changes specced
    Checkpoint of two weeks' work since dacce25. The schematic is MID-EDIT:
    sheets 02/04/05/07/08 checkers are red by design until the changes in
    hardware/pro/schematic-changes-2026-09-16.md are drawn; sheet 03 is
    half-drawn (see finish-v0.1.md).
    Layout
    - layout.md rebuilt as one ordered procedure (Part A) with a
    where-you-are line; Board Setup, outline, origin, frozen 120x90 hole
    pattern; routing and pour guidance; per-net noise keep-outs
    - tools: checksetup.py (setup/outline/holes/netclasses/socket rows),
    placeboard.py, placetps.py (test points on B.Cu for bodge + pogo rig),
    setpos.py, snap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
2026-10-03 Pro v0.1 schematic complete; board cleanup pass, parity 0
    Schematic: all datasheet-review changes drawn (decisions 1A, 2A, 3B,
    OE on GPIO 37, 4B). All eight sheet checkers ALL NETS MATCH, ERC 0
    errors / 0 warnings, pinmap matches generated headers.
    - sheet 03: second PCA9685 (U12, 0x41) with B-straps, PCA_OE net with
    10k pull-up (R59); DC FETs Q1-Q6 = SI2356DS
    - sheets 02/04/05/07/08: USB link/22R/VBUS cap, SD DAT1/DAT2 pull-ups,
    shifter pulldowns, 2.2k 1206 sensor Rs; R53 (GPIO3 pulldown) now drawn
    on sheet 05, specs moved to match
    Board (KiCad closed, backup kept):
    - F8 done, schematic parity 0; orphan DNP R53 removed
    - mounting holes H1-H4, board-only, excluded from BOM/position fi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
2026-10-06 Generic ESP32 boards: console pin assignment, bridge, config over the mesh
    Off-the-shelf ESP32 DevKit V1s now run PropMesh with no compiled-in pin
    map: the console assigns each pin a function (relay, LED dimmer, servo,
    DC motor, WS2812 strip, sensor input), the node validates and stores it
    in flash, and runs it with no laptop attached. Assignments create
    logical channels (SERVO_1...); GPIO numbers never leave the node.
    Stage 1 - one devkit on USB:
    - boards/*.yaml + tools/genboards.py: per-pin capabilities and function
    requirements, generated into firmware and console tables (CI check)
    - pm_pinrules.h: validator (input-only pins, strapping pins, USB serial,
    double use, LEDC/RMT budgets);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
2026-10-06 Console: keep the USB link open across view switches and hot reloads
    The mesh panel closed the serial port in an effect cleanup, which also
    runs when you switch views and on every Vite hot reload — leaving the
    panel holding a released writer ("Failed to execute 'write' on
    'WritableStreamDefaultWriter'") and every node shown as missing.
    The open link, node list and selection now live in lib/connection.ts,
    outside the component; only Disconnect or an unplug ends the link. A
    link used after it died rejects with "USB disconnected — reconnect the
    node" instead of a stream error.
2026-10-06 Console: demo data off by default, Settings toggle, real STOP ALL
    The design handoff's mock yard (lib/mesh.ts) was always on, mixed in
    with the real boards. It is now off by default; Settings -> Show demo
    data brings it back (per browser). With it off, Nodes & Channels shows
    only real boards, Yard / Cues / Show Graph say they aren't wired to real
    data yet (with a one-click preview), and the sidebar shows the real USB
    connection and node count.
    STOP ALL was cosmetic: it changed the screen and sent nothing. It now
    sends all_off to every node the console knows about, each independently,
    and the stopped banner names any node that didn't confirm.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
2026-10-06 Mesh: per-boot id in every frame, so a restarted node is heard at once
    Opening a classic devkit's USB port resets it, so connecting the console
    restarts the bridge and its frame sequence starts again at 1. Receivers
    treated a sender as restarted only after a 1024+ backwards jump; a
    bridge a few minutes old had sent a few hundred frames, so everything it
    sent after a reset was dropped as an old duplicate until its new counter
    overtook the old one (30 s+ on the bench).
    FrameHeader gains boot_id (random, non-zero, per boot); PmDedup resets a
    source's window when its boot_id changes. Frame format change: all nodes
    must be reflashed together.
    Verified on 3 DevKit V1s: after 300 frames of traffi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
2026-10-06 Servo reverse and calibration: capture the current position as min/max
    - min_us / max_us are now the pulse at 0 % and 100 %, either way round:
    min above max is "reverse". The console's reverse box swaps them, so
    there is no separate flag that could disagree with the ends.
    Validator: each 400-2600 us and >= 50 us apart.
    - set accepts "us" for a SERVO: drives the raw pulse (clamped 400-2600)
    regardless of the end stops, so a new end can be found beyond them.
    - Console: Calibrate on each saved servo swaps the test slider for the
    raw pulse with "Set as min" / "Set as max"; works with unsaved edits
    so both ends can be captured, then saved once. Leaves calibrate mode
    on save (the nod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
2026-10-06 Pin recommendations: best use per pin, pin guide, placement tips
    Each pin in a board profile now names a best use and other good uses,
    plus one line per function on why (boards/esp32-devkit-v1.yaml): servos
    on D25/D26/D27/D13/D4, motors on D18+D19, relays on D21-D23, strips on
    RX2/TX2, LED dimmers on the boot-quirk pins (D2/D5/D15/D14/D12),
    sensors on the input-only pins and buttons on D32/D33.
    genboards.py validates the advice against the rules: every usable pin
    gets a recommendation, a recommendation must be something the pin can
    do, and never a servo/motor/relay on a pin that glitches at power-up.
    Advice reaches the console only; the firmware tables are unchanged.
    Console: a collapsible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
2026-10-06 Servo smoothing: accelerate, cruise and brake to each new position
    Per-servo travel_ms (full sweep at cruise speed) and ease_ms (time to
    reach cruise); 0/0 snaps as before and stays the default. The node runs
    a follower (pm_motion.h, 50 Hz) rather than a fixed curve per move:
    retargeting mid-move keeps the current velocity, so a dragged slider is
    one fluid motion; it brakes to arrive without overshoot and is clamped
    to the travel range, so reversing near an end never pushes past the end
    stop. First move from limp and calibration pulses stay immediate.
    Validator: sweep <= 10 s, ease <= 5 s (servo_motion). Console: a
    smoothing preset per servo (Off, Snappy 250/80, Smooth 600/200, Slow
    1500/40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
2026-10-06 Servo smoothing: add Gentle preset (1000 ms sweep, 450 ms ease)
    Between Smooth and Slow in speed with the softest ease of the presets;
    Smooth still felt abrupt on the heads prop and Slow was too slow.
2026-10-06 Stage 3: sequences and sensor triggers, stored on the boards
    Sequences are show-wide lists of timed steps on any node's outputs;
    each node stores only its own part, plus the triggers on its own
    sensors, in /show.json — the show runs with no laptop or bridge. A
    trigger fires CUE(sequence, fire_at = mesh now + 200 ms), sent 3x and
    de-duplicated by cue_id; every node with a part starts it at the same
    mesh time. Per-rule cooldown; late cues catch up; up to 4 sequences
    play at once per node. Nodes boot armed; disarmed nodes ignore cues and
    triggers. STOP ALL now disarms every node before all-off; RE-ARM arms.
    Firmware: pm_show_core.h (pure: player, triggers, cue memory,
    validation), pm_show_js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
2026-10-06 Stage 3 fixes: 19 KB stack temporary crash-looped boards; seq vs id
    - pm_show_begin cleared the show with `show = PmShow()`, a 19 KB
    temporary on the 8 KB loop-task stack: every board crash-looped at
    boot (StoreProhibited, lwip assert, watchdog). Clear in place
    (PmShow::clear, PmSequence::clear). firmware/node now builds with
    -Wframe-larger-than=3072, which flags the old line (19 248 bytes).
    - get_sequence / delete_sequence took the sequence id as "id", which is
    the request number: the wrong sequence was read, and from the console
    the reply never matched its request. Now "seq"; the console's serial
    transport refuses a body field named "id".
    Verified on 3 boards: parts validate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
2026-10-06 Cues: live preview — dragging a step's servo/LED/strip value moves the real output
    On by default (toggle in the sequence header). One request in flight per
    output, newest value queued, so a drag over the mesh tracks without a
    backlog. Relays and motors only change on Test. Works while disarmed.
2026-10-06 Ramps: a step can arrive at its value over a duration with easing
    A step may carry dur_ms and ease (linear/in/out/inout): "arrive at
    value at t_ms, having started dur_ms earlier from the channel's current
    value" - the Timeline's line between two keyframes, as software-plan §6
    decided (ramps native on the node, never 50 keyframes over the mesh).
    pm_ramp.h interpolates at 50 Hz, anchored to the sequence clock, so a
    late cue lands mid-line and every node is on the same point of its line
    at the same mesh time. Servos, LED dimmers and motors ramp; a ramp
    takes over from servo smoothing while it runs; a direct set cancels it.
    Player fires a step at its start (t - dur); steps sort by start.
    Valid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
2026-10-06 Timeline editor: keyframes per output, ramps as lines, scrub, playhead
    The Cues view now shows a sequence's steps as a timeline above the step
    list: time across, value up, one track per output. A step is a
    keyframe; its dur_ms/ease is the line leading into it (eased curve) or
    a hold-then-jump. Drag a key to move it (snaps 50 ms / 1 %; live
    preview moves the servo), double-click a track to add one (rampable
    tracks get a ramp from the previous key), click a line to switch
    ramp <-> jump, Delete removes, drag the ruler to scrub every output,
    Play runs a playhead. Selection is shared with the step list.
    lib/timeline.ts is the model (tracks, eased valueAt, constraint-keeping
    moveKey/addKey/toggle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
2026-10-06 Timeline: zoom and horizontal scroll
    - − / + / Fit buttons; ⌘/ctrl + wheel zooms around the pointer
    (4-2000 px/s). Fit (the default) shows the whole sequence.
    - Sideways wheel (trackpad) or shift + wheel pans; a scrollbar under
    the tracks, draggable or click-to-jump; dragging a key past the right
    edge scrolls the view with it.
    - Track labels stay fixed while the plot scrolls (lines clipped at the
    label column); ruler ticks adapt to the zoom (100 ms ... 1 min) and
    show m:ss past a minute. The visible range is shown by the buttons.
    - Scrollable span is the sequence plus half a screen, for adding keys
    beyond the current end.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
2026-10-06 Ramps: adjustable ease in / ease out amounts; timeline keeps its zoom
    Easing is now two amounts per ramp: ease_in % of the ramp spent
    speeding up, ease_out % slowing down, a steady cruise between (a
    trapezoidal velocity profile, in + out <= 100). 0/0 is linear and
    50/50, 100/0, 0/100 reproduce the earlier named quadratics exactly
    (host test), so stored shows keep their shape; the old 6-element
    [..., dur, "name"] step is still read. New wire form: 7 elements,
    [t, kind, index, value, dur, ease_in, ease_out].
    Console: preset picker (ease in & out, gentle, linear, ease in, ease
    out, soft landing) plus the two percentages; raising one past 100 total
    lowers the other. The timeline draws the same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
2026-10-07 BRMesh BLE flood lights as a pin-less output on generic boards
    New channel kind BLE_LIGHT: no pin; config `light` = the light's number
    in the BRMesh app; value 0xRRGGBB (0 = off). Node config gains
    `brmesh_key` (8 hex digits from the BRMesh app, kept on the board only).
    Validator: key required, light numbers 1-255 and unique per board.
    - pm_brmesh.h: the fastcon advertisement encoder, ported from
    reference/brmesh-to-mqtt without its mallocs; host tests compare it
    byte-for-byte with the reference code.
    - pm_ble_tx.cpp: no Bluetooth host stack — drives the BLE controller
    over VHCI with three HCI commands, BLE-only mode, btInUse() kept true
    so the core doesn't free the controller mem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
2026-10-07 BRMesh lights: find and pair from the console, no app or key needed
    The node scans for unpaired floods over raw HCI (50 % duty so ESP-NOW
    keeps answering), sends the wake + add-device frames with the default
    key, and confirms when the light's advert carries our key. The board
    generates its key on first pairing and saves it before pairing, so a
    reset never loses a pairing. Paired lights are added as BLE_LIGHT
    channels automatically. Console: Find lights… panel; simulated mesh
    answers with two fake lights.
2026-10-07 BRMesh pairing works on real floods: identity by advert data, no ack wait
    Bench session with three Melpo RGBW floods found three things the first
    cut got wrong. Lights share one placeholder Bluetooth address
    (11:22:33:44:55:66), so keying the found-list on the address merged every
    light into one entry; they are now identified by the key-independent part
    of their manufacturer data. Paired lights never announce themselves again,
    so no pairing ever "confirmed" — a pairing now counts once its add-device
    burst has gone out (3 of 3 took and answered colours), and the light
    number advances. And the old confirm accepted any light on the shared
    address with a non-default key, which is how an app-pa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
2026-10-07 Floods: white mode, colour fades, 100 ms bursts; frame layout decoded
    Bench with three Melpo RGBW floods. White is a mode: bytes 6-7 both 127
    with the level in the brightness byte; partial values do nothing and a
    frame mixing RGB and white is rejected, so values are 0xWWRRGGBB with W
    1-127 meaning "white at this level" and the picker's white slider replaces
    the colour. Colour ramps are now real: per-component interpolation in
    pm_ramp, strips and floods allowed to ramp, and raw_out gained the two
    missing cases (a fade computed perfectly and sent nothing). Bursts of
    100 ms are still caught every time, 60 ms is not, so 100 is the default.
    The "command byte" is type 2 | length<<4; the header nib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
2026-10-07 Floods tab: BRMesh lights belong to the mesh, sent by every ticked board
    The lights were bound to one board only because that is where the key and
    channel list were stored. Now the console keeps a floods set — key plus
    lights — and writes it to every board ticked as a sender (same key, same
    BLE_LIGHT channels with index = light number), so any of them can drive
    the lights and losing one loses nothing. Pair from any sender; the result
    is copied to the rest. In Cues the floods are one pseudo-node: flood steps
    load once (each sender's copy collapsed), save into every sender's part,
    and live sliders fan out. A board's own page just points at the tab.
    Tested end to end on the simulated mesh (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
2026-10-07 Firmware updates over the air: boards pull the image over WiFi
    The console's new Firmware panel sends each board `ota {url, ssid, pass}`
    over the mesh; the board joins that WiFi, HTTPUpdates firmware.bin from
    tools/ota_serve.py on the laptop into the spare app slot, reboots and
    comes back on the mesh channel. Credentials are used once and kept only
    in the browser. A new image is marked valid only after 20 s with the
    mesh up (verifyRollbackLater + esp_ota_mark_app_valid), so a crashing
    one rolls back. Builds are stamped with their git commit (build_id.py,
    version.json) and hello reports it; the console re-asks a board who it
    is whenever its uptime drops, so an updated board shows its new buil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
2026-10-07 Firmware updates over the mesh: image streamed through the bridge
    Colin's principle, now recorded: nodes live in props out of WiFi reach,
    so updates must travel the mesh; the WiFi pull stays as a bonus. The
    console streams the image as base64 chunks (2700 image bytes per request,
    inside the 4320-byte mesh and 4096-byte serial limits); the board answers
    each with the bytes written so a lost request resumes, checks the SHA-256
    before committing to the spare slot, acknowledges, then reboots. The
    Firmware panel defaults to "Over the mesh" with a progress bar and stop.
2026-10-07 Serial at 921600: the cable was the slow half of a mesh firmware update
    A 1.28 MB image is 1.75 MB of base64 on the wire — ~150 s at 115200,
    more than the mesh transfer itself. Boards now talk at 921600
    (PM_SERIAL_BAUD); the console tries that first and falls back to 115200
    for boards not yet updated.
2026-10-07 Doc: WiFi bridge decision — the mesh follows the bridge's channel
2026-10-07 Firmware panel: say why a pre-mesh-update board refuses, and what to do
2026-10-07 WiFi bridge, stage A: the bridge joins home WiFi and the mesh follows it
    The bridge's config gains the home WiFi (password written, never read
    back); it joins as a station, keeps ESP-NOW running on whatever channel
    the router chose (broadcast peer on channel 0 = current), and announces
    propmesh.local over mDNS. Heartbeats now carry the sender's channel. A
    plain node that hasn't heard a bridge for 30 s scans channels 1-13 for
    one, moves, and remembers the channel for its next boot; nothing found
    means the bridge is off, so it goes back and retries in two minutes. The
    console shows the mesh channel and the bridge's address, and the bridge's
    page has the WiFi fields. mesh_channel {ch} forces a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
2026-10-08 Doc: stage A verified on the bench; firmware panel no longer claims the console disconnects
2026-10-08 WiFi bridge, stage B: the console reaches the bridge over WebSocket
    A small hand-rolled WebSocket server on the bridge (port 81, two clients,
    4 kB messages, heap buffers — static RAM is full) speaks the same JSON
    lines as USB; replies and events go to the cable and to every connected
    console. mDNS: propmesh.local. The console gets "Connect over WiFi" with
    a remembered address; WsLink and SerialLink share one line-protocol base.
2026-10-08 OTA: a failed transfer no longer blocks the next one; show store on the heap
    A mesh transfer that died midway left the shared state at DOWNLOADING,
    which both start checks read as "a WiFi update is running" — refused
    until the board was rebooted. The WiFi task now has its own busy flag; a
    new mesh update replaces an unfinished one; a transfer silent for 60 s is
    dropped; and the console sends ota_abort whenever it gives up.
    Also: the show store (31 kB, a quarter of the ESP32's ~124 kB static
    data limit) moves to the heap. Every feature added yesterday tipped the
    link over by a few bytes; static use is now 93 kB. Same total memory.
2026-10-08 Firmware panel: clear a stuck older board with ota_abort and retry, no power cycle
2026-10-08 Bridge WiFi: retry on a schedule so a missing router doesn't wreck the mesh
    A station trying to join scans every channel on the radio the mesh uses;
    the core's auto-reconnect did that back to back while the router was out
    of reach, and a mesh firmware update to Prop failed with "no reply".
    Auto-reconnect is off; the bridge makes one attempt at a time, starting
    on the mesh's channel, with pauses growing from 15 s to 2 min. Why it
    isn't on WiFi is now reported in plain words and shown in the console
    header. Mesh updates also wait out longer gaps (20 misses, 0.5 s apart).
2026-10-08 Bridge WiFi password survives a reboot; radio returns to the mesh after a failed join
    The same serializer wrote the config for the console (pass_set only) and
    to the board's flash, so the password never reached the file: the bridge
    lost its WiFi at its first reboot, then scanned for the router forever
    and starved the mesh. The store now writes it; the console still never
    receives it (host test added). A failed join also left the radio on the
    scan's last channel (14); it now goes back to the mesh's.
2026-10-08 WebSocket handshake accepts real keys; nodes move to the bridge's channel
    The handshake's bounds check allowed 23 key characters and every key is
    24, so no browser could connect; verified now against the real bridge
    (hello 19 ms, Prop via WiFi and mesh 10/10 at 67 ms). Bridge heartbeats
    already carried the channel, but nodes only acted on silence: at bench
    range neighbouring channels overlap, so Prop on 10 heard the bridge on 11
    and never moved. A node now moves to the announced channel; a bridge
    between WiFi attempts announces 0 so nobody follows a scan.
2026-10-08 Floods tab: sliders start at what the boards last sent, not dark red
    The lights can't be asked (BRMesh is one-way), but each sending board
    remembers the colour it last sent; the tab reads that on load, so the
    sliders match the light and moving one no longer jumps it.
2026-10-08 Floods: boards save the last colour sent to each light; honest notice in the console
    The lights keep their colour through a power cut, so the boards now do
    too: each sender writes /lights.json (at most every 10 s, only when a
    colour changed), restores it after every config apply including boot,
    and never re-sends it. The Floods page now says plainly that the lights
    never answer and can drift out of step if they miss a command or are set
    from the BRMesh app.
2026-10-08 Bridge page: WiFi shows as a status line with Change..., not an empty password box
    The board keeps the password and never sends it back, so the field was
    always empty and read as 'fill me in again'. Set up: network name, live
    status and Change...; fields only while changing, with Forget and Cancel.
    The simulator now stores the password the way the board does.
2026-10-08 Yard: floods on the topology and the map, in their last-sent color
    Their own glyph (glow in the color, warm white for white mode, dashed
    ring when off) with dotted lines to every sending board; a row under the
    boards in Topology, draggable on the Map like boards. Colors poll every
    3 s from a sender, so cues show live. Clicking one opens a small panel
    linking to the Floods tab.
2026-10-09 Mesh clock: the conductor never goes stale and direct followers aren't conductors; task watchdog
    Two clock bugs. A conductor stamped its clock once and considered it
    stale 20 s later, so a cue fired from the console through the bridge
    carried no mesh time and every board started it on arrival instead of
    together. And "conductor" was tracked as hop == 0, which a follower
    hearing the bridge directly is too, so Prop and Heads sent their own
    time beacons. PmClock now has an explicit self flag. Tests for both.
    Also: the task watchdog now watches loop() (30 s, reboot with the hung
    task named), so a hung board rejoins the mesh instead of staying silent
    until someone walks over — a bridge did exa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
2026-10-11 Pro v0.1 pours: 10 zones with 0/45/90 outlines; neck-down and pre-defined sizes check
    - tools/makezones.py builds every zone from the board as placed: In1 GND,
    In2 split VIN_PROT / +5V / +3V3 traced on a 2 mm grid with straight and
    45-degree edges only (38-63 corners per region, was 200-380 curved),
    pads the coarse grid lost flipped back, F.Cu GND + 10 A input pours,
    B.Cu GND under the DRV8871s, U.FL keep-out; writes zones-In2-split.png
    from the installed zones. Hand-renamed zones are left alone.
    - Colin's hand-simplified In2 regions; layout.md A22 lists what each
    region must enclose and the fix-ups, by net name.
    - layout.md: wide track into a small pad (neck-down) recipe; A21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
2026-10-11 Show schedule (dusk arming, quiet hours), modes, and update/console state fixes
    Schedule (software-plan 4.1, generic-boards 6e):
    - Modes off / ambient / armed. Windows of HH:MM or sun times with an
    offset ("sunset-60", "dusk+15"), days and month-day dates; later rows
    win; outside every window = off. Sun times from NOAA equations on each
    board (pm_sun.h), within 2 min of the astral reference at 5 places.
    - Wall clock per board as an offset from its own timer: set by the
    console on connect, carried in the TIME beacon (old 14-byte beacons
    still read), SNTP on a bridge with WiFi. 60 s wait for a clock at boot.
    - Manual mode holds until the next change (more-active capped at
    manual_ma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
2026-10-11 OTA over WiFi: download task under the watchdog, progress and free heap every 10 %
    Prop hung mid-download on 2026-10-11 and nothing recorded why; a stall
    now reboots the board within 30 s and the serial log shows where it
    stopped and whether memory ran out.
2026-10-11 OTA over WiFi: a failed join no longer kills the mesh radio
    The failure path turned the WiFi driver off and on to get back to the
    mesh channel; that silently deleted the ESP-NOW registration, so every
    mesh send failed ("esp now not init") until a power cycle — Prop's "never
    came back" on 2026-10-11 (its log shows the moment, 27 s after Update).
    Now it drops the AP only and re-registers ESP-NOW (pm_mesh_recover), the
    join waits 30 s, and the failure is logged with the WiFi status.
2026-10-11 Firmware panel: a same-build update counts as done when the board's uptime restarts
2026-10-11 Adafruit HUZZAH32 board profile; battery sense in heartbeats; "On battery" = leaf
    A board profile for the ESP32 Feather (LiPo input, charger, VBAT/2 on
    GPIO 35) as the stand-in for the Mini's battery story; profiles may
    declare a battery sense pin and the heartbeat reports the voltage. Every
    board gets a power setting: on battery it is a leaf (never relays or
    keeps the clock), so the mesh never depends on it. Sleeping between
    triggers is the next stage (docs 6f).
2026-10-11 WebSocket server: evict the quietest client when full, ping, never block the loop
    With both client slots held by stale connections (a console reloaded
    without a close), a new console was reset at the handshake and the
    bridge was locked out of its own console (2026-10-11). Now the quietest
    client is dropped for a newcomer, open clients are pinged every 20 s so
    dead ones fail fast, and sends skip a client whose socket can't take the
    frame instead of blocking the main loop — the strongest suspect for the
    two bridge freezes.
2026-10-11 Doc: battery sleep design — wake for the schedule and check-ins; relay while awake
2026-10-11 Doc: two-tier battery sleep — rhythmic listening in show windows, deep sleep when off
2026-10-11 Battery sleep, stage 1: deep sleep when the show is off, sensor/timer/schedule wake
    On a battery board with the show off, after a 15 s dwell with nothing
    holding it awake: deep sleep until any DIGITAL_IN pin (sensor or button,
    RTC pins), the check-in timer (console-set, minutes), or 5 s before the
    next schedule window. The wall clock rides through sleep on the RTC
    (settimeofday / RTC_DATA tz); a sensor wake runs that input's triggers
    and holds the board 60 s; any console request holds it 10 min
    (hold_awake, min 0 releases). The show tier (modem-sleep listen window)
    is wired but not yet driven by senders. Builds: the Feather has no
    Bluetooth (floods) and sleeps; the DevKit keeps Bluetooth and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
2026-10-11 Battery sleep, stage 2: the mesh talks to a board that listens in windows
    A battery board in its show tier (modem sleep: the radio listens
    window_ms of every interval_ms) advertises listen_ms in its heartbeat.
    Senders adapt: cues get a lead of one interval and are repeated every
    100 ms across it (fresh seqs, cue_id dedup); the conductor beacons every
    interval instead of every 5 s; the leaf tolerates 60 s between beacons.
    A console request to such a board is queued behind a hold_awake burst
    and released the moment the board answers (it then listens continuously
    for 10 min). Bench, Feather at 100 ms / 1000 ms: 4 of 4 cues received at
    every window tried; a request answered in 0.8 s.
    Co-Authore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
2026-10-11 Doc: battery sleep stages 1-2 bench results
2026-10-11 Battery boards in the console: asleep / listening / voltage on the roster and Yard; wake-pin rule
    A sensor on a pin that can't wake the ESP32 from deep sleep gets a
    warning on a battery board (both validators). Heartbeat events carry the
    listen interval; the roster shows ☾ asleep (not red) for a quiet battery
    board and ☾ <ms> while it listens in windows, plus its voltage.
2026-10-11 Firmware server serves every board's image; the panel picks each board's own
2026-10-11 Battery boards: console polls don't hold them awake; bridge beacons count as presence
    Two things kept the Feather from sleeping and then sent it off-channel.
    Every request held a board awake 10 min, including the console's
    background polls, so a battery board never got to sleep with a console
    open; now hello / mesh / state / ota_status don't hold. And a board
    listening in windows heard a bridge heartbeat only about once in ten,
    so the lost-bridge check fired and it scanned (landing on channel 10);
    the bridge's 1 s time beacons now count as presence and the check waits
    the sync tolerance. Leaving window mode resets the window to the whole
    interval before turning power save off.
    Co-Authored-B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
2026-10-11 Nodes follow the bridge's channel again; sleep check-in in milliseconds; shorter dwell
    The announced channel was read as "the last byte of the heartbeat",
    which stopped being the channel when listen_ms was appended today, so
    Prop and the Feather sat on channel 10 hearing the bridge say 11. Read
    by field now. The off-tier check-in is checkin_ms like the other two
    sleep settings (Colin), and the awake dwell after a timer wake is 6 s
    (15 s every minute averaged ~25 mA).
2026-10-12 Doc: battery sleep fixes of the day and the published power budget
2026-10-12 ESP32-C6 SuperMini board profile and build; wake pins come from the profile
    - boards/esp32-c6-supermini.yaml (BoardType C6_SUPERMINI), env
    esp32-c6-supermini on the lantern test's esp32-c6-devkitm-1 board, native
    USB CDC on boot, PM_NO_BLE (the C6 libs have no VHCI — NimBLE port later).
    - New `wake` pin capability replaces the hardcoded ESP32 RTC-pin list in
    pm_pinrules.h, pm_sleep.cpp and pinRules.ts; the console warning lists the
    board's own wake pins.
    - ESP32-only BLE controller mode field and ext1 ALL_LOW guarded by target.
    - ota_serve.py serves the C6 image too. Docs §6g.
2026-10-12 Bluetooth floods on the ESP32-C6 through NimBLE
    The C6's prebuilt libs have no VHCI, but ship NimBLE with legacy
    advertising and scanning. pm_ble_tx now has two radio backends for the same
    five jobs (advert data, 20 ms non-connectable advertising, duty-cycled
    active scan, adverts heard, per-call status); the ESP32 keeps its
    bench-proven HCI path. Pairing and burst logic stay shared. The C6 env
    drops PM_NO_BLE. Docs §6g.
2026-10-12 Doc: C6 sleep options — same tiers, prebuilt SDK is the limit; board floor notes
2026-10-12 Battery boards send to floods when awake; console says which boards can't
    - hello carries `ble` (false on the PM_NO_BLE HUZZAH32 build, where the
    ESP32 can't fit Bluetooth beside deep sleep).
    - Floods tab: senders tagged ON BATTERY / NO BLUETOOTH; a no-Bluetooth board
    can be unticked but not ticked and isn't offered for searching; a note
    explains the battery lag (up to one listen interval, nothing while asleep)
    and warns when no mains board is ticked. Search defaults to a mains board.
    - A battery board finishes a queued flood burst before deep sleep.
    - Doc: corrected the 'battery boards don't drive floods' assumption; Feather
    CP2104 never suspends (~6.5 mA on battery), D- pull-down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
2026-10-12 Console asks before a flood sender goes on battery (and before ticking a battery board); PM_NO_STRIP guard; Feather D- pull-down note
    - Confirm popup (ui.tsx) in the pin editor's On battery toggle when the board
    holds the floods key, and in the Floods tab when ticking a board that is on
    battery: explains the listen-window lag and the off-tier silence, and
    whether a mains board still covers the lights.
    - pm_channels: WS2812 strip driver behind #ifndef PM_NO_STRIP. Measured: the
    Feather with Bluetooth + deep sleep overflows IRAM by 104 bytes; without the
    strip driver (RMT) it links. Not enabled by default — Colin's call.
    - boards/esp32-huzzah32.yaml: the CP2104 never suspends on ba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
2026-10-12 WS2812 on the IDF RMT driver directly; every ESP32 build gets Bluetooth AND deep sleep
    Audit of the 104-byte IRAM overflow: nothing of ours is in IRAM; the one
    elective piece was Adafruit_NeoPixel's path through esp32-hal-rmt.c, which
    links the RMT receive driver, a copy encoder and carrier code strips never
    use. pm_ws2812 uses rmt_tx + a bytes encoder (hardware timing). NeoPixel
    dropped from lib_deps; PM_NO_SLEEP (DevKit) and PM_NO_BLE (Feather) removed
    from the envs, kept as escape hatches. Console/doc wording updated.
2026-10-12 Clocked SK9822/APA102 strips and the Fire2023 effect, editable in the console
    - SPI_STRIP function (DATA + CLOCK, bit-banged pm_apa102); strips share a
    PmPixels interface with color order (grb/rgb/bgr).
    - Strip effect solid|fire: pm_fire ports Fire2023 (the lantern prop) with
    every constant as a PmFireCfg field — columns/height/zigzag, brightness,
    speed, flame, noise, smoke speed/dimmer/scale — lantern values default.
    FastLED 3.10.3 pinned for its noise/palette math only (no IRAM cost).
    - A fire strip's value is a switch (0 out, else burning), so cues, ramps and
    restore work unchanged; editor Test shows Burn/Out; FIRE knob row with
    tooltips; fire_matrix validation on both sid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
2026-10-12 Console: pinout drawing per board from the profile, with the node's assignments on the pads
    boards/*.yaml gain header (left/right pin order, USB end) and pinout_url;
    genboards emits them to TS and checks every usable GPIO is drawn. New
    Pinout panel in the editor (SVG, collapsible, click-to-jump, vendor link);
    boards without a fixed header (C6 SuperMini) get a GPIO list. Docs §6i.
2026-10-12 Mesh: count send errors, detect 'heard but not heard', self-heal; last words saved to flash
    Prop heard the bridge and Feather for hours while neither heard it, and the
    bridge dropped off WiFi; a reboot erased both stories. Now:
    - pm_mesh counts esp_now_send failures (tx_err, last_tx_err) and reports how
    long mains neighbors with room in their lists have not listed us
    (unheard_s). main restarts ESP-NOW after 2 min unheard, reboots after 2
    more (max 3 in a row, RTC counter).
    - pm_lastwords keeps WiFi lost/back and mute events in /last.json; boot
    event and hello report the previous record; the console's node editor
    shows Last restart and Before that.
    Flashed to bridge, Prop and Feathe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
2026-10-12 Licensing: GPL-3.0 firmware, AGPL-3.0 console, CERN-OHL-S-2.0 hardware, CC BY-SA 4.0 docs
    - LICENSING.md (what applies where, and why copyleft), THIRD_PARTY.md
    (FastLED MIT notice for the Fire2023 port; BRMesh reverse-engineering
    credits), TRADEMARK.md, CONTRIBUTING.md (PRs to dev, DCO, relicensing
    grant), README / hardware-spec §6 / CLAUDE.md updated.
    - pm_brmesh: the BRMesh projects carry no license, so their code is out —
    CRC is a plain CRC-16/CCITT, whitening the Bluetooth spec LFSR (matches
    theirs on 2000 random frames); tests compare against advert bytes
    recorded from their implementation instead of embedding it.
    - .github/workflows/main-from-dev.yml: PRs into main must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
2026-10-12 The show follows the conductor: edit stamps, newest wins, pull and push
    Every mesh-wide document carries the UTC second it was edited (the
    console's clock): schedule, the mode held by hand (STOP ALL), each board's
    sequences and triggers, the floods key and lights. The conductor beacons
    its stamps every second (schema Time); a board that is behind pulls the
    newer copy from it, a board that is ahead pushes it. Every set_* handler
    ignores an edit older than what it holds, so nothing can undo a newer one.
    - pm_sync: follower loop (mode straight from the beacon; get_schedule,
    pull_floods, pull_index/pull_seq/pull_rules from a bridge), push-back of
    a newer mode or schedule, battery boards hel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
2026-10-12 pm_sync: request buffer on the heap (static 4 KB boot-looped the ESP32 builds); docs §6k
    The bridge failed 'assert vApplicationGetTimerTaskMemory' at boot: static
    RAM went 95.4 -> 100 KB and FreeRTOS had no heap left for its timer task.
    Bench results for the sync recorded in docs §6k.
2026-10-12 Console: an edit for a board that's away is saved, not failed — and the console says when it catches up
    Bench (Colin, 2026-10-12): with Prop unplugged, saving a sequence said
    'Not saved on Prop (no reply)'. The bridge had kept the copy and Prop
    pulled it within seconds of coming back, but the console never said so.
    - saveSequence/deleteSequence/saveRules: through a bridge, a board that
    doesn't answer is 'queued' (the bridge holds the edit), and a board that
    isn't on the mesh at all is still written through the bridge so it gets a
    copy. Only refusals and no-bridge timeouts are failures.
    - Show view: 'Saved. Prop is off the mesh — the bridge kept a copy and it
    picks it up when back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
2026-10-12 Console: a board that's away is shown from the bridge's copy, not dropped from the show
    Colin's retest (2026-10-12): after a save with Prop unplugged the reload
    dropped Prop's part — the sequence showed 'unsaved', its steps '(gone) /
    not on this board', and the old red 'No answer from Prop' replaced the
    'bridge kept a copy' message.
    - loadShow: a board that doesn't answer keeps its channels from the last
    load and gets its sequences and triggers from the bridge's copy
    (pull_index / pull_seq / pull_rules); listed as fromBridge, not
    unreachable. Saves still target it (through the bridge).
    - The reload no longer overwrites a save's own message with the softer
    'off the mesh — showing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
2026-10-12 Plan: PCB after Halloween, software freeze dropped; console sections Sequences / Show; React Flow first
2026-10-12 Console: Sequences and Show sections replace Cues / Show Graph
    Sequences = the Timeline editor (orchestrate predefined sequences of
    outputs). Show = the trigger list (the graph's row view), the schedule,
    the mode buttons and the activity log. One ShowView with a section prop
    over the same board data. ?view=cues still deep-links to Sequences.
    README and generic-boards references updated.
2026-10-12 Trigger rules v2: after-triggers, delay, lockout, fan-out, random pick — firmware, console rows, sim
    trigger → logic → actions, evaluated on the board that holds the rule:
    - trigger: sensor edge, or a sequence starting anywhere ("after" — a
    chain; delay = its length means "when it ends")
    - logic: delay, cooldown, lockout (at most N fires per window)
    - actions: 1–4 sequences, all or one at random; several rules may share a
    trigger (fan-out)
    PmTriggers: arm / due / pick, host-tested (delay+fan-out, random+lockout,
    chaining, JSON round trip, self-loop refused). JSON keeps reading the
    one-sequence form. set_rules buffer moved to the heap (static RAM 95.6 KB).
    Console: Rule v2 + nor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
2026-10-12 pm_show: allocate the show store in begin(), not a static initializer — boot loop on every ESP32 build
    Global constructors run before FreeRTOS starts, from what's left of the
    static-data region; a 31 KB new PmShow() there left the scheduler no
    room for its timer task once PmRule grew (assert
    vApplicationGetTimerTaskMemory, the second time today). Memory rules
    written into CLAUDE.md. Chain test on hardware: an 'after sequence 1 +
    3 s' rule on Prop fired sequence 2 at 3.07 s.
2026-10-12 Show Graph on React Flow: chains of blocks compile to trigger rules, rules decompile to chains
    - lib/graph.ts: our own model (blocks, wires), compile(graph) → rules
    (paths trigger → logic → action; same-logic paths collapse into one
    rule's seqs; delay sums, cooldown max, lockout, random pick; "after X
    ends" = after X + X's length) and decompile(rules) → chains with stable
    ids so saved positions survive a reload.
    - views/show/GraphEditor.tsx: palette, cards with inline params, wires,
    UNWIRED badge, live highlight from activity (sensor fired / sequence
    playing), minimap and controls in our tokens; positions in localStorage.
    - Show section: Graph / List toggle over the same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
2026-10-12 Show Graph: drag blocks from the palette; ▶ sim runs a chain for real; unsaved trigger edits survive a reload
    - Palette items are draggable onto the canvas (click still works); the
    block lands under the cursor.
    - ▶ sim on a wired trigger walks its chain as the board would: lights each
    block, honours delays, picks one sequence at a Random pick, then plays
    the sequences through the console's cue; a SIM banner narrates. Cooldown
    and lockout are shown, not enforced.
    - A reload (mode change, a board catching up) no longer wipes unsaved
    trigger edits — rows or graph — the way an unsaved sequence was already
    protected.
    Checked against the boards: Sensor → Play chain simulated,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
2026-10-12 Sequences: a new sequence starts blank, with "Add first track…"
    A new sequence was pre-populated with whatever output happened to be
    first on the first board (Prop's LED) — never the one wanted (Colin,
    2026-10-12). Now it starts with no steps; the Timeline shows "No tracks
    yet" with a prominent "+ Add first track…" picker; the toolbar's
    "+ Add track…" appears once there is one.
2026-10-12 Yard Map: drawing tools (areas, paths, lines) and a shared map document on the bridge
    Handoff 1e "Blueprint", ahead of the v2 plan:
    - Blueprint.tsx: tool rail — Select (drag boards/shapes, drag corners),
    Area (close on the first corner), Path (width presets in feet), Line
    (dashed), Erase, Undo (⌘Z); Enter/Esc/Delete; snap to a quarter
    square; grid with a feet-per-square scale; selected-shape panel with
    label, width, Remove; save status.
    - lib/yardMap.ts: one map document — shapes + where every board and flood
    sits — kept on the board the console connects to, newest edit wins;
    the browser keeps a copy and old browser-only positions are folded in.
    Whole-number coords, fla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
2026-10-12 Yard Map: zoom and pan, one aligned grid, area colors, grabbable edges, midpoint corners, clearer tools
    From Colin's review of the drawing tools (2026-10-12):
    - Zoom with the scroll wheel around the pointer, pan by dragging empty
    ground (Select tool), +/−/fit buttons — like the Show Graph. The map's
    edge is drawn so you know where the stored area ends.
    - The grid never lined up with the canvas dots: the dots were a CSS
    background in screen pixels under an SVG grid in map units. In Map mode
    the SVG draws the only grid (dots at every square's corner, a faint line
    every five) and the CSS dots are off.
    - Area colors: eight muted swatches (stone, grass, soil, water…) on the
    shap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
2026-10-12 Yard Map: unbounded canvas, clip-art props, and a board can be drawn as one
    - The grid now covers whatever is in view: pan or zoom anywhere, fit
    on first load (and the fit button) frames every shape and board.
    - Prop tool: a palette of Halloween clip art (tombstone, skeleton,
    spider, ...) placed on the map as markers in three sizes, with a
    label and color; erase, undo and the shape panel work on them.
    - A board's detail panel has "DRAWN AS": pick clip art and the node
    is drawn as that on the map (stored in the shared map document).
    - Double-click a corner to remove it (hint in the shape panel).
2026-10-12 Yard Map: colored clip art, one toolbar row, hideable "not on the map" bar
    - Props on the map (and the palette, and a board's DRAWN AS picker)
    are now flat-color stickers: gray tombstone, orange pumpkin, white
    ghost, purple bat... Node glyphs elsewhere stay monochrome. A prop's
    color swatches are gone since the art carries its own colors.
    - The Mesh links toggle and the unplaced-boards bar share one row at
    the top; the tool rail sits below it, and the palette floats above
    the bar. Nothing overlaps.
    - "hide ✕" collapses the unplaced bar to a "N not on the map ▸" chip
    (remembered per browser).
    - Fit leaves headroom under the toolbar row.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
2026-10-12 Yard Map: place props and draw on top of existing areas
    A click on any drawn shape went to that shape's own handler, which
    only acts for Select and Erase and swallowed everything else — so the
    Prop tool could only place on bare ground, and an area or walkway
    couldn't start inside another area. While placing or drawing, a click
    on a shape now counts as a click on the ground under it, and a
    double-click on an area's edge finishes a drawing instead of being
    taken as "add a corner".
    The placement preview also cleared only on the next move over the
    map, so it stayed drawn where the pointer left (looked like a prop
    that wouldn't go away); it now clears when the pointer leaves.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
2026-10-13 Docs site: Starlight user docs, browser flasher, hosted console; console delivery decided
    Where the console runs (software-plan §6): one React console, three
    shells — bridge-served (offline, any phone), the hosted site (USB via
    Web Serial + the simulator), and later a native app. A hosted page over
    HTTPS can't open ws:// to a LAN board, so hosted-only would fail on a
    phone in the yard. The JSON API gets a written, versioned spec before
    any native app; the bridge-served build's size is a partition question
    (recommend a 16 MB ESP32-S3 bridge), not a reason to drop it.
    website/ (Astro Starlight, published to GitHub Pages from main by
    .github/workflows/site.yml):
    - Start here: what it is, tr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
2026-10-13 Docs: beta notice, "more boards coming" and a board-request issue form
    - Home page banner and a closing line: PropMesh is in active
    development and in beta, your mileage may vary; "What is PropMesh?"
    gets an "It's in beta" section (what that means, test before the big
    night, report issues), and the installer page a beta-firmware note.
    - Choosing a board: "More boards are coming" with a link to request one.
    - .github/ISSUE_TEMPLATE/board-request.yml: board name, link/pinout,
    chip, what it's for, can you test — what a profile needs. Linked from
    the board list and Contribute. config.yml points people at the docs.
2026-10-13 Docs: say plainly how far each board has been tested
    boards/*.yaml gain `status` (tested / partial / untested) and
    `status_note`, shown on each board page, as a Status column on
    "Choosing a board", and beside the board in the installer's list.
    DevKit V1: tested (runs the project's yard). HUZZAH32: partly (battery
    sleep + floods in one build not bench-tested). C6 SuperMini: not yet
    flashed onto a real board. "It's in beta" now calls PropMesh a passion
    project, unfinished and open about it; the installer page says the
    in-browser installer is new too.
2026-10-13 Docs: a sneak peek at the PropMesh Pro and Mini
    "Choosing a board" gains "Coming later: PropMesh's own boards" — what
    each is for (Pro: 12–30 V, screw terminals, stepper sockets, servos,
    LEDs, relays, sound, protection on board; Mini: battery, sleeps,
    stores its own sounds), aiming for the 2027 season, same firmware and
    console, open designs. No part counts, prices or dates that could
    change. "What is PropMesh?" links to it.
2026-10-13 Handoff for moving software work to the home server
    docs/status.md: the one place that says where things stand — what runs
    on the yard boards, what's built but not on hardware, the seven bench
    tests waiting, open bugs and loose ends, what's not built (in order),
    and how to set up a new machine: clone, toolchains, reaching the boards
    over the network, USB, or the console through an SSH tunnel; what isn't
    in git (Claude's memory folder, reference/old_files with live
    credentials — never commit or sync it).
    CLAUDE.md: points at status.md first; "Firmware priorities" no longer
    says the October show runs painlessMesh; "Working with Colin" carries
    the working rules that lived only in Claude's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
2026-10-13 Docs site: audit pass — fix stale claims, rewrite in a plain voice
    Checked every page against the firmware, console labels and the design
    notes. Fixed: the no-schedule "Armed" behavior in the first-scare
    tutorial, battery-board cue timing, the manual-mode expiry rule, the
    update time (3.5 min since 921600 baud), the 30 V relay figure stated as
    a system limit, the no-clock fallback after a power cut, and the LED
    strip page now says the strip driver and fire effect have not run on a
    real strip. Rewrote all pages in shorter, plainer sentences; the voice
    rules are in website/README.md. Findings and loose ends:
    docs/site-audit-2026-10-13.md.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
2026-10-14 Update panel: load the latest release from the docs site by default
    "Over the mesh" gains Image: Latest release | My own build. Latest
    release (the default) loads <site>/firmware/<board>/firmware.bin and its
    version.json for the board the console is connected to as soon as the
    panel opens, and each other board type gets its own through the same
    folder layout (imageUrlFor) — no server to run, no URL to paste. My own
    build keeps the ota_serve.py URL and "from file".
    Over WiFi is unchanged: the boards fetch the image themselves over plain
    HTTP, which the HTTPS-only site can't serve, so it still needs
    ota_serve.py — now said on the panel.
    The site publishes firmware.bin + version.json per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
2026-10-14 ESP32-C3 SuperMini profile, and "versions of this board" notes
    New generic-board profile boards/esp32-c3-supermini.yaml (BoardType 5,
    env esp32-c3-supermini): 13 header pins, wake on GPIO 0-5, 6 LEDC / 2
    RMT budgets, native USB on 18/19 reserved. The C3 has no ext1, so
    pm_sleep.cpp switches on SOC_PM_SUPPORT_EXT1_WAKEUP and uses the GPIO
    deep-sleep wake path there (one polarity per call, so active-high and
    active-low inputs can both wake it). Builds: C3 1.56 MB / 81.8 KB static;
    DevKit and C6 unchanged. Not yet flashed — listed as untested.
    Board profiles gain `variants`: plain-text notes on the versions sellers
    ship (LEDs, antenna, charger pads, header order), validated by
    genboards.py,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
2026-10-14 Docs site: console screenshots on every feature page
    Seventeen screenshots of the console, taken from its simulator with a
    seeded show (three named boards, pins, sequences, a trigger chain, a
    drawn yard; a two-board seed for the tutorial) by
    website/scripts/shots/shoot.mjs (Playwright). `npm run shots` retakes
    them; website/README.md says how. Placed on the tutorial, Yard, Nodes,
    Floods, Sequences, Triggers, Running the show, Updating and
    Troubleshooting pages.
    Found by screenshot: the Firmware panel's "Latest release" option
    (a3a41bc) fetches <site>/firmware/<board>/firmware.bin + version.json,
    and the site never staged them (404 live). stage-firmware.mjs now
    publishes both; the Updating p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
2026-10-15 Design note: battery repeater (relay during the show, sleep outside it)
2026-10-15 Battery repeater: relay during the show, sleep outside it
    A battery board with "Relay for other boards while the show runs"
    (config sleep.relay) keeps the RELAY role, stays fully awake in the show
    tier instead of listening in windows, and reports listen_ms 0 so others
    treat it as a normal relay. The off tier is unchanged: deep sleep,
    check-ins, sensor wake, pre-window wake. hello carries relay: true.
    Console: the toggle under SLEEP with its cost and caveat; the simulator
    now gives battery boards the leaf/relay role the firmware does; the Yard
    finds boards that reach the bridge only through a battery repeater
    ("via battery relay" in the header and the detail panel). Site: "A
    battery board as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
2026-10-15 Design note: synchronized check-ins; the repeater can be bench-tested on USB power
2026-10-15 Battery boards check in on a shared UTC grid
    Sleeping battery boards now wake at the next whole multiple of their
    check-in period (UTC) instead of "a period after I fell asleep", so every
    board with the same period is awake at the same moment and a chain of
    battery repeaters passes messages end to end. Wakes come guard = 1 % of
    the period + 1 s early (internal RC sleep clock) and hold dwell + 2 x
    guard. No clock yet: the old rule. A schedule window that comes first
    still wins. One grid for every battery board (Colin).
    pm_checkin.h is pure and host-tested (3 cases). The console shows
    "next check-in HH:MM:SS" for a sleeping board from the same grid; the
    battery page explains it. Design: gener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
2026-10-15 Battery repeater runtime: about two weeks on 10,000 mAh, counting check-ins
2026-10-15 Battery check-ins end early, and boards correct their own sleep-clock drift
    Early release: the first heartbeat goes ~0.5 s after a wake instead of
    5 s, and a check-in ends once the bridge has been heard (+1.5 s for a
    sync pull to start). The old dwell + 2 x guard is now only the ceiling.
    A repeater still stays until slot + guard + 6 s so a board behind it
    can get through.
    Drift: the jump the RTC-carried wall clock takes at the first conductor
    beacon after a deep sleep, over the RTC's idea of how long it slept, is
    the sleep oscillator's error. Measured each wake, blended, kept in RTC
    memory, applied to the next sleep; once measured the guard drops from
    1 % to 0.3 % of the period + 1 s.
    hell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
2026-10-15 Docs site: make the GitHub link easy to find
    A labeled GitHub button in the header replaces Starlight's small icon
    (component override, src/components/SocialIcons.astro; icon-only on
    narrow screens). Also a "View on GitHub" button on the home page and a
    "PropMesh on GitHub" link at the end of the sidebar.
2026-10-15 README: bring it up to date, and say what has gone into the project
    Rewritten for what exists today: the generic-board firmware and console
    first, PropMesh's own boards as "in design", the Mini on the
    ESP32-S3-WROOM-1U-N16R2 with its allocation pending, no IR on the Pro,
    the real repository layout and tools, developer setup, adding a board,
    and docs/status.md as the place to start. New "How it got here": the
    2024-25 prototypes, the project's scope six weeks in, and bench results
    from the design notes (every figure checked against the repo).
2026-10-16 Candle output: flicker LED + flame coil, from the candle sketch
    New function CANDLE (ChannelKind 9) for a flameless candle with a swinging
    flame: LIGHT pin (LEDC 1 kHz 12-bit, gamma, optional on = LOW) and COIL
    pin (into the candle's transistor). Value 0-1000 is the flicker's
    brightness, 0 = out; it ramps like an LED dimmer, so sequences, triggers,
    the schedule and STOP ALL work unchanged.
    The flicker and coil pattern are ported from reference/candle_esp32.ino
    into a pure model (pm_candle_core.h): wander, shimmer, gusts and sputters
    at exponential intervals, and coil bursts at the flame's swing frequency
    that pump continuously during a gust. Each coil pulse is ended by an
    esp_timer, never t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
2026-10-16 C3/C6: never block on the USB serial port
    On native-USB chips Serial is the chip's own USB port. Plugged into a
    computer that isn't reading it, the Arduino core waits up to 20 x 100 ms
    per write; a few dozen log lines stalled the loop past the 30 s task
    watchdog, and the first real C6 rebooted every few minutes on a laptop
    (fine on a USB charger). Set a zero TX timeout and a 4 KB TX buffer on
    native-USB builds: unread output is dropped, a reading console still gets
    whole replies. Classic ESP32 builds (UART) are unchanged.
2026-10-16 Console: number fields you can type into
    Every <input type="number"> reformatted or clamped on each keystroke:
    typing 2.85 into swing gave 2.02, 18 into kick gave 48, 50 into the
    listen window gave 300, 600000 into check-in gave 3000000000.
    New NumberInput (ui.tsx): keeps exactly what you type while focused,
    applies it as soon as it's a valid number in range (live previews still
    follow), and clamps/tidies only on leaving the field or Enter. Out of
    range shows red until then. Plain text field with a numeric keypad on
    phones; no spinner arrows. Used for all 25 number fields: pin editor
    (candle, fire, servo, smoothing, pixels, sleep), sequence times and
    ramps, ambient loop period, trigger dela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
2026-10-16 Candle: find the flame's swing with steady kicks and a sweep
    Hunting the swing rate by editing and saving didn't work: the burst-and-
    rest pattern and the gusts hide what one rate does. The sketch had a
    "steady kick" key for this; now the model has tune(chz) — kick every
    cycle at that rate, no rests, no gust pumping — behind
    {"cmd":"candle","event":"tune","chz":N} (0 stops). The driver ends it
    after 2 min or on Out: the coil warms under steady kicks.
    Console: "Find the swing…" in the candle's test column. Sweep steps
    0.10 Hz every 2.5 s from 1.00 to 5.00 Hz and around; − / + nudge by
    0.05; "Use N Hz" writes the rate into the candle's settings; Stop, and
    leaving the page, end the kic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
2026-10-16 Candle finder: the kick width too
    The tune command takes an optional "ms": a trial kick width that rides
    along without saving. The finder gets a KICK row (− / + 2 ms) under the
    rate: at the found rate, shorten until the swing shrinks, then one step
    back up — the lightest push that still swings fully keeps the coil cool.
    "Use" writes both the rate and the kick into the settings.
2026-10-16 bridge.py ota: print each new error as it happens, not only on giving up
    A C6 transfer stopped at 99 % with 'no update in progress' — the board's
    answer to every chunk once it has dropped the session, which hid whatever
    closed it. Now the first reply that differs is printed with its offset.
2026-10-16 Candle finder: hold the LED steady while finding the swing
    With the flicker running it was impossible to tell whether the flame
    piece moved at all. While tuning, the LED holds 85 % of the set level;
    the brightness slider still scales it.
2026-10-16 Candle finder: the sweep actually sweeps
    The sweep timer restarted on every parent render (boards report in every
    second or two, and the callback prop was a fresh function each time), so
    it never reached its 2.5 s step. It now reads the latest values through a
    ref and depends only on whether the sweep is on. Checked in the
    simulator: 2.70 → 2.80 → 2.90 → 3.00 → 3.10 → 3.20 Hz over 13 s.
2026-10-16 Candle finder: sweep 0.5–6 Hz
2026-10-16 generic-boards §6n: first run on the candle — LED works, coil drive unproven
2026-10-16 Candle finder: Bursts — kick in sets with rests, at the tuned rate
    A centered magnet gets no sideways torque from a steady pull, and
    steady kicks at a slightly wrong rate can cancel themselves; the stock
    board kicks in sets with rests, which let a set catch the flame at a
    different phase. "burst": true on the tune command does the normal
    3-5-kick sets at the tuned rate and width; a Steady / Bursts button in
    the finder.
2026-10-17 generic-boards §6n: the candle's coil was fed through ~180 Ω — the removed charge pump's node
2026-10-17 generic-boards §6n: measured vs inferred on the candle's coil supply; fix that needs no guess
2026-10-17 generic-boards §6n: the candle's flame swings after the coil rewiring
2026-10-17 Candle: the wobble follows the flicker, and a ? that explains the settings
    At rest the coil kicks in irregular sets (2-6 kicks, each set at its own
    strength, rests shortened by drama, the odd lull); in a gust it pumps in
    phase and harder the deeper the gust, x1.15 in a sputter, capped at
    100 ms. Host test. The CANDLE row in the console gains a ? that explains
    every knob and links the candle page.
2026-10-17 Battery voltage from a resistor divider, with a LiPo percentage
    New BATTERY input (ChannelKind 10): one ADC pin and a divider ratio
    (default 2.0 for two equal resistors). Sampled 8x every 2 s; the reading
    feeds the heartbeat's battery_mv on boards without a sense pin of their
    own, so the roster and the Yard show it. Percent from a resting 1S
    lithium curve (pm_battery.h, mirrored in console/lib/battery.ts), shown
    as "3.87 V · 62 %" in the TEST column, the roster and the Yard. One per
    board; validator checks the pin reads analog and the ratio is 1-20.
    Host tests. Site: "Reading the battery on a board without a sense pin";
    the board pages say how. Not on hardware.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
2026-10-17 pm_channels: declare read_battery before attach() uses it
2026-10-17 Candle: keep the swing alive at rest, pump before and after a gust
    On the candle the first "follows the flicker" cut gave less motion and
    couldn't build momentum for a violent flicker: a pendulum needs several
    swings and the rests let it die. Now resting kicks keep coming at the
    rate in runs whose strength drifts 0.6-1.0x, with short pauses and one
    kick in ten skipped; and the coil pumps at full strength from 400 ms
    before a gust's dip (the gust is scheduled, so it's known) to 1.2 s
    after, so the swing peaks with the flicker.
2026-10-17 C6 SuperMini: partly tested; candle and battery divider confirmed on hardware
2026-10-17 status and design notes: candle and battery divider confirmed on the C6
2026-10-17 Battery input: the divider formula and a meter-based calibration helper in the console
    Type what the meter reads at the battery; the console works out the
    ratio that makes its reading agree and applies it with one press. The
    first real divider read 1 % low (resistor tolerance and the ADC).
2026-10-17 Candle drafts: candles in the same draft gust and sputter together
    A candle's `draft` (1-8, console A-H) puts it in a group whose gusts and
    sputters start in the same instant on every board, with the same depth,
    length and speed. No mesh message: each mesh second is a lottery decided
    by hash(draft, second) with the candle's own odds (1/gust_s per second),
    so every member reaches the same verdict from the shared clock, in or
    out of each other's radio range. Shimmer, wander and the coil's drifting
    strength stay individual. No conductor = back to local timers. Host
    test: two candles in a draft never disagree over an hour.
2026-10-18 Flash page: manual install-mode steps for native-USB boards (C3, C6)
    On these chips the USB port is part of the chip, so the browser installer
    can't reboot the board into install mode itself and reports "Failed to
    initialize"; a fresh board's factory demo reboots and the port flaps in
    the chooser. When such a board is selected, the flasher now shows the
    sequence that works: close anything holding the port, unplug, hold BOOT
    while plugging in, Install, pick the port that just appeared, press RESET
    after. Troubleshooting text updated to match.
2026-10-18 Flash page: a lit blue LED on a SuperMini means it booted its old program, not install mode
2026-10-18 Flash page: the lit LED on a failed SuperMini attempt is unexplained; keep the rule, drop the explanation
2026-10-18 C6 SuperMini: why BOOT-and-plug-in only sometimes enters install mode, and the jumper that fixes it
    ESP32-C6 datasheet §3.1: download boot needs GPIO8 = 1 and GPIO9 = 0 at
    reset, and GPIO8 floats by default. The SuperMini's schematic ties GPIO8
    only to the WS2812's data input, so holding BOOT works only when GPIO8
    happens to float high. A jumper from pin 8 to 3V3 during the plug-in (or
    a permanent 10 kΩ pull-up) makes it certain. The flash page's
    install-mode box and the troubleshooting entry say so; the design note
    has the datasheet and schematic references and the LED identities from
    the schematic (green = TP4054 charge LED, blue = GPIO15, active high).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
2026-10-18 Yard map: a candle, as clip art and as a board's picture
2026-10-18 Candle: OTA rolls back with a brownout — record it; bridge.py says so plainly
    Three transfers of this build finished and the candle came back on the
    previous image with reset reason brownout, dead within 3 s of its first
    boot. Recorded in generic-boards §6n with the test that separates a
    sagging supply from the restart path, and in status.md's bench list.
    tools/bridge.py ota now reads the build before the transfer and, when
    the board returns on the same one, says the image did not survive its
    first boot and rolled back, with the uptime and seconds since end.
    hello's outputs_on no longer counts a BATTERY input as an output on.
2026-10-18 Console: the battery reading re-reads every 5 s as meant, plus a read-now button
    The 5 s re-read in the pin editor was keyed on the node target, a fresh
    object on every parent render; heartbeats re-render the parent every
    second or two, so the timer was cleared before it ever fired. Seen in
    the live console against the candle: one state request when the row
    opens, then nothing. The timer now lives on a ref and restarts only when
    the board or its channels change. The reading also gets a READ NOW
    button.
2026-10-18 generic-boards §6n: the candle also browned out with no update in flight
2026-10-19 generic-boards §6n: the later brownout was the candle being handled
2026-10-19 Candle: keep it lit with an ambient loop, run it on the battery setting
    The candle's board was set to mains power and drained its cell to 3.53 V
    in a day, then browned out and came back with the output off. The site's
    candle page now says how to keep it lit all evening (an ambient loop,
    which the show's modes then own) and to tick On battery for a candle on
    its own cell. Recorded in generic-boards §6n and status.md.
2026-10-19 generic-boards: the bridge's mute reboot, caught by the instruments
2026-10-19 Mesh: count frames the radio accepted but never completed
    Registers the ESP-NOW send callback and keeps tx_sent / tx_done /
    tx_failed; the difference, tx_inflight, is what the WiFi driver still
    holds. A count that only grows is the TX buffer leak of esp-idf #18682
    (docs §6j), which ends in every send failing with NO_MEM. The mesh
    command reports the four and tx_stuck_s (8+ in flight, no completion
    for 5 s). Nothing acts on it yet: this is the instrument.
2026-10-19 mesh command: report free heap, largest block and low-water mark
    The driver's dynamic TX buffers come from the heap, so a bridge whose
    heap runs out fails sends with NO_MEM just like the buffer leak would.
    The number tells the two apart.
2026-10-19 Heap forensics for the bridge: windowed minimum, command ring, mute record
    The main loop samples free heap; mesh reports the lowest value since it
    was last asked, the WebSocket client count, and the last 16 commands
    handled with the heap before and after each. The mute record now also
    carries frames in flight and free heap / largest block at the moment it
    fires. The bridge boots with about 38 KB free and the loop has seen it
    at 12 KB within half a minute; the driver's dynamic transmit buffers
    come from that heap.
2026-10-19 Heap forensics: failed-allocation hook, sudden-drop ring by loop step
    The heap library's failed-alloc callback records the size and function
    of every allocation that fails, the moment NO_MEM becomes real; mesh
    reports the count and the last six, and the mute record carries the
    count. The main loop samples after every step, numbered, so a drop of
    6 KB or more between samples is laid at a step's door; mesh reports the
    last eight and the step at the window's minimum.
2026-10-19 Bridge mute: heap headroom and a full radio rebuild (docs §6j steps 0 and 1)
    Headroom: the show engine (31.9 KB) exists only once a board has a
    sequence or a rule to hold — a bridge holds none; a WebSocket client's
    4 KB buffer exists only while a message is coming in. Every reader of
    the engine copes with its absence; set_sequence and set_rules create it.
    Rebuild: pm_mesh_recover now takes the whole WiFi driver down and up
    (WiFi.mode OFF then STA, the core's esp_wifi_deinit), since a driver
    whose transmit allocations have failed keeps its wedged queue through
    an ESP-NOW re-init (esp-idf #18682). pm_radio_rebuild wraps it: notes
    why in last words with the counters, re-applies the sleep ti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
2026-10-20 C6 SuperMini: the charger is a TP4054 at 100 mA (PR3 10 kΩ); power path noted
2026-10-20 C6 SuperMini charger: what raising PR3 would do
2026-10-21 Mesh: a board that has never heard anyone searches properly for the mesh
    Fresh out of the installer a board starts on channel 1 and swept 13
    channels at 1 s each every two minutes: one chance in three per pass of
    catching the bridge on 11. A new C6 sat on 1 for ten minutes as its own
    conductor. Until a board has heard a frame from any PropMesh board it
    now starts sweeping 5 s after boot, dwells a heartbeat period plus a
    second per channel, stops on the first valid frame of our net, and
    sweeps again after 5 s. Boards that have heard someone keep the old
    rules. Design note in generic-boards §6d; bench test in status.md.
2026-10-21 Fresh-board search: tried on the new C6, joined in 60 s from channel 1
2026-10-21 Fresh-board search: the real power-cycle test — bridge heard 64 s after boot
2026-10-22 Mesh: a fresh sweep stops only on the bridge; fresh means never having followed one
    Stopping on any PropMesh frame let two fresh boards sweeping together
    stop on each other's channel with no bridge there. Now only a bridge
    frame ends the sweep, a board is fresh only while it has no stored
    channel (so a configured board whose bridge is off keeps the slow
    search and its show), and a fresh board that finds no bridge in five
    sweeps drops to the slow search too.
2026-10-22 Bridge: a reply goes only to the console that asked
    Every reply and timeout went to every connected console, matched by
    request number; two consoles whose numbers collided (a browser counting
    from 1 for hours, the server's tools from 1001) handed one the other's
    reply or 'no reply from node', and a page reload fixed it by restarting
    the numbers. pm_link_request now carries the client slot, replies and
    timeouts go back to it alone (pm_ws_send_to), and events still go to
    everyone. Flash page: hold BOOT only for the factory program on a C3 or
    C6. Design notes updated.
2026-10-22 Bridge: forget a console's unanswered requests when its slot closes
2026-10-22 Bridge: three console slots
    Two slots meant a laptop plus the server's watch tool left no room for
    a phone, and any third connection evicted the quietest, often the
    laptop. Client buffers are allocated only while a message arrives, so
    an idle slot costs a socket. Bridge heap is 70 KB after the headroom
    work.
2026-10-22 generic-boards §6d: reply routing tested on the bridge, three console slots
2026-10-22 Bridge mute: matched to esp-idf #18682, fix proposal, bridge.py watch
    The bridge's two self-reboots on 2026-10-18 (neighbors heard, none hear
    us, ESP_ERR_ESPNOW_NO_MEM) match espressif/esp-idf #18682: ESP-NOW
    broadcast sends leak WiFi TX buffers on IDF 5.5.x until every send
    fails; receiving keeps working; only a full driver teardown or a reboot
    recovers. generic-boards §6j records the evidence, what does not fit,
    and a three-step fix for Colin to choose from. tools/bridge.py gains
    'watch', which logs the bridge's counters once a minute over short
    connections.
2026-10-22 generic-boards §6j: what the disassembly shows; watch logs the send-callback counters
2026-10-22 generic-boards §6j: overnight measurements — no leak in 36k frames, heap down to 4 KB under load; revised proposal
2026-10-22 generic-boards §6j: cause found — the router's once-a-minute mDNS burst starves the bridge's heap
2026-10-22 generic-boards §6j: cause found — the router's once-a-minute mDNS burst starves the bridge's heap
    bridge.py watch also logs the windowed heap minimum, the failed-allocation
    count, the client count and the command ring.
2026-10-22 generic-boards §6d: reply routing tested over the mesh too
2026-10-22 Console: the node editor tries a few times before saying no reply
    A fresh board sends heartbeats while it sweeps channels, so the console
    lists it and asks for its config before it has settled on the bridge's
    channel; the first request timed out and the editor showed 'no reply'
    until Try again. It now tries four times, four seconds apart, saying
    the board may still be settling, before showing the error.
2026-10-24 Bridge under load: notes from four nodes and an OTA; in-flight count restarts with the radio
    With four boards relaying and two consoles the bridge idles at 49 KB
    free; an OTA on top ran it out, the 15 s evidence rebuild fired as
    designed, and the bridge then browned out on the server's shared USB
    hub. Recorded in generic-boards §6j and status.md with the actions:
    the bridge on its own supply, paced OTA chunks, the one-in-flight
    queue as the next step. Frames in flight when the driver is torn down
    never complete; pm_mesh_recover resets the count so that is not read
    as a leak.
2026-10-24 Mesh: a send queue, one frame in flight at a time
    esp_now_send refused frames with NO_MEM, and some it accepted never
    completed, when a 2.7 KB OTA chunk went out as eighteen frames back to
    back with the heap fine (2026-10-23). Every send and relay now goes
    through a 32-frame queue; the next frame leaves when the last one's
    completion arrives, or after 60 ms if it never does (tx_lost). Time
    beacons are stamped as they leave. The mesh command reports tx_lost,
    tx_queue_full and tx_queue_max; a growing tx_lost is evidence for the
    15 s rebuild, and eight dispatches with no completion is tx_stuck_s.
2026-10-24 Mesh send queue: dispatch from its own task, woken by the completion
    Pumped from the main loop, a frame left once per loop pass, and the loop
    is slow while it parses OTA chunks: an image took 13.6 min and the queue
    filled 30 times, though with zero send errors and no radio rebuild. A
    small task now sends the next frame the moment the radio confirms the
    last one; the queue sits under a critical section since pushes come
    from the loop task.
2026-10-24 generic-boards §6j: the send queue measured — our bursts gone, the driver still fails under TCP load; what is next
2026-10-24 bridge.py ota: survive the bridge dropping the connection mid-transfer
    A radio rebuild or a restart on the bridge kills the console socket;
    the board keeps the partial image for ten minutes. Reconnect, ask
    ota_begin where it got to, and carry on from there, up to six times.
2026-10-24 generic-boards §6n: Candle 1's fourth rollback, on the shared USB hub
2026-10-24 Console: a console served inside a PropMesh site takes that site's firmware as the release
    On the dev site on the server the console offered the published
    release and showed a board on the dev build as needing an update. A
    console at …/propmesh/console/ now uses that site's own firmware
    folder; the published site resolves to the published release as
    before, and a console served on its own keeps using it. The button and
    the check line say 'this site's build' when that is what it is.
2026-10-24 Console: over the mesh, one update at a time — the other Update buttons wait
    The bridge can carry one image at a time, and the page already streams
    to boards in turn; the buttons said otherwise. While one board is being
    sent, every other Update and Update all are disabled, with the reason
    in the tooltip. Over WiFi the boards fetch their own images, so nothing
    changes there.
2026-10-24 Buffers on demand: 30 KB of static RAM back to the heap
    The three reassembly slots (13 KB) exist only while a message is
    coming in; the event/reply line buffer and the mesh reply buffer are
    borrowed per call; the serial line buffer is allocated on the first
    serial byte, which a WiFi bridge never sees; the two PmSequence
    temporaries are per call; the send queue is 16 frames on a 2.5 KB
    stack. Static RAM on the DevKit 97.3 → 67.6 KB. A bridge serving five
    boards and two consoles had crashed at 18 KB free with 690 failed
    allocations. Host tests pass.
2026-10-24 Bridge: turn an OTA chunk away when contiguous heap is low; forward requests without copying the payload
    A chunk in flight costs the bridge about 25 KB and the router's
    multicast burst about 40 KB; when both landed at once the WiFi
    driver's own allocations failed and the radio wedged. The bridge now
    answers 'bridge busy' to an ota_data when its largest free block is
    under 44 KB; the console and bridge.py already treat that as transient
    and retry in a moment. Routing a forwarded request parses only id,
    node and cmd, so an OTA chunk's 3.6 KB payload is no longer copied
    into a document for nothing; a request handled on the bridge, or one
    the show mirror reads, still gets the full parse.
    Co-Aut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
2026-10-24 Mute watchdog: rebuild the radio only for frames going missing, once per ten minutes
    A starved heap also makes sends fail, and rebuilding the driver
    re-allocates ~50 KB into a fragmented heap, which made the next failure
    sooner: six rebuilds in eighteen minutes, 72 → 25 KB free. Only the
    wedge signature (frames handed to the radio that never complete) now
    triggers the early rebuild, at most once per ten minutes; a heap
    problem gets the two-minute path's reboot, which is the cure for it.
2026-10-24 API: a reboot command — the one cure for a fragmented heap
2026-10-24 generic-boards §6j, status: the fresh-bridge baseline with the whole set
2026-10-24 Builds carry their branch and their build time; the console says when a board is newer
    A build's name is now <commit>[+edits][@branch]: main stays plain,
    dev reads @dev, a branch build names its branch, so a board flashed
    by hand for testing says so in the console. Every build also carries
    the UTC seconds it was built (PM_BUILT, hello.built, version.json),
    and the Firmware page uses it: a board on a build newer than the one
    the site serves reads 'newer than this site's build' in amber, with
    the build time, instead of being offered the older release as an
    update. Commit names have no order of their own. The dev site's build
    script names its branch.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
2026-10-24 Console: the phone frame
    Under 700 px the console gets a phone layout (docs/console-phone.md):
    a STOP ALL bar across the top of every view with the mode and bridge
    state beside it, a bottom tab bar (Yard, Nodes, Sequences, Show, More),
    the Yard's detail panel as a bottom sheet that the back gesture closes,
    the Show view's columns stacked, and a dismissable one-line hint on
    the timeline and the show graph that they are easier sideways. A
    web-app manifest, icons and the viewport metadata make 'Add to Home
    Screen' open it full-screen in the dark theme; inputs are 16 px on
    phones so Safari does not zoom. The laptop layout is unchanged.
2026-10-24 Console: on a phone, each pin is a wrapping card
    The six-column pin rows ran past a phone's width: the name field and
    the advice text sat at 450 to 790 px. On a phone each pin's parts now
    wrap into a card and the column headings go with the columns. Checked
    against the live boards: nothing past the right edge.
2026-10-24 Console: pin options on a phone are a settings list
    Each option is a row, label left and control right; a checkbox row
    reads like a switch row; sliders and selects run full width; buttons
    are thumb-sized. Scoped to the phone layout under the pin cards; the
    laptop rows are untouched.
2026-10-24 Console: the connect panel stacks on a phone
    Words, then the bridge address with its Connect button, then the USB
    and simulated ways as full-width rows. The USB row is hidden where the
    browser has no Web Serial (Safari), and the hint says to type the
    bridge's address instead.
2026-10-24 Console: a pin card's settings drawer on a phone
    Hover tooltips never show on a phone. Each assigned pin's card gets
    one chevron at the end of its header line; it opens a drawer listing
    every setting on the pin with its explanation, taken from the card's
    own labels, plus the function name, the pin note and the candle
    guide link. The candle and fire boxes' own ? is hidden on a phone.
2026-10-24 Console: the pin drawer opens from an info mark, not a chevron
2026-10-24 Console: pin cards on a phone, audited across every kind
    The header is one line on every card (the select shrinks, the tag
    never wraps, the info mark closes the line) and the name box takes its
    own; the mark had wrapped beside the name box on a long function name.
    A slider's line carries its value; buttons follow, a third wide at
    least, words unwrapped; readouts precede buttons. The battery formula
    is a hint and its meter box no longer says V twice.
2026-10-24 Console: boards remembered, in name order, asleep marked, hideable; live state
    The console keeps a roster per mesh in the browser: every board it has
    met, with its last hello and when it was heard. On connect they are
    all on the list at once — a battery board asleep since last night
    shows zzz with its sleep age instead of being invisible until its next
    check-in. Remembered boards that have not spoken are not polled.
    One order everywhere: the bridge, then any hand order, then by name,
    instead of hop count and id. A mains board not heard gets a ✕ to hide
    it; hidden boards sit under '+N hidden' with forget; a hidden board
    that speaks again is unhidden by itself.
    A board's page re-reads it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
2026-10-24 Console: a sleeping board can be hidden, behind a confirm; layout opinion and battery design
    The confirm says when the board was last heard, when it next checks
    in, and that hiding only takes it off the list until it is heard
    again. docs/console-nodes-list.md gains the B-vs-C opinion (B, with a
    live second line fed by the heartbeat) and §8, the design for ran
    out / low / a central alarm / an on-board drain-rate estimate.
2026-10-24 Console: the node list is a column beside the editor; arrange; battery marks and alarm
    Boards list one per row with a state mark, name and a line of facts.
    On a laptop the column sits left of the editor, which never moves; on
    a phone the Nodes tab is the list and a tap opens the board's page
    with a back header. Arrange mode orders the boards by drag or arrows,
    kept in the roster. Battery boards show low / critical / overdue /
    ran out? from their last voltage and check-in grid, and the phone bar
    and laptop sidebar carry a battery alarm listing them. Counts say
    asleep apart from missing, and hidden boards leave the counts and map.
2026-10-24 Battery: the board measures its own drain; the console says whether it will last the show
    A battery board logs its resting voltage once an hour in RTC memory
    (at sleep entry, or hourly while awake), restarts the log when it is
    charged, and once the log spans 20 h reports the fall per hour in its
    hello. The console turns that and the voltage left above cutoff into
    hours, compares them with the end of the next show window from the
    boards' mode block, and writes 'should last tonight', 'about N nights
    left' or 'not likely to last the next show' on the board's row, the
    last also raising the battery alarm. Always with its basis. Both
    firmware builds pass; untested on a board (status.md §2).
    Co-A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
2026-10-24 Console: the yard map on a phone — every overlay has a place; tap to place a board
    Header: chips, health and short counts. Under it the Links chip and
    the 'Not on the map' bar, with the scale, save state and fullness at
    the right. The drawing tools are a strip along the bottom, zoom
    buttons above it at the right, and the instruction panel shows only
    while something is selected, drawn or placed; idle hints and the
    legend text are laptop-only. A board is placed by tapping its chip
    and then the map, since touch has no drag; selection is held off for
    a beat after a placement so the new node doesn't take the tap.
2026-10-24 Yard map: locked unless editing; two-finger pinch zoom
    The map opens locked: boards and shapes can be tapped but not moved,
    and the tools, panel and shortcuts are off until Edit is pressed;
    Done locks it again. On both the laptop and the phone, since a stray
    grab moved things on both. Touch gets a pinch: two fingers zoom about
    their midpoint and pan with it, and a second finger ends any
    one-finger drag.
2026-10-25 Console: views poll only boards heard this session; a waking board reloads them
    A remembered board carried a hello from connect, so the Show, Schedule,
    Floods, Firmware and Yard loads asked it at once (timing out) and never
    re-ran when it actually woke, leaving its outputs out of the sequence
    picker. Views now key on isReachable (hello and heard this session),
    which changes when a remembered board first speaks.
2026-10-25 Console: saving and playing sequences while boards come and go, audited; floods from the bridge's copy
    Every board-away scenario for a save, play or delete is listed with
    its old and new behavior in docs/console-show-sync.md. Built: the view
    reloads when a board is heard again; an away board keeps its pins,
    part and rules from the last read or the bridge's copy, so a board
    going to sleep no longer shortens a saved sequence; Play is gated on
    the connected board's mode alone and names the boards that won't join;
    a stale reply counts as not saved; a Send again button for boards that
    missed a save; the away watcher asks only boards being heard; a save's
    confirmation survives the reload. The Floo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
2026-10-25 Console: the show follows boards catching up; firmware updates run outside the panel; rollbacks read as failed
    The Sequences view reloads when any board's show_synced stamp moves,
    so a board that pulled a saved part from the bridge shows up by itself,
    with a spinner while it is catching up; the save-scoped hello watcher
    is gone. Firmware transfers and their come-back check live in a store
    (lib/otaJobs), so leaving the Firmware panel no longer stops one, and
    the node list shows progress. A board back on its old build after a
    different one was sent reads as rolled back, with its restart reason,
    instead of '✓ updated'. Battery thresholds moved onto the real curve
    (20 % / 10 %). The simulator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
2026-10-25 Console: a phone held sideways keeps the phone layout; the Show page laid out for a phone
    The breakpoint now covers a touch screen under 520 px tall as well as
    one under 700 px wide, so landscape no longer flips to the laptop
    layout; the top bar and tabs shrink in landscape. The Show header is
    three equal mode buttons with Schedule and Reload under them; the
    graph's palette is a chip strip above the canvas on a phone; Activity
    sits beside the graph in landscape. The sequence editor's header puts
    Save and Play on their own row, and the sequence list is a chip strip
    in portrait.
2026-10-26 Console: the battery divider calculator behind a button, with how to measure
    The meter box after the divider field becomes 'Calculate from a
    meter…', which opens the instructions (battery connected to the board,
    outputs quiet), the meter box, the board's own reading, and the Use
    button. The battery page on the site says the same.
2026-10-26 Sleep management: a setup window after power-on, stay awake next time, update when awake, power off; asleep vs off vs out of range
    Firmware: a battery board switched on by hand stays awake 3 min before
    its sleep pattern; hello reports how long a hold has left; power_off
    turns the outputs off and sleeps with no wake source. Console: a
    sleeping board can be asked to stay awake at its next check-in (the
    console sends the hold when its heartbeat arrives); the Firmware panel
    queues sleeping boards and updates each at its check-in, one transfer
    at a time, skipping a critical battery; a quiet board reads asleep only
    while its silence fits its check-in grid, and otherwise missed check-in,
    off or unp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
2026-10-26 Sleep: never sleep while a new image is unconfirmed
    A battery board updated while the show was off slept 6 s after the
    update's restart, before the 20 s mark that confirms the image; its
    next restart booted the unconfirmed image and the bootloader rolled it
    back (Candle 3, 2026-10-26).
2026-10-26 Sleep: announce going to sleep; a stay-awake request yields to a fresh power-on; mark quiet boards off
    The last heartbeat before deep sleep (and before Power off) carries a
    new NodeRole flag, SLEEPING, and the console marks the board asleep on
    receipt instead of after 16 s of silence. A waiting 'stay awake next
    time' is spent without a hold when the board is already in its setup
    window, so a power-cycle no longer turns 3 min into 10. A quiet board
    can be marked off from its page, or every quiet board at once from the
    list header; they read switched off until heard again. The doubled
    'ran out?' is gone.
2026-10-26 Console: a check-in no longer reads as missed
    A board that announced it was going to sleep had its last-heard time
    back-dated so it showed asleep at once; that put it before the slot it
    had just checked in for, and every check-in read as missed. Keep the
    real time and mark it quiet from the announcement instead. A board heard
    up to 20 s before a slot (it wakes inside its guard, early) also counts
    for that slot.
2026-10-26 Console: a rollback no longer blames the supply; judge an update on a hello from the current boot
2026-10-27 Docs: battery boards that brown out on every wake can't confirm a new image
2026-10-27 Status: the USB-power test for the rollbacks
2026-10-27 Radio: 13 dBm while a new image is on probation, and for good on a board that browned out
    Candle 1 (a C6 SuperMini) trips its brownout detector at full transmit
    power after a normal restart, on USB power too; the framework lowers the
    power after that reset, so it ran on, but a new image reset that way
    before its 20 s confirm was rolled back — no update could stick.
2026-10-27 Docs: the full-power brownout on Candle 1, the 13 dBm fix, and what's left
2026-10-27 Radio: 13 dBm only while a new image is on probation; a board waiting for its clock doesn't sleep
    Colin: a reboot per wake is preferable to less range, so the cap is
    only for the 20 s probation. The board's second boot after that
    brownout has no wall clock; the show read 'waiting for the clock' (off)
    and the board slept 6 s later, through the show window. It now stays
    awake until it has the clock or pm_show gives up waiting. The console
    no longer reads a brownout as a sign of a flat battery.
2026-10-28 Docs: Candle 2 flashed over USB; it browns out at full power too
2026-10-28 Floods: a board's restart no longer switches them off; the panel remembers each light's color
2026-10-28 Console: edit a sleeping board's settings; they go out at its next check-in
    The console keeps a copy of each board's pin settings in the browser,
    so an asleep or remembered board's page shows them and can be edited.
    A save waits for the board's next heartbeat, is sent only if the board
    still has the settings it was edited from, and the board is then let
    sleep again unless something else holds it.
2026-10-28 Docs: proposal to keep board copies and waiting settings on the bridge
2026-10-28 Bridge keeps every board's settings and delivers waiting changes at check-ins
    The bridge copies each board's hello and pin settings from the console
    traffic passing through it, keeps a change saved for a sleeping board,
    and delivers it at the board's next check-in with no console open.
    Boards now stamp their settings and report the stamp in heartbeats
    (cfg_at), so the bridge sends nothing when its copy is current; older
    boards are read once instead. Stay-awake-next-time moves to the bridge
    too. The console reads the copies from a bridge that has them and keeps
    its browser copy as the fallback.
2026-10-28 Copies: visits never stretch or cut short a board's hold
    A visit's requests are marked bg: boards from today hold 3 s for them, so
    nothing needs releasing. Older boards are visited only when nothing else
    holds them, so the release can't cut short a sensor wake, a sync pull or
    the setup window, and the 6 s dwell after a reset (Candles 1 and 2, the
    Lantern) no longer reads as a hold. Stay awake next time is spent only in
    the setup window, in the console too. The copy's list name follows a
    delivered change.
2026-10-28 Copies: count a console at work when the board answers, not when asked
    Requests sent to a sleeping board never arrive, yet they counted as a
    console working on it, so the bridge left Candles 1-4 and 6 held awake
    after their first visit (a console reload had just asked every board).
    Candle 5, unknown to that console, was released and slept. The count
    now starts when the board answers, and a visit releases only for a
    console request answered during the visit itself.
2026-10-28 Console: surveys are background reads and let a free battery board sleep again
    The Show, Yard and Floods views read every board at once, and any such
    request held a battery board awake 10 min: six candles waking in one
    slot were held and renewed each time one was heard. Survey reads now
    carry the bg mark (boards from 2026-10-28 hold 3 s for them); an older
    battery board that was free is asked its hello first and let sleep again
    after the survey. Also the brownout research in the design notes.
2026-10-28 Bridge: turn work away when memory runs low
    An OTA chunk now also waits below 64 KB free in all (it waited only for
    a 44 KB block): at 74 KB free the bridge took Candle 2's chunks and other
    traffic ran it to 3.9 KB, the WiFi driver's receive buffers failed and
    the radio went mute. Any other request for a board, and the bridge's own
    show and board copy replies, wait below 40 KB. The copies stay out of the
    way below 56 KB and while an update streams through.
2026-10-28 Console: surveys don't read a held battery board on old firmware
    Any read renews such a board's 10-min hold, so the next survey found it
    held again: Candles 1, 3, 4 and 5 stayed awake 30 min to 3.5 h. A held
    old board is now not asked at all, and each view uses its last copy, as
    for a board that doesn't answer.
2026-10-29 Bridge: manage the mesh's traffic while an update streams through it
    From the first OTA chunk until 15 s after the last, reads for other
    boards go one at a time (at most 3 waiting; past 3.5 s they are told the
    bridge is busy), the bridge's copy visits wait, and consoles hear an
    "updating" event. Chunks for a board the bridge hears at -86 dBm or
    better go single-hop (TTL 0) with 4 ms between frames instead of 15, so
    the relays stay quiet; an unanswered one is resent by flood under the
    same request number. ota_end gets 2.5 s before a resend. Memory lines:
    56 KB free and a 16 KB block (were 64 KB and 44 KB).
2026-10-29 Console: hold Show reloads during an update; stop polling sleeping boards
    The Show view keeps what it shows while the bridge streams an image and
    reads the boards again when the update is over. A board that said it was
    going to sleep is not asked for its hello until it is heard again; one
    gone quiet without saying so is asked once a minute. "No update in
    progress" from ota_end after the last chunk counts as taken.
2026-10-29 Fire: a strip that starts at the top
    The fire's layout assumed a strip's first pixel is at the bottom, so a
    strip fed from above burned upside down. "starts at top" in the FIRE
    row (from_top in the config) turns the first column the other way;
    zigzag still alternates from there. The mapping moves to pm_fire_pixel
    in pm_config.h, host-tested against the lantern's table and the same
    table upside down. from_top is written only when ticked, so no other
    board's stored settings change.
    The phone's info drawer skipped every checkbox setting: it named a
    setting by its label's first text, and a checkbox label starts with
    the box. It now lists them.
    (The same change as c987287 on fire/starts-at-top,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
